lingluo831/mymoteus/docs/架构.md

# Moteus 项目文件结构说明

根目录文件
.bazelrc: Bazel构建系统的配置文件，设置构建选项和预设
.gitignore: Git版本控制忽略文件列表
.travis.yml: Travis CI持续集成配置文件
BUILD: Bazel构建配置文件
CMakeLists.txt: CMake构建系统配置文件
LICENSE: 项目许可证文件
make_release.py: 自动化发布流程的Python脚本
moteus-debug.gdb: GDB调试器配置文件
README.md: 项目概述和使用说明文档
travis-ci.sh: Travis CI构建脚本
tsconfig.json: TypeScript配置文件
WORKSPACE: Bazel工作空间定义文件
configs/ 目录
包含各种硬件和开发套件的配置文件：

20200122-beta-devkit-6008.cfg: 6008型号测试开发套件配置
20200819-devkit-4114.cfg: 4114型号开发套件配置
20210504-qdd100.cfg: QDD100模块配置
20220407-devkit.cfg: 2022年4月版本开发套件配置
20220719-devkit.cfg: 2022年7月版本开发套件配置
docs/ 目录
包含项目文档和图表：

aksim2_adapter.odg/png: aksim2适配器硬件图表
api_brainstorm.md: API设计思路文档
control_structure.odg/png: 控制系统结构图
getting_started.md: 入门指南
io_structure.odg/png: 输入输出接口结构图
moteus_n1_cui_amt21.odg/png: N1型号设计图
power_dist.md: 电源分配说明
raspberry_pi.md: 树莓派集成指南
reference.md: 技术参考文档
fw/ 目录（固件源代码）
主要包含固件源代码和头文件：

传感器和外设接口
as5047.h: AS5047传感器接口
cui_amt21.h: AMT21传感器接口
ma732.h: MA732传感器接口
电机/伺服控制
bldc_servo_position.h/cc: BLDC伺服定位功能
motor_driver.h: 电机驱动器接口
motor_position.h: 电机位置控制
moteus_controller.cc/h: 核心电机控制算法
通信和总线接口
can_bootloader.cc: CAN总线引导程序
fdcan.cc/h: FDCAN总线功能实现
fdcan_micro_server.h: FDCAN微服务器
硬件抽象层
board_debug.cc/h: 板级调试功能
bootloader.h: 引导程序定义
clock_manager.h: 时钟管理
moteus_hw.cc/h: 硬件抽象层
控制算法
foc.cc/h: 磁场定向控制算法
pid.h: PID控制器
simple_pid.h: 简化版PID控制器
工具和系统信息
error.cc/h: 错误处理
firmware_info.cc/h: 固件信息
system_info.cc/h: 系统信息
uuid.cc/h: 唯一标识符处理
hw/ 目录（硬件设计文件）
包含各种硬件设计文档和KiCad文件：

hw/c1/: C1型号板子设计文件
hw/controller/: 控制器板设计文件
hw/ma732_adapter/: MA732适配器设计
hw/n1/: N1型号设计文件
lib/ 目录
包含库文件：

lib/cpp/: C++库文件
lib/python/: Python库文件
qualification/ 目录
硬件/软件性能测试脚本：

pwm_rate.py: PWM频率测试
qdd100_torque_vs_speed.py: QDD100扭矩速度测试
voltage_ripple.py: 电压纹波分析
tools/ 目录
构建和项目管理工具：

bazel: Bazel构建工具
python.bzl: Python构建规则
workspace_status.sh: 工作空间状态脚本
utils/ 目录
实用工具和辅助脚本：

calibrate_encoder.py: 编码器校准
clock_cal.py: 时钟校准
compensate_cogging.py: 齿槽转矩补偿
decode_can_frame.py: CAN帧解码
dynamometer_drive.cc: 测功机控制
firmware_validate.py: 固件验证
moteus_tool.py: Moteus配置工具
plot_cal_phase_currents.py: 相电流校准绘图
tview.py: 文本界面监视器
总结
该项目包含固件代码、硬件设计、多种构建系统配置、测试脚本和各类实用工具。每个文件都在项目的构建、测试、部署和维护中发挥特定作用。如需了解具体文件的详细信息，请查看相应的源代码和注释。

### **1. 电机参数的主要字段**

#### **`BldcServoMotor`**
该结构体定义了电机的物理特性和高级控制模型：

- **`poles`**:  
  电机的极对数。通常由电机的规格决定。例如，8极电机的极对数为 4。

- **`phase_invert`**:  
  是否反转电机的相序。如果电机旋转方向与期望方向相反，可以设置为 `1`。

- **`resistance_ohm`**:  
  电机的相电阻（单位：欧姆）。可以通过测量或从电机规格中获取。

- **`Kv`**:  
  电机的速度常数（单位：RPM/V）。表示每伏电压下的转速。可以通过测量或从电机规格中获取。

- **`offset`**:  
  电气相位偏移，用于校正编码器的相位误差。通常通过校准过程确定。

- **`rotation_current_cutoff_A`**:  
  电流的分界点（单位：安培）。用于高级磁饱和模型。

- **`rotation_current_scale` 和 `rotation_torque_scale`**:  
  用于高级磁饱和模型的比例因子。如果不需要高级模型，可以使用默认值。

- **`cogging_dq_scale` 和 `cogging_dq_comp`**:  
  用于补偿电机齿槽效应的参数。如果电机齿槽效应较小，可以忽略。

---

#### **`BldcServoConfig`**
该结构体定义了电机的运行限制和控制参数：

- **`pwm_rate_hz`**:  
  PWM 频率（单位：Hz）。通常设置为 15kHz 到 60kHz，具体取决于硬件和效率要求。

- **`current_sense_ohm`**:  
  电流采样电阻的阻值（单位：欧姆）。由硬件设计决定。

- **`max_voltage`**:  
  最大输入电压（单位：伏）。根据硬件支持的电压范围设置。

- **`max_power_W`**:  
  最大功率限制（单位：瓦）。可以根据应用需求设置。

- **`max_current_A`**:  
  最大相电流（单位：安培）。通常由硬件的电流能力决定。

- **`derate_temperature` 和 `fault_temperature`**:  
  温度限制（单位：摄氏度）。当温度超过 `derate_temperature` 时，系统会限制输出；超过 `fault_temperature` 时会触发故障。

- **`pid_dq` 和 `pid_position`**:  
  D/Q 电流环和位置环的 PID 参数。需要根据具体电机和应用进行调试。

- **`bemf_feedforward`**:  
  反电动势前馈系数。根据电机的速度常数（`Kv`）计算。

- **`flux_brake_min_voltage` 和 `flux_brake_resistance_ohm`**:  
  用于 Flux Braking 的参数，定义了最小电压阈值和等效电阻。

---

### **2. 参数选择的步骤**

#### **(1) 获取电机规格**
从电机的规格表中获取以下关键参数：
- 极对数（`poles`）
- 相电阻（`resistance_ohm`）
- 速度常数（`Kv`）

#### **(2) 测量或校准**
- **电气相位偏移（`offset`）**:  
  通过固件中的校准功能自动测量。
- **齿槽效应补偿（`cogging_dq_comp`）**:  
  如果需要，可以通过实验测量并配置。

#### **(3) 设置运行限制**
根据硬件能力和应用需求设置以下参数：
- 最大电流（`max_current_A`）
- 最大功率（`max_power_W`）
- 最大电压（`max_voltage`）
- 温度限制（`derate_temperature` 和 `fault_temperature`）

#### **(4) 调试控制参数**
- 调整 D/Q 电流环的 PID 参数（`pid_dq`）。
- 调整位置环的 PID 参数（`pid_position`）。
- 根据需要启用或禁用反电动势前馈（`bemf_feedforward`）。

---

### **3. 参数配置的方法**

#### **通过配置文件**
在配置文件（如 `configs/*.cfg`）中设置参数。例如：
```cfg
motor.poles = 7
motor.resistance_ohm = 0.05
motor.Kv = 120
servo.max_current_A = 30.0
servo.max_voltage = 36.0
servo.pid_dq.kp = 0.01
servo.pid_dq.ki = 20.0
```

#### **通过命令行动态设置**
使用 CAN 或 UART 命令设置参数。例如：
```bash
conf set motor.poles 7
conf set servo.max_current_A 30.0
```

---

### **4. 参数验证**
- 使用 `moteus_tool` 工具验证电机运行状态。
- 检查电流、电压、温度等是否在安全范围内。
- 调整 PID 参数以优化控制性能。

---

### **总结**
电机参数的选择需要结合电机的物理特性、硬件能力和应用需求。通过合理设置 `BldcServoMotor` 和 `BldcServoConfig` 中的参数，可以实现高效、安全的电机控制。
