lingluo831/mymoteus/docs/使用.md

#使用
0使用*wsl -d Ubuntu-22.04*打开wsl
1*python -m moteus_gui.tview*  cmd中使用启动gui命令
2*python3 -m moteus.moteus_tool --target 1 --flash path/to/moteus.elf*烧写固件
3`moteus_tool` 是一个命令行工具，用于与 Moteus 控制器交互，执行配置、校准和调试等操作。以下是 `moteus_tool` 的使用方法和常见命令：

#在windows上编译固件
### 1. **安装必要的工具**
在 Windows 上编译 `moteus` 固件需要以下工具：

#### **(1) 安装 Bazel**
- 从 [Bazel 官方网站](https://bazel.build/) 下载适用于 Windows 的安装程序。
然后改名为bazel.exe，添加到环境变量里面
- 安装完成后，确保 Bazel 可通过命令行访问：
  ```
  bazel --version
  ```

#### **(2) 安装 ARM 工具链**
- 下载并安装 [GNU Arm Embedded Toolchain](https://developer.arm.com/tools-and-software/open-source-software/developer-tools/gnu-toolchain/gnu-rm)。
- 安装完成后，将工具链的 `bin` 目录添加到系统的环境变量 `PATH` 中。

#### **(3) 安装 Python 和依赖**
- 确保已安装 Python 3.10 或更高版本，并安装 `pip`。
- 安装必要的 Python 包：
  ```bash
  python -m pip install --upgrade pip
  python -m pip install pyserial
  ```

#### **(4) 安装 Git**
- 从 [Git 官方网站](https://git-scm.com/) 下载并安装 Git。
- 安装完成后，确保 Git 可通过命令行访问：
  ```bash
  git --version
  ```

---

### 2. **克隆 `moteus` 仓库**
在命令行中运行以下命令以克隆 `moteus` 的代码仓库：
```bash
git clone https://github.com/mjbots/moteus.git
cd moteus
```

---

### 3. **配置 Bazel**
在 Windows 上，Bazel 需要一些额外的配置：
1. 创建一个名为 .bazelrc 的文件（如果不存在）。
2. 添加以下内容以指定工具链路径和编译选项：
   ```plaintext
   build --compiler=clang-cl
   build --cpu=x64_windows
   build --host_cpu=x64_windows
   build --crosstool_top=@bazel_tools//tools/cpp:toolchain
   build --action_env=PATH=<ARM 工具链路径>;<其他必要路径>
   ```

---

### 4. **编译固件**
运行以下命令以编译固件：
```bash
bazel build --config=target //:target
```

编译完成后，固件文件会生成在 `bazel-bin/fw/` 目录下，例如：
- `moteus.elf`：主固件文件。
- `can_bootloader.elf`：引导程序文件。

---

### 5. **刷写固件**
使用 `moteus_tool` 刷写固件：
```bash
python -m moteus.moteus_tool --target 1 --flash path/to/moteus.elf
```

---

### 6. **调试固件**
如果需要调试固件，可以使用 GDB 调试器和 moteus-debug.gdb 配置文件。

---

### 注意事项
- **工具链兼容性**：确保 ARM 工具链版本与 `moteus` 的要求兼容。
- **路径配置**：在 Windows 上，路径分隔符是 `\`，确保在 .bazelrc 和环境变量中正确配置路径。
- **依赖问题**：如果遇到依赖问题，可以尝试手动安装缺失的库或工具。

---

### 1. **运行 `moteus_tool`**
   使用以下命令启动 `moteus_tool`：
   ```bash
   python -m moteus.moteus_tool
   ```

   如果需要与特定设备交互，可以指定目标 ID（`--target` 参数）：
   ```bash
   python -m moteus.moteus_tool --target 1
   ```

---

### 2. **常见命令**
以下是一些常用的 `moteus_tool` 命令：

#### **(1) 查询设备状态**
   查询目标设备的当前状态：
   ```bash
   python -m moteus.moteus_tool --target 1 --query
   ```

#### **(2) 校准电机**
   对电机进行校准（确保电机可以自由旋转）：
   ```bash
   python -m moteus.moteus_tool --target 1 --calibrate
   ```

#### **(3) 设置参数**
   设置控制器参数，例如最大电流：
   ```bash
   python -m moteus.moteus_tool --target 1 --set servo.max_current_A 30.0
   ```

#### **(4) 读取参数**
   读取控制器的当前参数值：
   ```bash
   python -m moteus.moteus_tool --target 1 --get servo.max_current_A
   ```

#### **(5) 保存配置**
   将当前配置保存到控制器的非易失性存储器中：
   ```bash
   python -m moteus.moteus_tool --target 1 --write-config
   ```

#### **(6) 恢复默认配置**
   恢复控制器的默认配置：
   ```bash
   python -m moteus.moteus_tool --target 1 --reset-config
   ```

#### **(7) 控制电机**
   发送命令控制电机，例如设置速度：
   ```bash
   python -m moteus.moteus_tool --target 1 --cmd "d pos nan vel 1.0"
   ```
   其中：
   - `pos nan` 表示不设置位置。
   - `vel 1.0` 表示设置速度为 1.0 转每秒。

---

### 3. **高级用法**
#### **(1) 实时监控**
   使用 `--monitor` 参数实时监控设备状态：
   ```bash
   python -m moteus.moteus_tool --target 1 --monitor
   ```

#### **(2) 记录数据**
   将设备状态输出保存到文件：
   ```bash
   python -m moteus.moteus_tool --target 1 --query > output.txt
   ```

#### **(3) 调试模式**
   启用调试模式以获取更多日志信息：
   ```bash
   python -m moteus.moteus_tool --target 1 --debug
   ```

---

### 4. **帮助命令**
   查看 `moteus_tool` 的所有可用选项和命令：
   ```bash
   python -m moteus.moteus_tool --help
   ```

---

### 5. **注意事项**
   - **目标 ID**：`--target` 参数用于指定目标设备的 CAN ID。如果未指定，默认会尝试与 ID 为 1 的设备通信。
   - **硬件连接**：确保设备通过 CAN 或 UART 正确连接到电脑。
   - **校准前检查**：在校准电机之前，确保电机可以自由旋转，否则可能损坏设备。

---

如果你有具体的使用场景或问题，请提供更多细节，我可以为你提供更具体的帮助！
