lingluo831/mymoteus/docs/aksim2_adapter.png

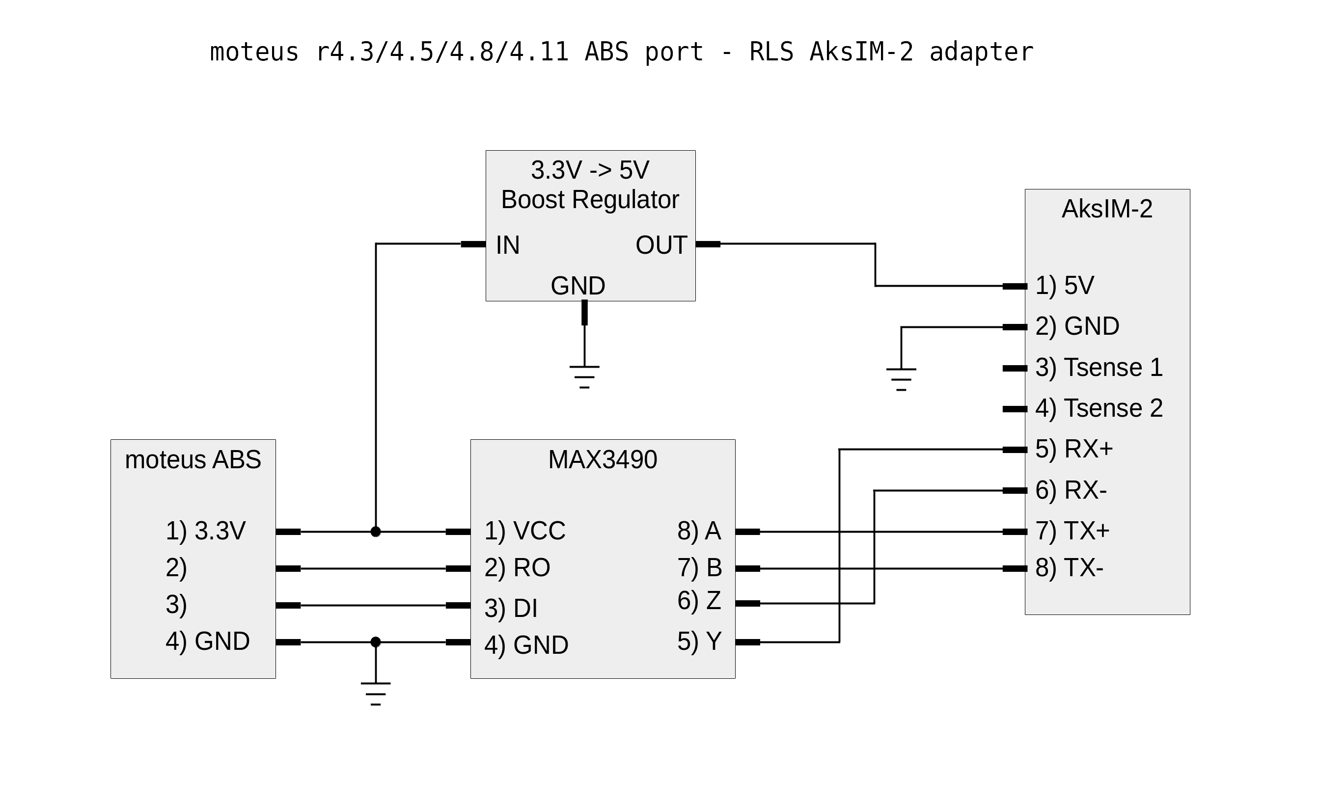
docs/aksim2_adapter.png
