lingluo831/mymoteus/docs/moteus_n1_cui_amt21.png

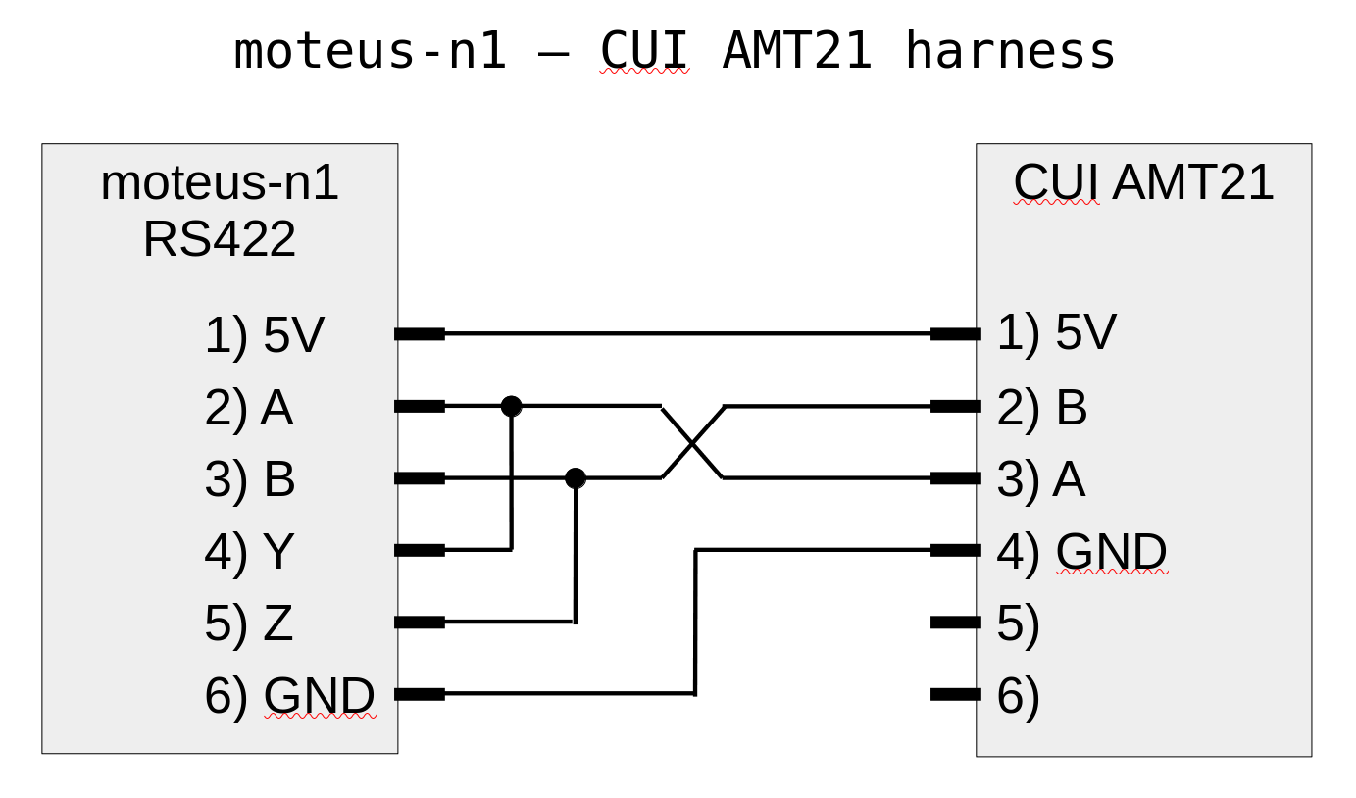
docs/moteus_n1_cui_amt21.png
