lingluo831/mymoteus/hw/c1/3d/S6B-ZR-SM4A-TF_LF__SN_.step

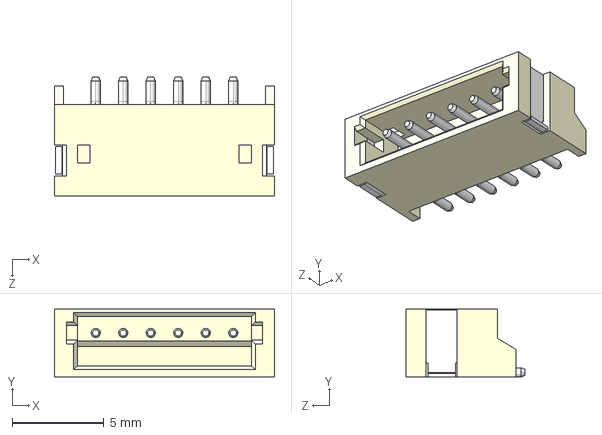
[picture p5: CAD file, 2025-04-23]
hw/c1/3d/S6B-ZR-SM4A-TF_LF__SN_.step
12.0 x 3.70 x 6.50 mm
