lingluo831/mymoteus/hw/c1/3d/DRB0008F.stp

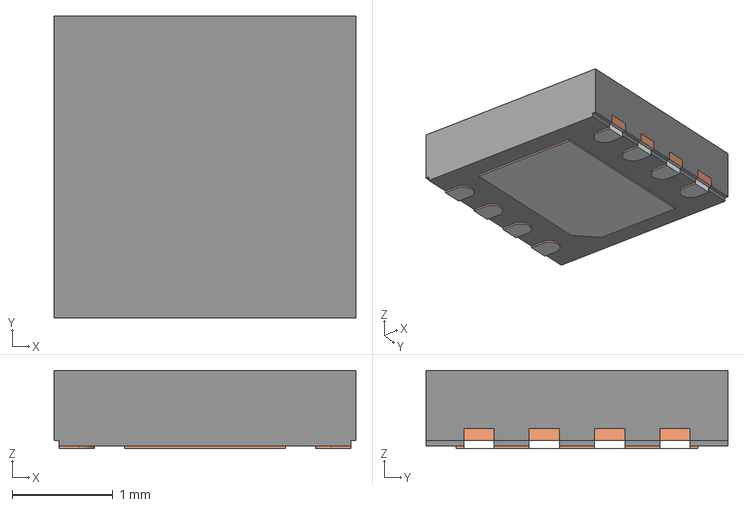
[picture p6: CAD file, 2025-04-23]
hw/c1/3d/DRB0008F.stp
3.00 x 3.00 x 0.775 mm
BODY-SON_AF0
FRAME-DRB0008F_AF0
