lingluo831/mymoteus/hw/c1/3d/XT30PW-M.step

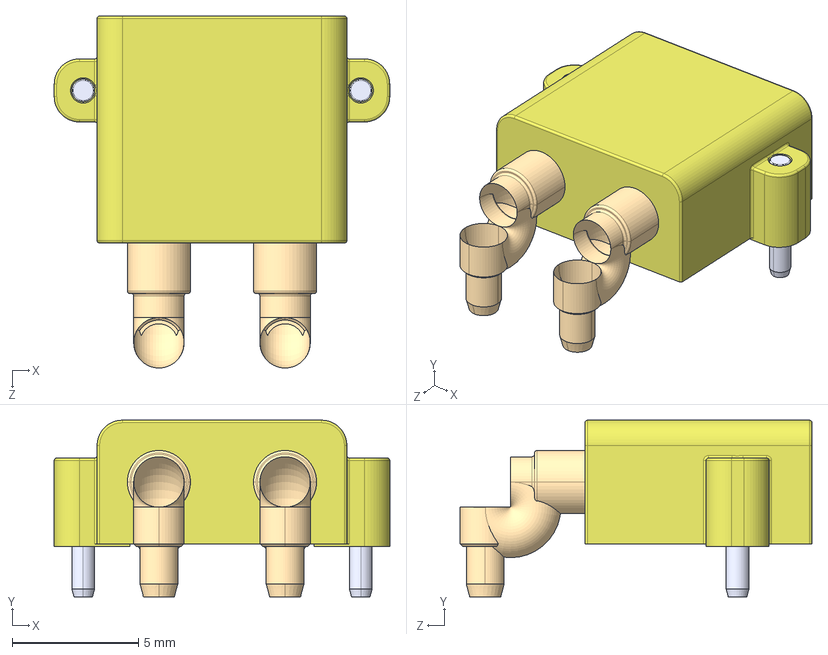
[picture p7: CAD file, 2025-04-23]
hw/c1/3d/XT30PW-M.step
13.3 x 7.00 x 14.0 mm
