lingluo831/mymoteus/hw/c1/3d/SOD-523_STM.step

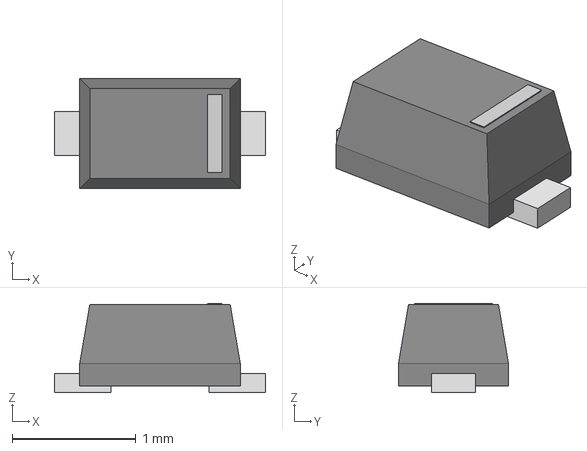
[picture p8: CAD file, 2025-04-23]
hw/c1/3d/SOD-523_STM.step
1.70 x 0.888 x 0.718 mm
