lingluo831/mymoteus/hw/c1/3d/S3B-PH-SM4-TB_LF__SN_.step

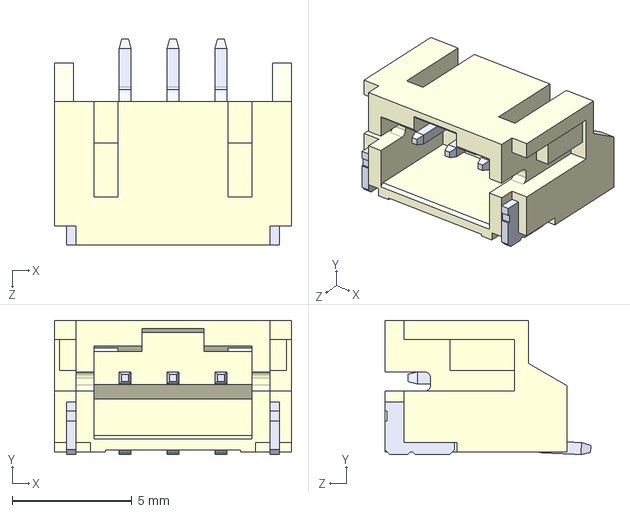
[picture p9: CAD file, 2025-04-23]
hw/c1/3d/S3B-PH-SM4-TB_LF__SN_.step
9.90 x 5.60 x 8.60 mm
