lingluo831/mymoteus/hw/c1/3d/TSSOP14_OSM.step

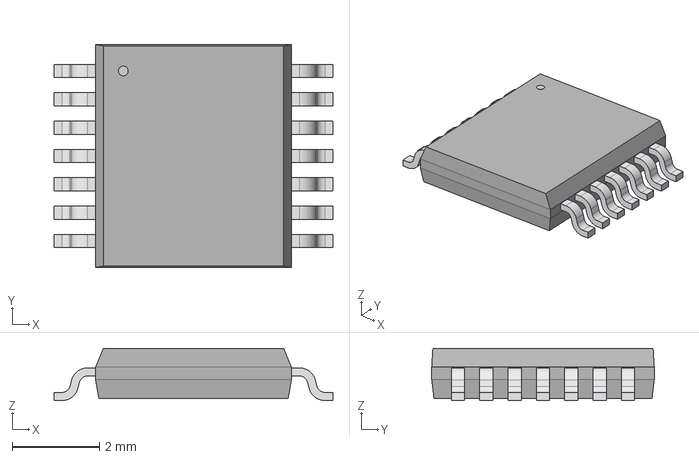
[picture p10: CAD file, 2025-04-23]
hw/c1/3d/TSSOP14_OSM.step
6.40 x 5.11 x 1.20 mm
