lingluo831/mymoteus/hw/c1/3d/IND_4018-WE-LQS_WRE.step

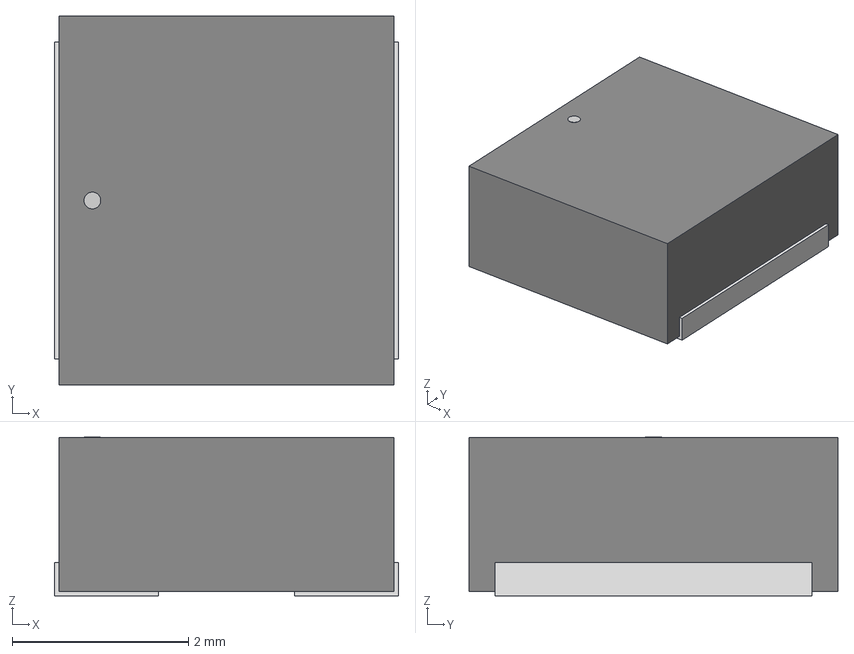
[picture p11: CAD file, 2025-04-23]
hw/c1/3d/IND_4018-WE-LQS_WRE.step
3.91 x 4.19 x 1.81 mm
