lingluo831/mymoteus/hw/c1/3d/DSE0006A.stp

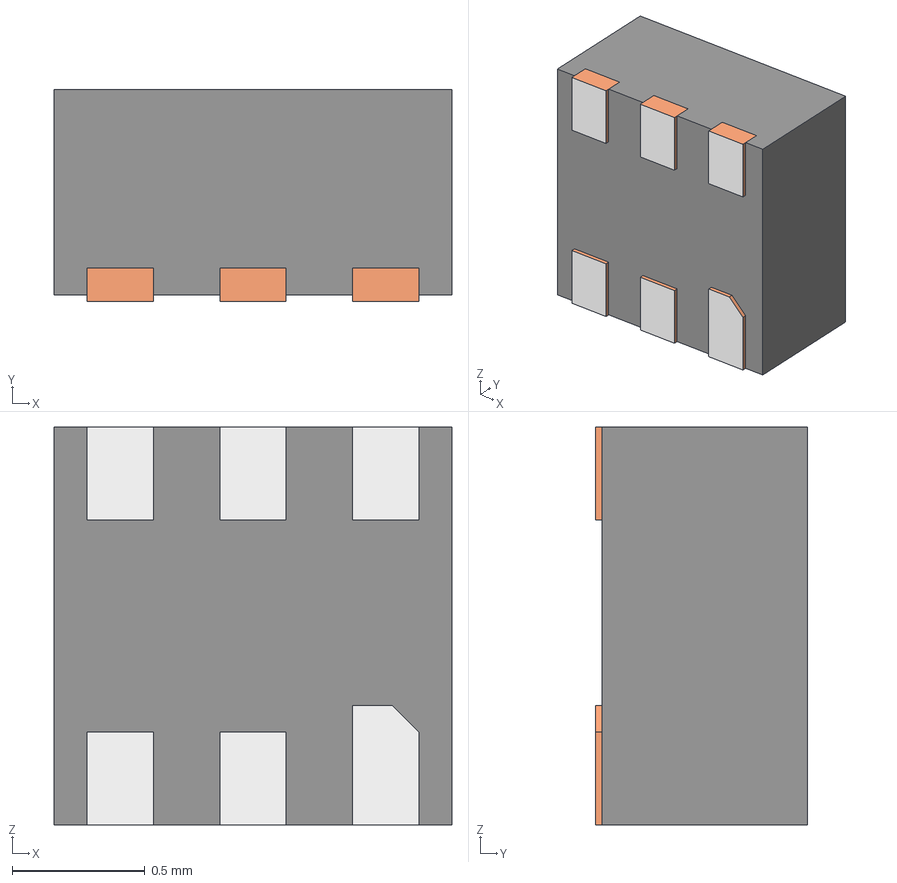
[picture p12: CAD file, 2025-04-23]
hw/c1/3d/DSE0006A.stp
1.50 x 0.8 x 1.50 mm
BODY-SON
FRAME-DSE0006A
