lingluo831/mymoteus/hw/c1/3d/RTA0040B.stp

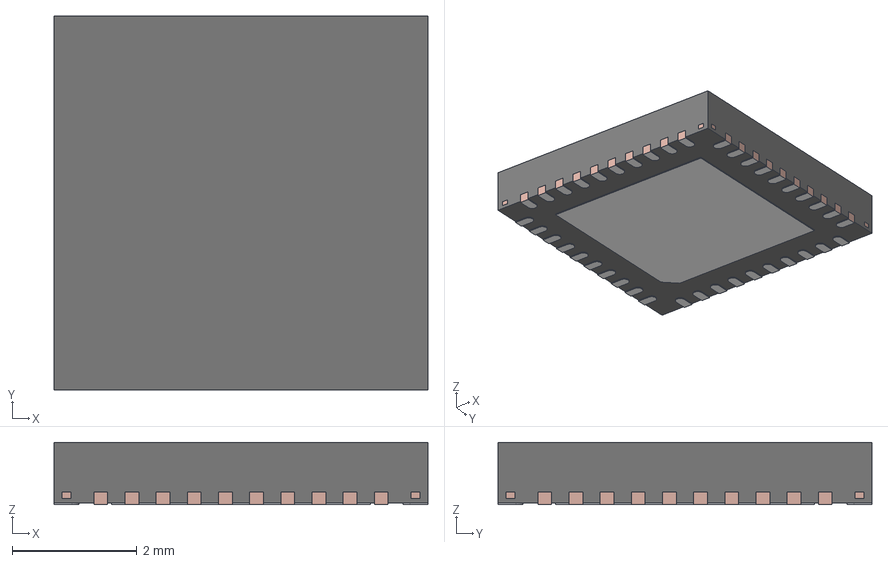
[picture p13: CAD file, 2025-04-23]
hw/c1/3d/RTA0040B.stp
6.00 x 6.00 x 1.00 mm
FRAME
