lingluo831/mymoteus/hw/c1/3d/SM07B-GHS-TB-LF--SN---3DModel-STEP-56544.STEP

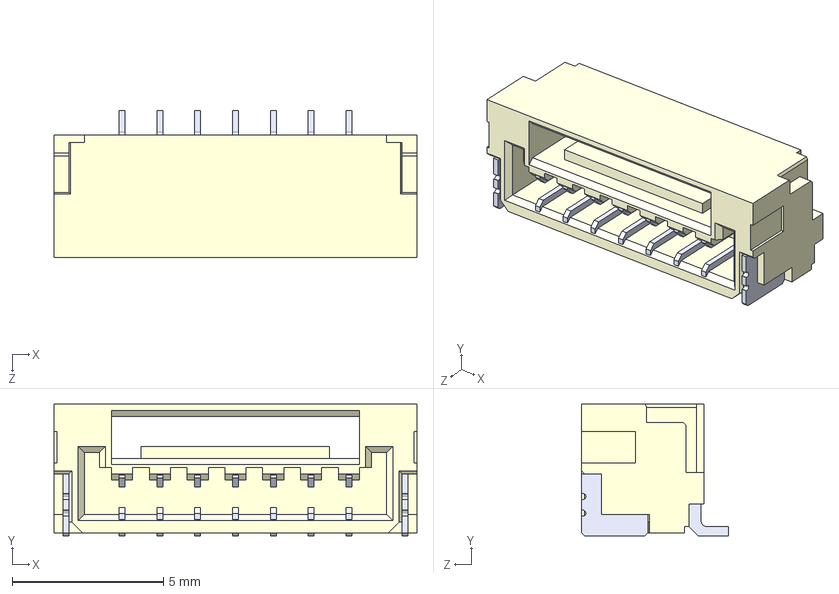
[picture p14: CAD file, 2025-04-23]
hw/c1/3d/SM07B-GHS-TB-LF--SN---3DModel-STEP-56544.STEP
12.0 x 4.35 x 4.85 mm
