lingluo831/mymoteus/hw/c1/3d/UFQFPN-48_7X7X0P55MM.step

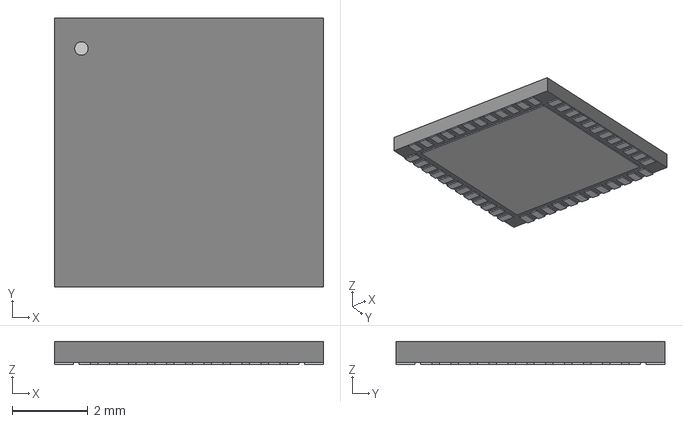
[picture p15: CAD file, 2025-04-23]
hw/c1/3d/UFQFPN-48_7X7X0P55MM.step
7.11 x 7.11 x 0.612 mm
