lingluo831/mymoteus/hw/c1/3d/TSON Advance.step

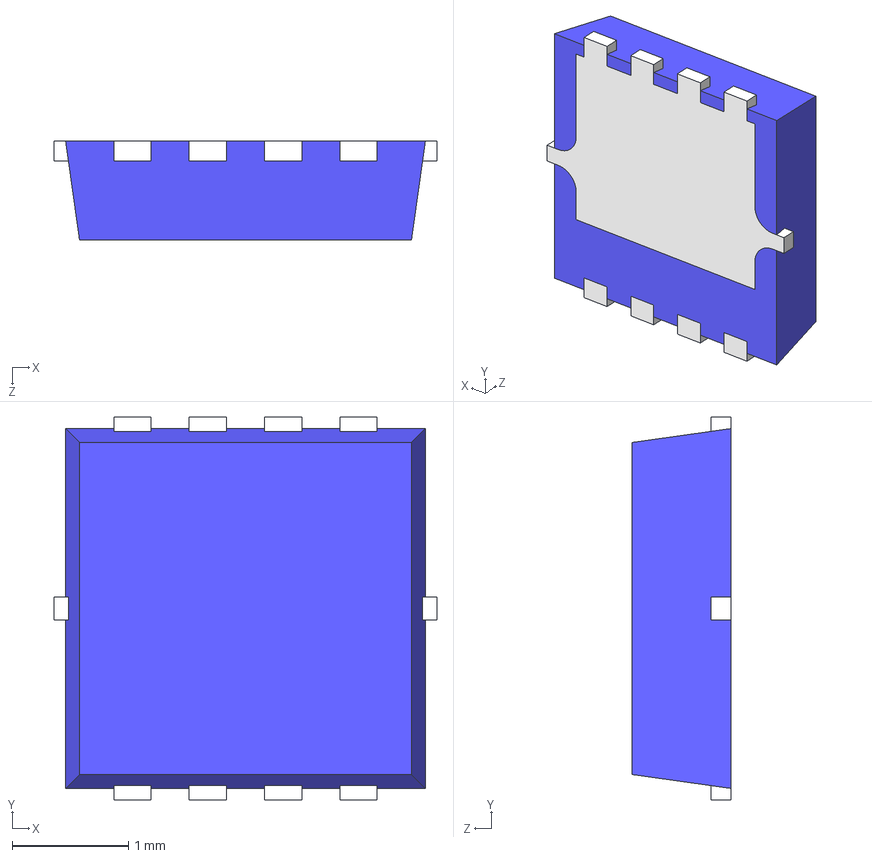
[picture p16: CAD file, 2025-04-23]
hw/c1/3d/TSON Advance.step
3.30 x 3.30 x 0.85 mm
