lingluo831/mymoteus/hw/c1/3d/21-0487A_MXM.step

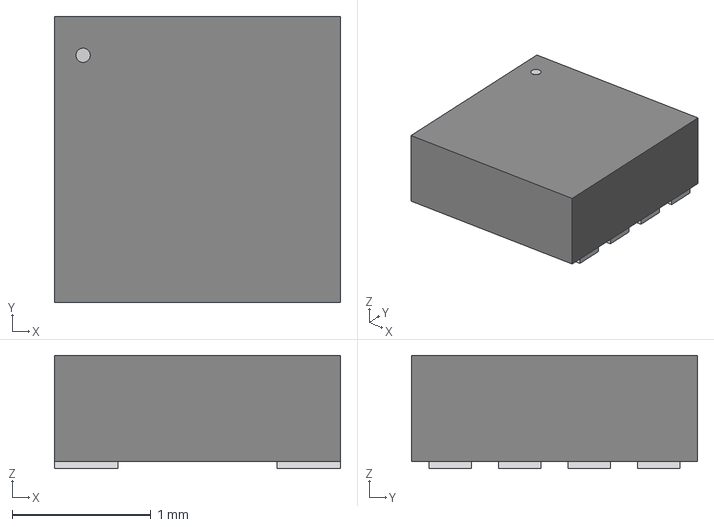
[picture p17: CAD file, 2025-04-23]
hw/c1/3d/21-0487A_MXM.step
2.06 x 2.06 x 0.815 mm
