lingluo831/mymoteus/hw/c1/r1.2/20240305-moteus-c1-r1_2.step

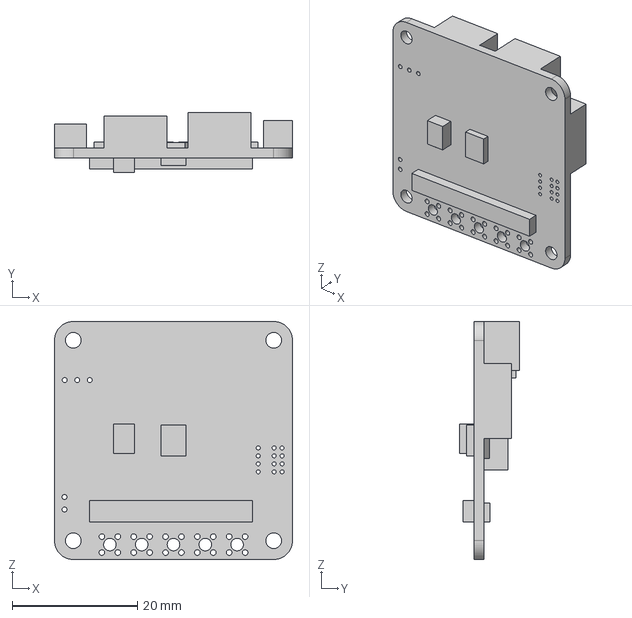
[picture p18: CAD file, 2025-04-23]
hw/c1/r1.2/20240305-moteus-c1-r1_2.step
38.0 x 9.50 x 38.0 mm
