lingluo831/mymoteus/hw/controller/r4.3/20200729-moteus-controller-r43-mechanical.step

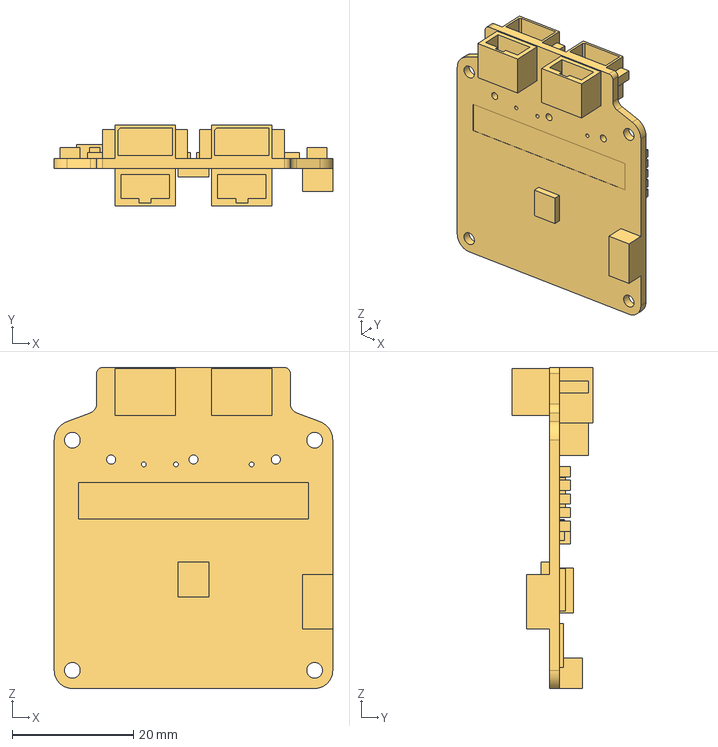
[picture p19: CAD file, 2025-04-23]
hw/controller/r4.3/20200729-moteus-controller-r43-mechanical.step
46.0 x 13.4 x 53.0 mm
