lingluo831/mymoteus/hw/n1/r1.2/20230226-moteus-n1-mechanical.step

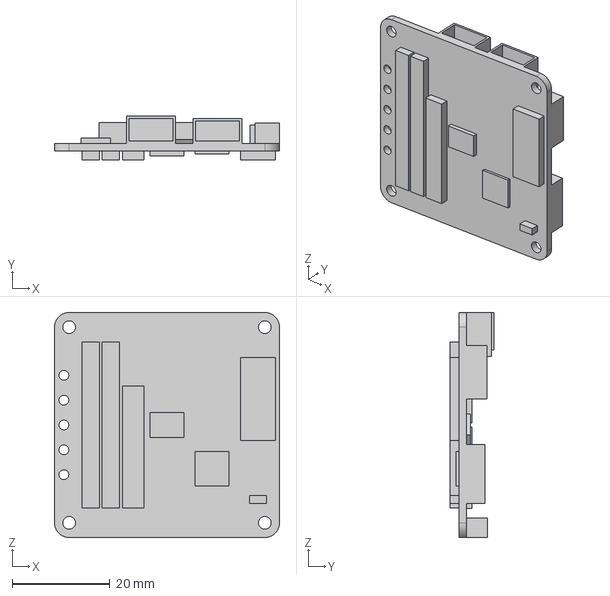
[picture p20: CAD file, 2025-04-23]
hw/n1/r1.2/20230226-moteus-n1-mechanical.step
46.0 x 9.00 x 46.0 mm
