lingluo831/mymoteus/hw/n1/r1.3/20230523-moteus-n1-r1_3-mechanical.step

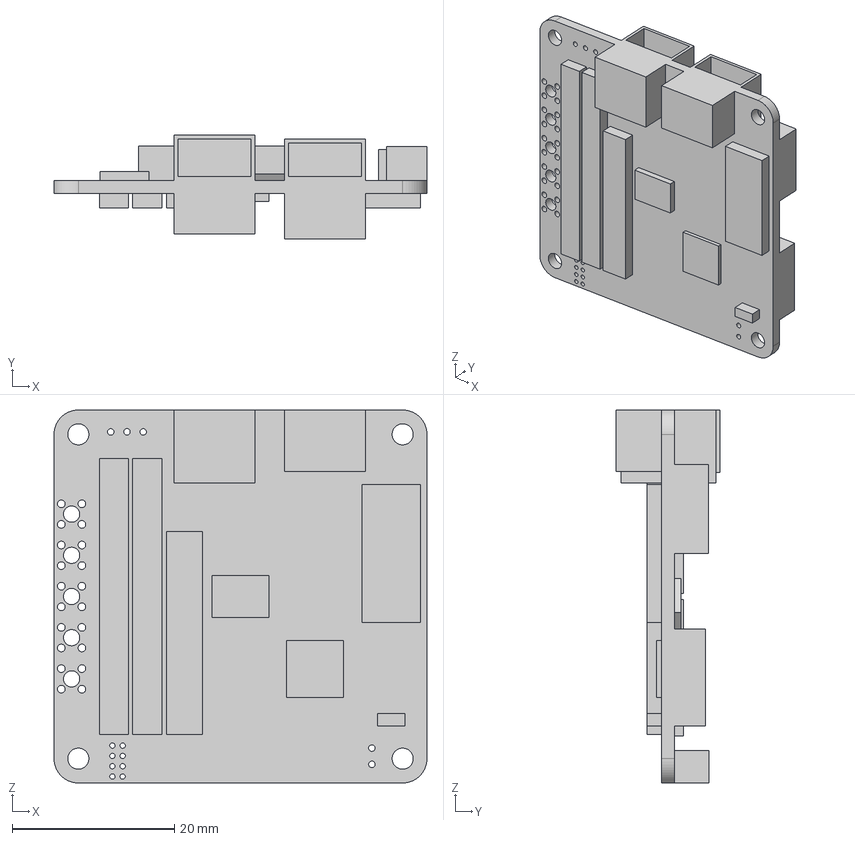
[picture p21: CAD file, 2025-04-23]
hw/n1/r1.3/20230523-moteus-n1-r1_3-mechanical.step
46.0 x 12.8 x 46.0 mm
