lingluo831/mymoteus/(list of files, cad)

Other CAD files:
hw/controller/r4.5/20210124-moteus-controller-r45-mechanical.step
