lingluo831/mymoteus/hw/n1/r1.3/moteus_n1_yuanli.pdf

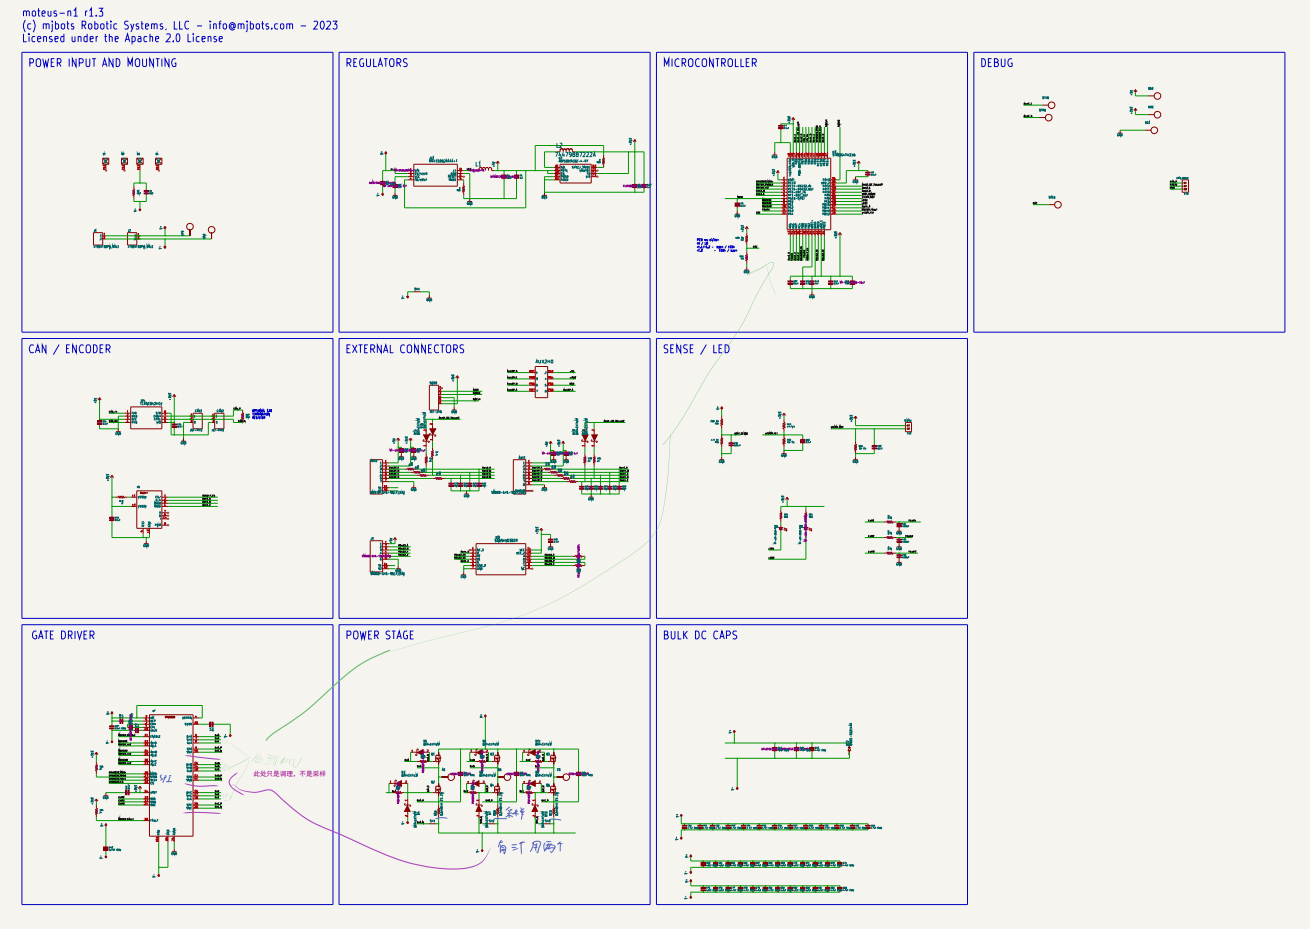
[picture p22: page 1]
