lingluo831/mymoteus/hw/c1/moteus_c1.kicad_pcb

## KiCad design hw/c1/moteus_c1.kicad_pcb (2025-04-23)

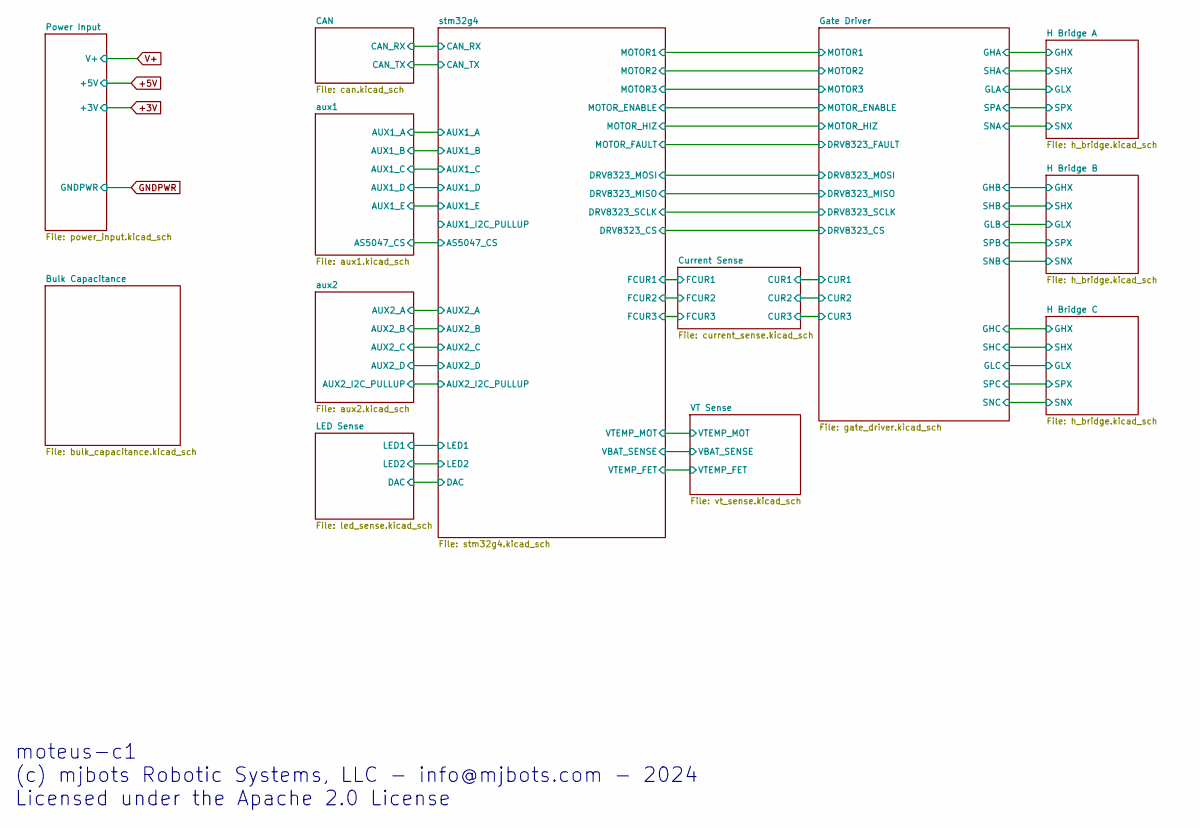
[picture p23: schematic moteus_c1.kicad_sch, moteus-c1]

Notes on the sheet:
moteus-c1 (c) mjbots Robotic Systems, LLC - info@mjbots.com - 2024 Licensed under the Apache 2.0 License

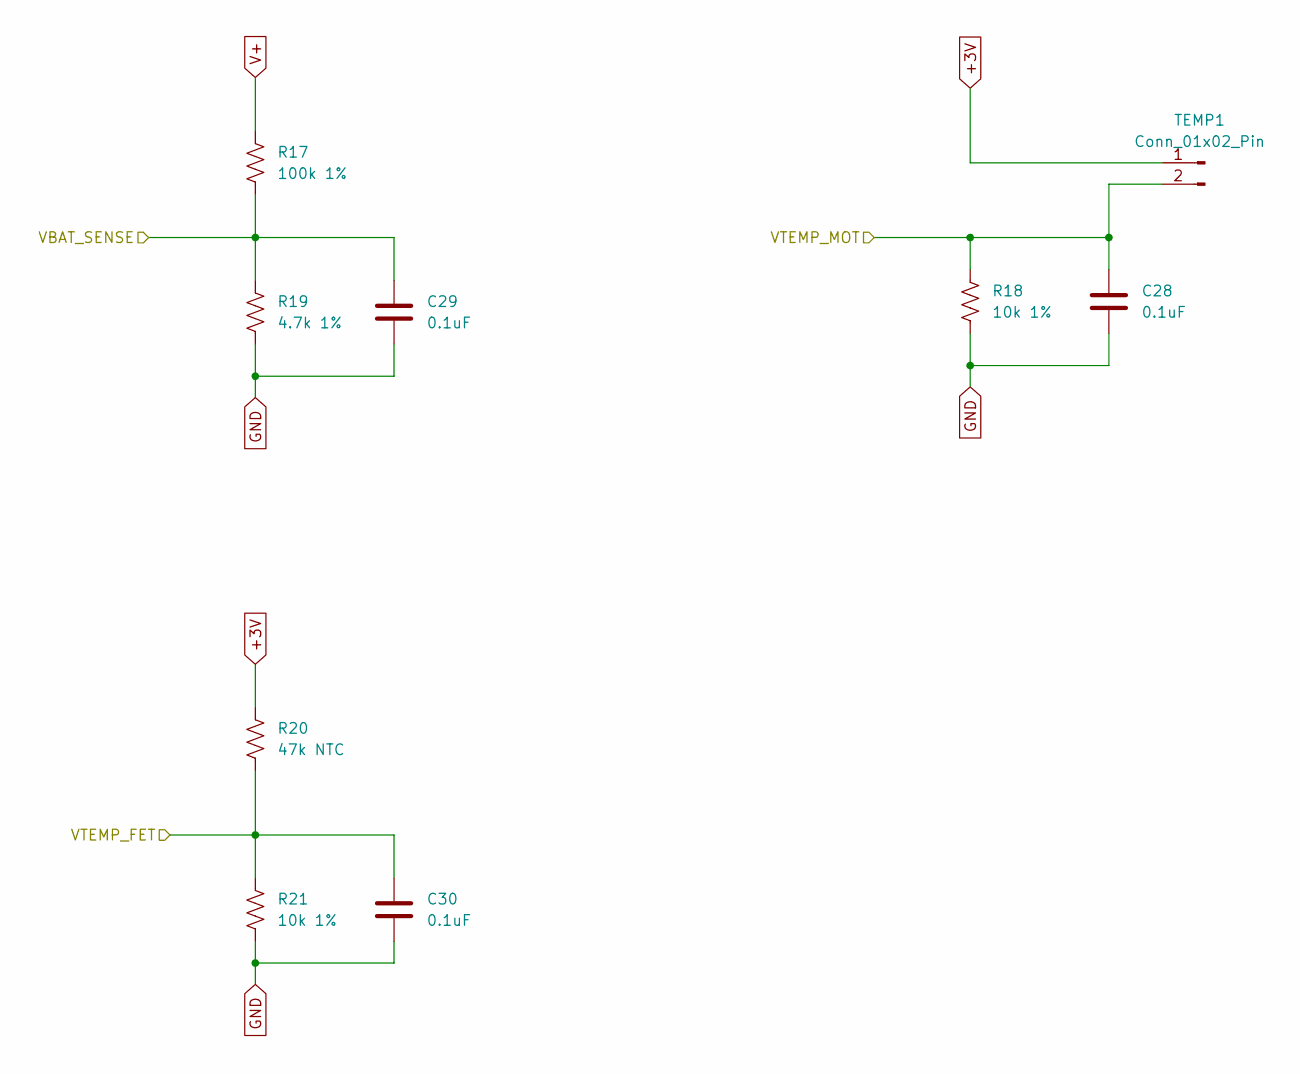
[picture p24: schematic vt_sense.kicad_sch, moteus-c1]

Parts:
C28, C29, C30: 0.1uF; C_0402_1005Metric; MPN MF-CAP-0402-0.1uF
R17: 100k 1%; R_0402_1005Metric; MPN RC0402FR-07100KL
R18, R21: 10k 1%; R_0402_1005Metric; MPN RC0402FR-0710KL
R19: 4.7k 1%; R_0402_1005Metric; MPN RC0402FR-074K7L
R20: 47k NTC; R_0402_1005Metric; MPN NCP15WB473F03RC
TEMP1: Conn_01x02_Pin; PinHeader_1x02_P2.00mm_Vertical

Connections:
/VT Sense/VBAT_SENSE: C29.1, R17.2, R19.1; also elsewhere on the board
/VT Sense/VTEMP_FET: C30.1, R20.2, R21.1; also elsewhere on the board
/VT Sense/VTEMP_MOT: C28.1, R18.1, TEMP1.2; also elsewhere on the board
V+: R17.1; also elsewhere on the board

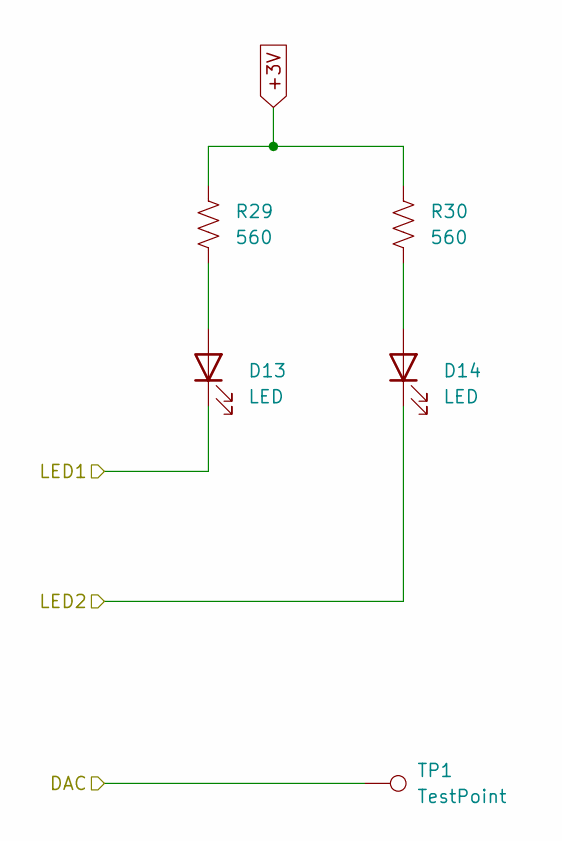
[picture p25: schematic led_sense.kicad_sch, moteus-c1]

Parts:
D13: LED; LED_0603_1608Metric; MPN MF-LED-0603-RED
D14: LED; LED_0603_1608Metric; MPN MF-LED-0603-GREEN
R29, R30: 560; R_0402_1005Metric; MPN MF-RES-0402-560
TP1: TestPoint; TestPoint_THTPad_D1.0mm_Drill0.5mm

Connections:
/LED Sense/LED1: D13.1 (K); also elsewhere on the board
/LED Sense/LED2: D14.1 (K); also elsewhere on the board
unnamed: D13.2 (A), R29.2
unnamed: D14.2 (A), R30.2

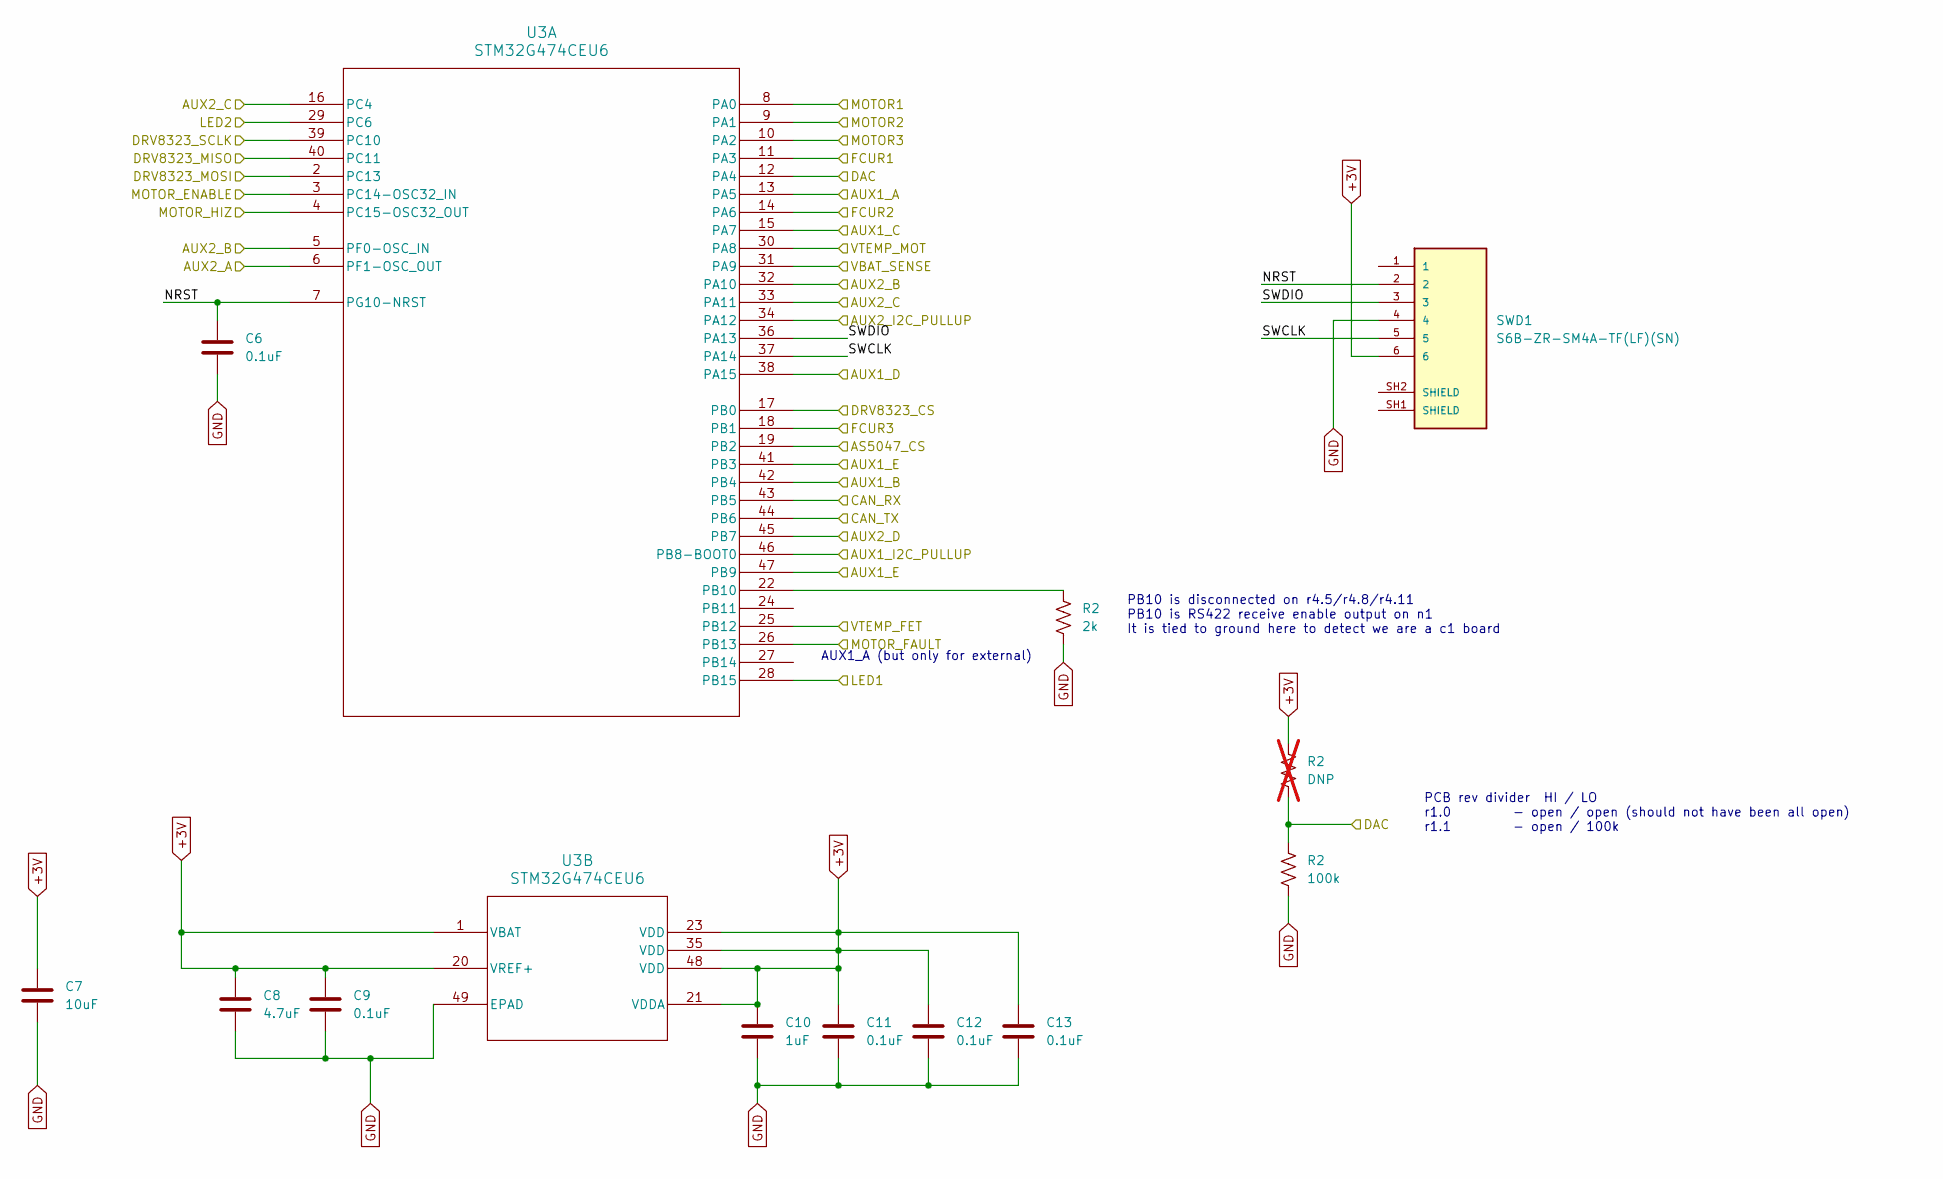
[picture p26: schematic stm32g4.kicad_sch, moteus-c1]

Parts:
C6, C9, C11, C12, C13: 0.1uF; C_0402_1005Metric; MPN MF-CAP-0402-0.1uF
C7: 10uF; C_1206_3216Metric; MPN MF-CAP-1206-10uF
C8: 4.7uF; C_0603_1608Metric; MPN CL10A475KP8NNNC
C10: 1uF; C_0402_1005Metric; MPN MF-CAP-0402-1uF
R2: 2k; R_0402_1005Metric; MPN MF-RES-0402-2K
SWD1: S6B-ZR-SM4A-TF(LF)(SN); JST_S6B-ZR-SM4A-TF(LF)(SN); MPN S6B-ZR-SM4A-TF(LF)(SN)
U3: STM32G474CEU6; UFQFPN-48_7X7X0P55MM; MPN STM32G474CEU6

Connections:
/CAN/CAN_RX: U3.43 (PB5); also elsewhere on the board
/CAN/CAN_TX: U3.44 (PB6); also elsewhere on the board
/Current Sense/FCUR1: U3.11 (PA3); also elsewhere on the board
/Current Sense/FCUR2: U3.14 (PA6); also elsewhere on the board
/Current Sense/FCUR3: U3.18 (PB1); also elsewhere on the board
/Gate Driver/DRV8323_CS: U3.17 (PB0); also elsewhere on the board
/Gate Driver/DRV8323_FAULT: U3.26 (PB13); also elsewhere on the board
/Gate Driver/DRV8323_MOSI: U3.2 (PC13); also elsewhere on the board
/Gate Driver/DRV8323_SCLK: U3.39 (PC10); also elsewhere on the board
/Gate Driver/MOTOR1: U3.8 (PA0); also elsewhere on the board
/Gate Driver/MOTOR2: U3.9 (PA1); also elsewhere on the board
/Gate Driver/MOTOR3: U3.10 (PA2); also elsewhere on the board
/Gate Driver/MOTOR_ENABLE: U3.3 (PC14-OSC32_IN); also elsewhere on the board
/Gate Driver/MOTOR_HIZ: U3.4 (PC15-OSC32_OUT); also elsewhere on the board
/LED Sense/LED1: U3.28 (PB15); also elsewhere on the board
/LED Sense/LED2: U3.29 (PC6); also elsewhere on the board
/VT Sense/VBAT_SENSE: U3.31 (PA9); also elsewhere on the board
/VT Sense/VTEMP_FET: U3.25 (PB12); also elsewhere on the board
/VT Sense/VTEMP_MOT: U3.30 (PA8); also elsewhere on the board
/aux1/AS5047_CS: U3.19 (PB2); also elsewhere on the board
/aux1/AUX1_A: U3.13 (PA5); also elsewhere on the board
/aux1/AUX1_B: U3.42 (PB4); also elsewhere on the board
/aux1/AUX1_C: U3.15 (PA7); also elsewhere on the board
/aux1/AUX1_D: U3.38 (PA15); also elsewhere on the board
/aux1/AUX1_E: U3.41 (PB3), U3.47 (PB9); also elsewhere on the board
/aux2/AUX2_A: U3.6 (PF1-OSC_OUT); also elsewhere on the board
/aux2/AUX2_B: U3.5 (PF0-OSC_IN), U3.32 (PA10); also elsewhere on the board
/aux2/AUX2_C: U3.16 (PC4), U3.33 (PA11); also elsewhere on the board
/aux2/AUX2_D: U3.45 (PB7); also elsewhere on the board
/aux2/AUX2_I2C_PULLUP: U3.34 (PA12); also elsewhere on the board
/stm32g4/AUX1_I2C_PULLUP: U3.46 (PB8-BOOT0)
/stm32g4/NRST: C6.1, SWD1.2, U3.7 (PG10-NRST)
/stm32g4/SWCLK: SWD1.5, U3.37 (PA14)
/stm32g4/SWDIO: SWD1.3, U3.36 (PA13)

Parts of its further copies:
R31: 2k; R_0402_1005Metric; MPN MF-RES-0402-2K

Notes on the sheet:
PB10 is disconnected on r4.5/r4.8/r4.11 PB10 is RS422 receive enable output on n1 It is tied to ground here to detect we are a c1 board
PCB rev divider HI / LO r1.0 - open / open (should not have been all open) r1.1 - open / 100k
AUX1_A (but only for external)

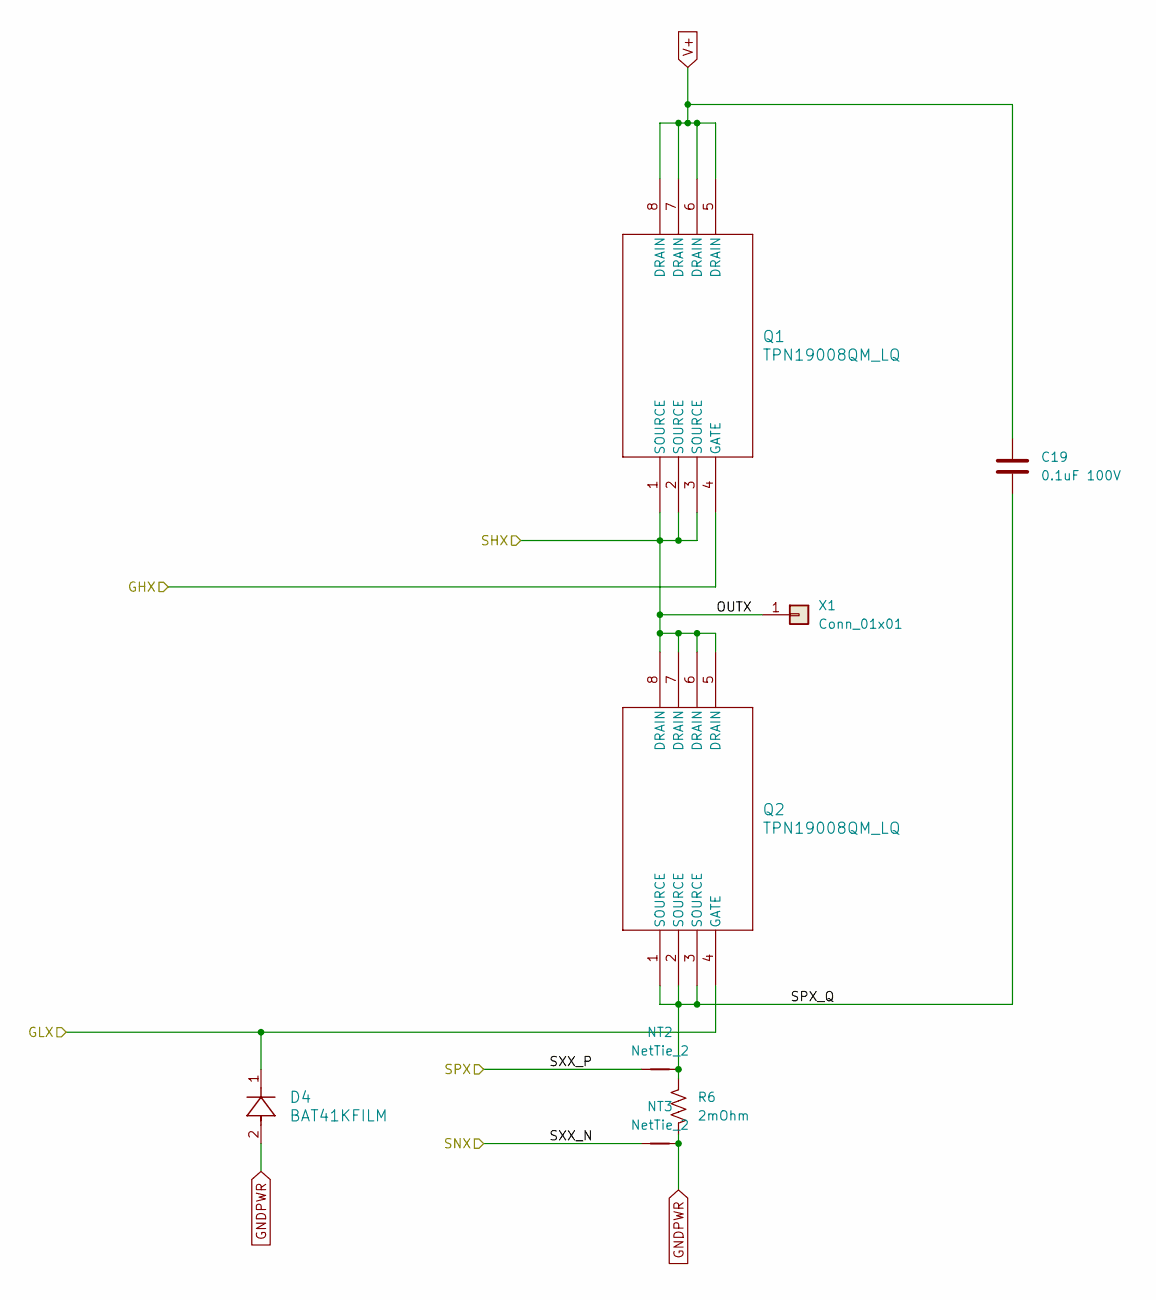
[picture p27: schematic h_bridge.kicad_sch, moteus-c1]

Parts:
C19: 0.1uF 100V; C_1206_3216Metric; MPN 12061C104KAT2A
D4: BAT41KFILM; SOD-523_STM; MPN BAT41KFILM
NT2, NT3: NetTie_2; NetTie-2_SMD_Pad0.2
Q1, Q2: TPN19008QM_LQ; TSON Advance_TOS; MPN TPN19008QM,LQ
R6: 2mOhm; R_0805_2012Metric; MPN CSSH0805FT2L00
X1: Conn_01x01; POWER_M2.5

Connections:
/Gate Driver/GHA: Q1.4 (GATE); also elsewhere on the board
/Gate Driver/GLA: D4.1, Q2.4 (GATE); also elsewhere on the board
/H Bridge A/OUTX: Q1.1 (SOURCE), Q1.2 (SOURCE), Q1.3 (SOURCE), Q2.5 (DRAIN), Q2.6 (DRAIN), Q2.7 (DRAIN), Q2.8 (DRAIN), X1.1; also elsewhere on the board
/H Bridge A/SPX_Q: C19.2, NT2.2, Q2.1 (SOURCE), Q2.2 (SOURCE), Q2.3 (SOURCE), R6.1
/H Bridge A/SXX_N: NT3.1; also elsewhere on the board
/H Bridge A/SXX_P: NT2.1; also elsewhere on the board
GNDPWR: D4.2, NT3.2, R6.2; also elsewhere on the board
V+: C19.1, Q1.5 (DRAIN), Q1.6 (DRAIN), Q1.7 (DRAIN), Q1.8 (DRAIN); also elsewhere on the board

Parts of its further copies:
C20, C21: 0.1uF 100V; C_1206_3216Metric; MPN 12061C104KAT2A
D7, D10: BAT41KFILM; SOD-523_STM; MPN BAT41KFILM
NT4, NT5, NT6, NT7: NetTie_2; NetTie-2_SMD_Pad0.2
Q3, Q4, Q5, Q6: TPN19008QM_LQ; TSON Advance_TOS; MPN TPN19008QM,LQ
R9, R12: 2mOhm; R_0805_2012Metric; MPN CSSH0805FT2L00
X2, X3: Conn_01x01; POWER_M2.5

Connections of its further copies:
/Gate Driver/GHB: Q3.4 (GATE); also elsewhere on the board
/Gate Driver/GHC: Q5.4 (GATE); also elsewhere on the board
/Gate Driver/GLB: D7.1, Q4.4 (GATE); also elsewhere on the board
/Gate Driver/GLC: D10.1, Q6.4 (GATE); also elsewhere on the board
/H Bridge B/OUTX: Q3.1 (SOURCE), Q3.2 (SOURCE), Q3.3 (SOURCE), Q4.5 (DRAIN), Q4.6 (DRAIN), Q4.7 (DRAIN), Q4.8 (DRAIN), X2.1; also elsewhere on the board
/H Bridge B/SPX_Q: C20.2, NT4.2, Q4.1 (SOURCE), Q4.2 (SOURCE), Q4.3 (SOURCE), R9.1
/H Bridge B/SXX_N: NT5.1; also elsewhere on the board
/H Bridge B/SXX_P: NT4.1; also elsewhere on the board
/H Bridge C/OUTX: Q5.1 (SOURCE), Q5.2 (SOURCE), Q5.3 (SOURCE), Q6.5 (DRAIN), Q6.6 (DRAIN), Q6.7 (DRAIN), Q6.8 (DRAIN), X3.1; also elsewhere on the board
/H Bridge C/SPX_Q: C21.2, NT6.2, Q6.1 (SOURCE), Q6.2 (SOURCE), Q6.3 (SOURCE), R12.1
/H Bridge C/SXX_N: NT7.1; also elsewhere on the board
/H Bridge C/SXX_P: NT6.1; also elsewhere on the board
GNDPWR: D7.2, D10.2, NT5.2, NT7.2, R9.2, R12.2; also elsewhere on the board
V+: C20.1, C21.1, Q3.5 (DRAIN), Q3.6 (DRAIN), Q3.7 (DRAIN), Q3.8 (DRAIN), Q5.5 (DRAIN), Q5.6 (DRAIN), Q5.7 (DRAIN), Q5.8 (DRAIN); also elsewhere on the board

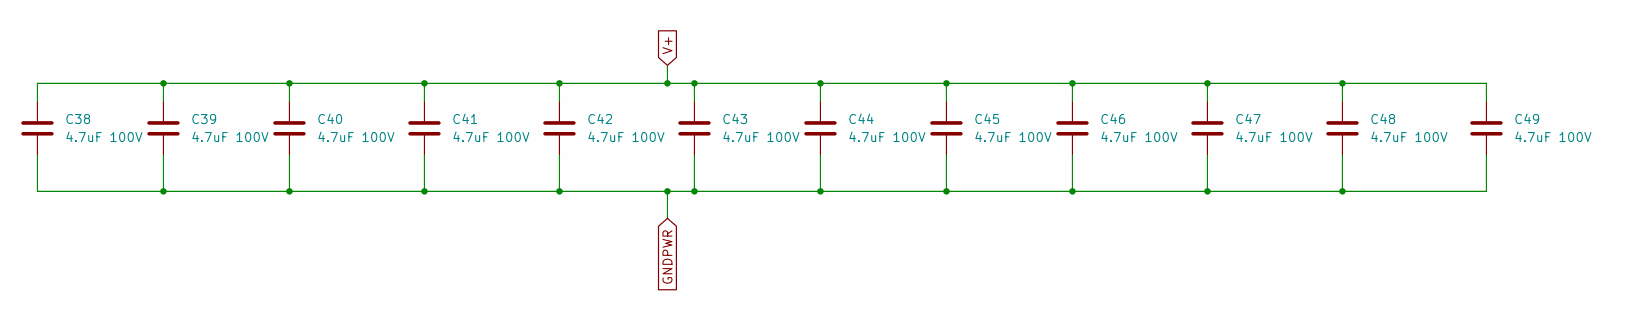
[picture p28: schematic bulk_capacitance.kicad_sch, moteus-c1]

Parts:
C38, C39, C40, C41, C42, C43, C44, C45, C46, C47, C48, C49: 4.7uF 100V; C_1206_3216Metric; MPN GRJ31CC72A475KE01K

Connections:
GNDPWR: C38.2, C39.2, C40.2, C41.2, C42.2, C43.2, C44.2, C45.2, C46.2, C47.2, C48.2, C49.2; also elsewhere on the board
V+: C38.1, C39.1, C40.1, C41.1, C42.1, C43.1, C44.1, C45.1, C46.1, C47.1, C48.1, C49.1; also elsewhere on the board

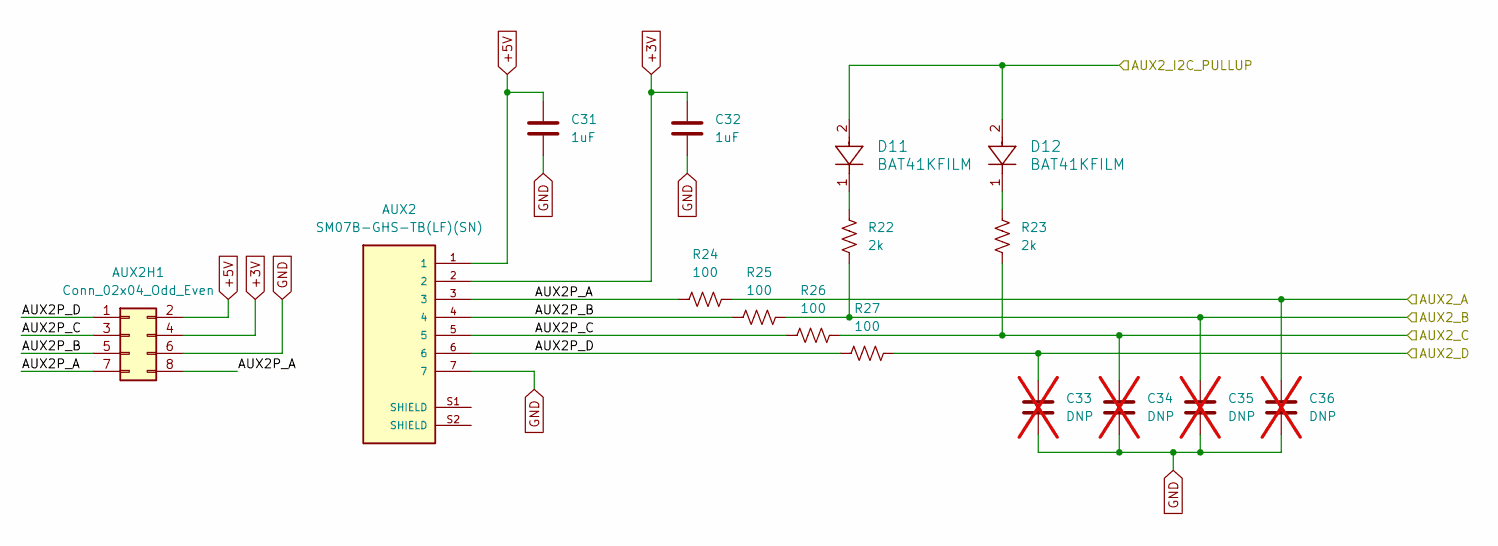
[picture p29: schematic aux2.kicad_sch, moteus-c1]

Parts:
AUX2: SM07B-GHS-TB(LF)(SN); JST_SM07B-GHS-TB(LF)(SN); MPN SM07B-GHS-TB(LF)(SN)
AUX2H1: Conn_02x04_Odd_Even; PinHeader_2x04_P1.27mm_Vertical
C31, C32: 1uF; C_0402_1005Metric; MPN MF-CAP-0402-1uF
C33, C34, C35, C36: DNP; C_0402_1005Metric; not fitted
D11, D12: BAT41KFILM; SOD-523_STM; MPN BAT41KFILM
R22, R23: 2k; R_0402_1005Metric; MPN MF-RES-0402-2K
R24, R25, R26, R27: 100; R_0402_1005Metric; MPN MF-RES-0402-100

Connections:
+5V: AUX2.1, AUX2H1.2, C31.1; also elsewhere on the board
/aux2/AUX2P_B: AUX2.4, AUX2H1.5, R25.1
/aux2/AUX2P_C: AUX2.5, AUX2H1.3, R26.1
/aux2/AUX2P_D: AUX2.6, AUX2H1.1, R27.1
/aux2/AUX2_A: C36.1, R24.2; also elsewhere on the board
/aux2/AUX2_B: C35.1, R22.2, R25.2; also elsewhere on the board
/aux2/AUX2_C: C34.1, R23.2, R26.2; also elsewhere on the board
/aux2/AUX2_D: C33.1, R27.2; also elsewhere on the board
/aux2/AUX2_I2C_PULLUP: D11.2, D12.2; also elsewhere on the board
unnamed: D11.1, R22.1
unnamed: D12.1, R23.1

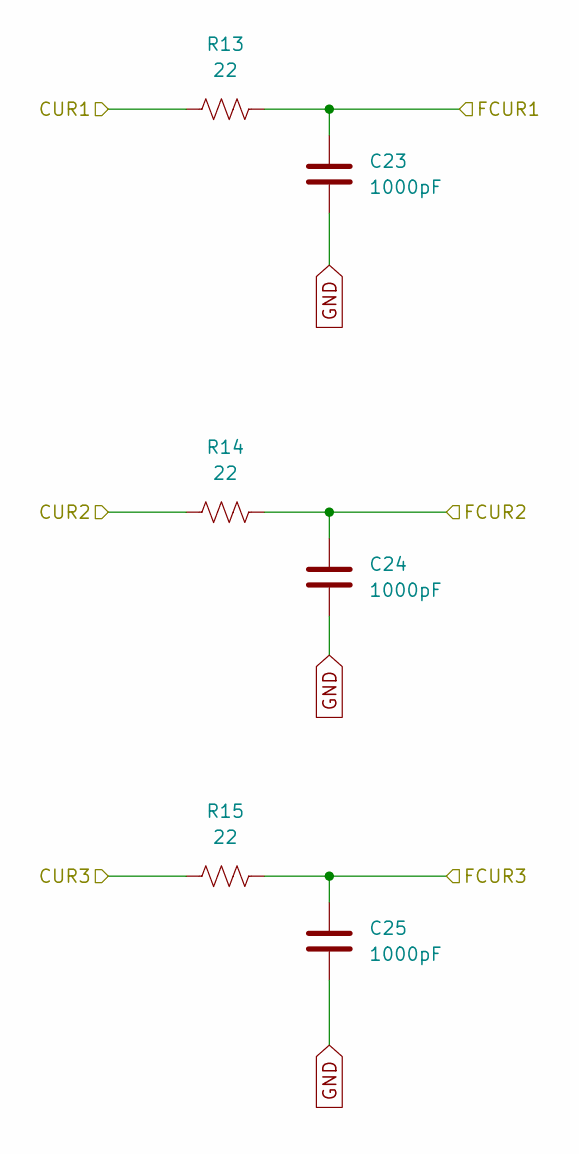
[picture p30: schematic current_sense.kicad_sch, moteus-c1]

Parts:
C23, C24, C25: 1000pF; C_0402_1005Metric; MPN MF-CAP-0402-1nF
R13, R14, R15: 22; R_0402_1005Metric; MPN MF-RES-0402-22

Connections:
/Current Sense/CUR1: R13.1; also elsewhere on the board
/Current Sense/CUR2: R14.1; also elsewhere on the board
/Current Sense/CUR3: R15.1; also elsewhere on the board
/Current Sense/FCUR1: C23.1, R13.2; also elsewhere on the board
/Current Sense/FCUR2: C24.1, R14.2; also elsewhere on the board
/Current Sense/FCUR3: C25.1, R15.2; also elsewhere on the board

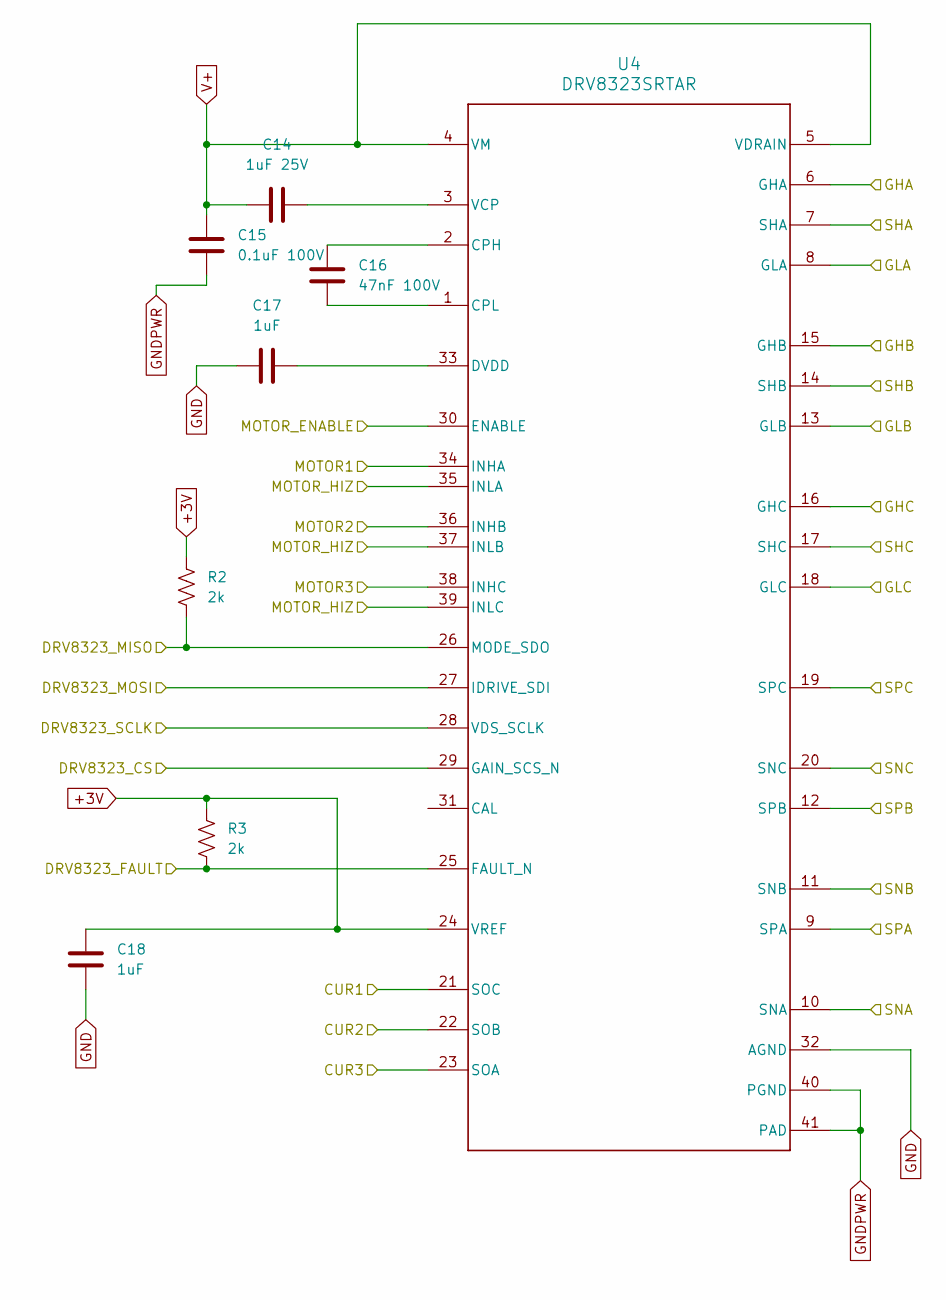
[picture p31: schematic gate_driver.kicad_sch, moteus-c1]

Parts:
C14: 1uF 25V; C_0603_1608Metric; MPN C1608X7R1E105K080AE
C15: 0.1uF 100V; C_0603_1608Metric; MPN GCJ188R72A104KA01D
C16: 47nF 100V; C_0603_1608Metric; MPN C0603X473K1RAC7867
C17: 1uF; C_0402_1005Metric; MPN MF-CAP-0402-1uF
C18: 1uF; C_0603_1608Metric; MPN MF-CAP-0603-1uF
R2, R3: 2k; R_0402_1005Metric; MPN MF-RES-0402-2K
U4: DRV8323SRTAR; RTA0040B; MPN DRV8323SRTAR

Connections:
/Current Sense/CUR1: U4.21 (SOC); also elsewhere on the board
/Current Sense/CUR2: U4.22 (SOB); also elsewhere on the board
/Current Sense/CUR3: U4.23 (SOA); also elsewhere on the board
/Gate Driver/DRV8323_CS: U4.29 (GAIN_SCS_N); also elsewhere on the board
/Gate Driver/DRV8323_FAULT: R3.2, U4.25 (FAULT_N); also elsewhere on the board
/Gate Driver/DRV8323_MOSI: U4.27 (IDRIVE_SDI); also elsewhere on the board
/Gate Driver/DRV8323_SCLK: U4.28 (VDS_SCLK); also elsewhere on the board
/Gate Driver/GHA: U4.6 (GHA); also elsewhere on the board
/Gate Driver/GHB: U4.15 (GHB); also elsewhere on the board
/Gate Driver/GHC: U4.16 (GHC); also elsewhere on the board
/Gate Driver/GLA: U4.8 (GLA); also elsewhere on the board
/Gate Driver/GLB: U4.13 (GLB); also elsewhere on the board
/Gate Driver/GLC: U4.18 (GLC); also elsewhere on the board
/Gate Driver/MOTOR1: U4.34 (INHA); also elsewhere on the board
/Gate Driver/MOTOR2: U4.36 (INHB); also elsewhere on the board
/Gate Driver/MOTOR3: U4.38 (INHC); also elsewhere on the board
/Gate Driver/MOTOR_ENABLE: U4.30 (ENABLE); also elsewhere on the board
/Gate Driver/MOTOR_HIZ: U4.35 (INLA), U4.37 (INLB), U4.39 (INLC); also elsewhere on the board
/H Bridge A/OUTX: U4.7 (SHA); also elsewhere on the board
/H Bridge A/SXX_N: U4.10 (SNA); also elsewhere on the board
/H Bridge A/SXX_P: U4.9 (SPA); also elsewhere on the board
/H Bridge B/OUTX: U4.14 (SHB); also elsewhere on the board
/H Bridge B/SXX_N: U4.11 (SNB); also elsewhere on the board
/H Bridge B/SXX_P: U4.12 (SPB); also elsewhere on the board
/H Bridge C/OUTX: U4.17 (SHC); also elsewhere on the board
/H Bridge C/SXX_N: U4.20 (SNC); also elsewhere on the board
/H Bridge C/SXX_P: U4.19 (SPC); also elsewhere on the board
GNDPWR: C15.1, U4.40 (PGND), U4.41 (PAD); also elsewhere on the board
unnamed: C16.2, U4.2 (CPH)
unnamed: C16.1, U4.1 (CPL)
unnamed: C17.2, U4.33 (DVDD)
unnamed: C14.2, U4.3 (VCP)
V+: C14.1, C15.2, U4.4 (VM), U4.5 (VDRAIN); also elsewhere on the board

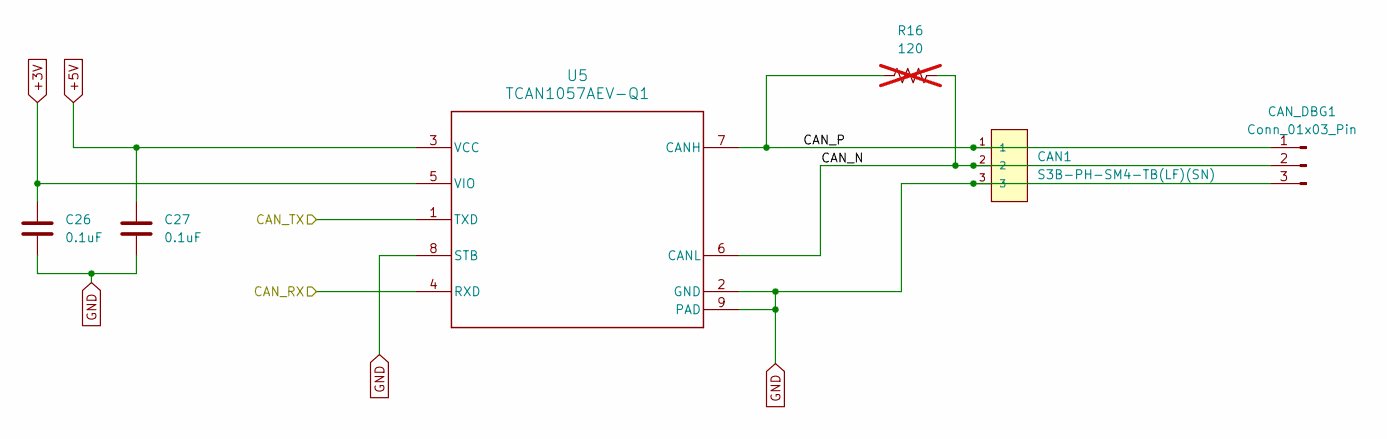
[picture p32: schematic can.kicad_sch, moteus-c1]

Parts:
C26, C27: 0.1uF; C_0402_1005Metric; MPN MF-CAP-0402-0.1uF
CAN1: S3B-PH-SM4-TB(LF)(SN); JST_S3B-PH-SM4-TB(LF)(SN); MPN S3B-PH-SM4-TB(LF)(SN)
CAN_DBG1: Conn_01x03_Pin; PinHeader_1x03_P2.00mm_Vertical
R16: 120; R_0603_1608Metric; MPN RC0805FR-07120RL; not fitted
U5: TCAN1057AEV-Q1; SOIC-8_3.9x4.9mm_P1.27mm; MPN TCAN1057AEVDRQ1

Connections:
+5V: C27.1, U5.3 (VCC); also elsewhere on the board
/CAN/CAN_N: CAN1.2, CAN_DBG1.2, R16.2, U5.6 (CANL)
/CAN/CAN_P: CAN1.1, CAN_DBG1.1, R16.1, U5.7 (CANH)
/CAN/CAN_RX: U5.4 (RXD); also elsewhere on the board
/CAN/CAN_TX: U5.1 (TXD); also elsewhere on the board

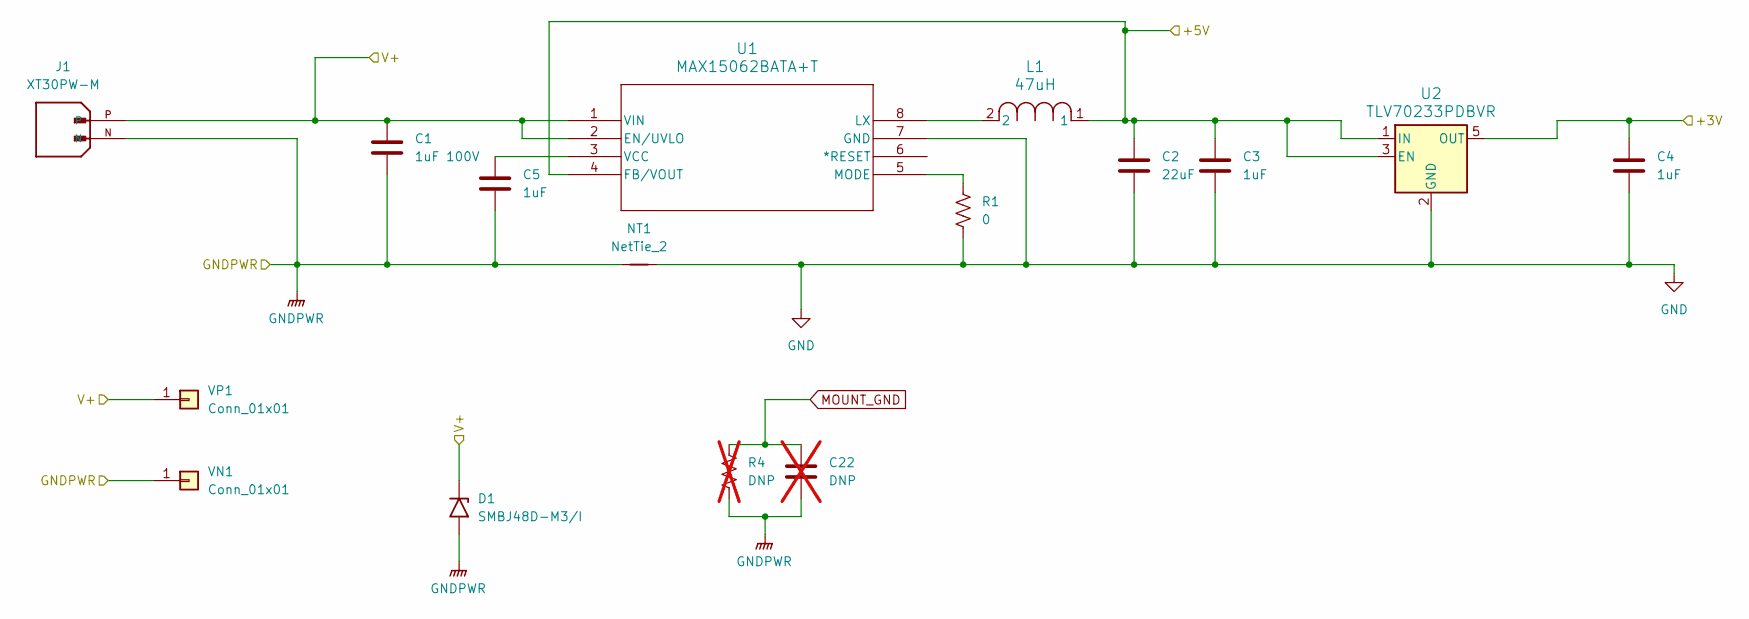
[picture p33: schematic power_input.kicad_sch, moteus-c1]

Parts:
C1: 1uF 100V; C_0805_2012Metric; MPN GCM21BC72A105KE36L
C2: 22uF; C_1206_3216Metric; MPN GRM31CR71A226KE15L
C3, C4: 1uF; C_0402_1005Metric; MPN MF-CAP-0402-1uF
C5: 1uF; C_0603_1608Metric; MPN MF-CAP-0603-1uF
C22: DNP; C_0402_1005Metric; not fitted
D1: SMBJ48D-M3/I; D_SMB; MPN SMBJ48D-M3/I
J1: XT30PW-M; AMASS_XT30PW-M; MPN XT30PW-M
L1: 47uH; IND_4018-WE-LQS_WRE; MPN 74404042470
NT1: NetTie_2; NetTie-2_SMD_Pad0.254mm
R1: 0; R_0402_1005Metric; MPN MF-RES-0402-0
R4: DNP; R_0402_1005Metric; not fitted
U1: MAX15062BATA+T; 21-0487A_MXM; MPN MAX15062BATA+T
U2: TLV70233PDBVR; SOT-23-5; MPN TLV70233PDBVR
VN1: Conn_01x01; POWER_M2.5
VP1: Conn_01x01; POWER_M2.5

Connections:
+5V: C2.1, C3.1, L1.1, U1.4 (FB/VOUT), U2.1 (IN), U2.3 (EN); also elsewhere on the board
GNDPWR: C1.2, C5.2, C22.2, D1.2 (A2), J1.N, NT1.1, R4.2, VN1.1; also elsewhere on the board
MOUNT_GND: C22.1, R4.1; also elsewhere on the board
unnamed: L1.2, U1.8 (LX)
unnamed: R1.1, U1.5 (MODE)
unnamed: C5.1, U1.3 (VCC)
V+: C1.1, D1.1 (A1), J1.P, U1.1 (VIN), U1.2 (EN/UVLO), VP1.1; also elsewhere on the board

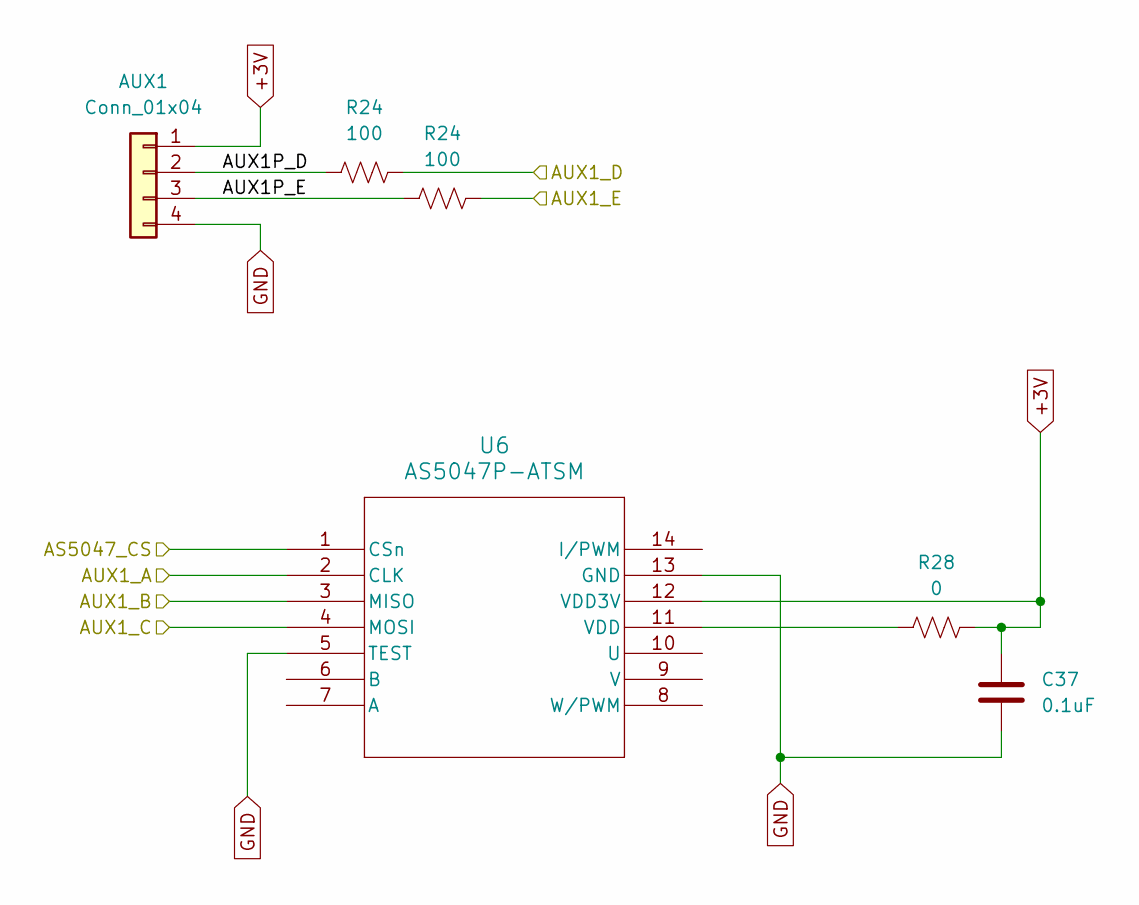
[picture p34: schematic aux1.kicad_sch, moteus-c1]

Parts:
AUX1: Conn_01x04; PinHeader_1x04_P1.27mm_Vertical
C37: 0.1uF; C_0402_1005Metric; MPN MF-CAP-0402-0.1uF
R24: 100; R_0402_1005Metric; MPN MF-RES-0402-100
R28: 0; R_0402_1005Metric; MPN MF-RES-0402-0
U6: AS5047P-ATSM; TSSOP14_OSM; MPN AS5047P-ATSM

Connections:
/aux1/AS5047_CS: U6.1 (CSn); also elsewhere on the board
/aux1/AUX1_A: U6.2 (CLK); also elsewhere on the board
/aux1/AUX1_B: U6.3 (MISO); also elsewhere on the board
/aux1/AUX1_C: U6.4 (MOSI); also elsewhere on the board
/aux2/AUX2_A: R24.2; also elsewhere on the board
unnamed: R28.1, U6.11 (VDD)

Parts of its further copies:
R34, R35: 100; R_0402_1005Metric; MPN MF-RES-0402-100

Connections of its further copies:
/aux1/AUX1_D: R34.2; also elsewhere on the board
/aux1/AUX1_E: R35.2; also elsewhere on the board

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
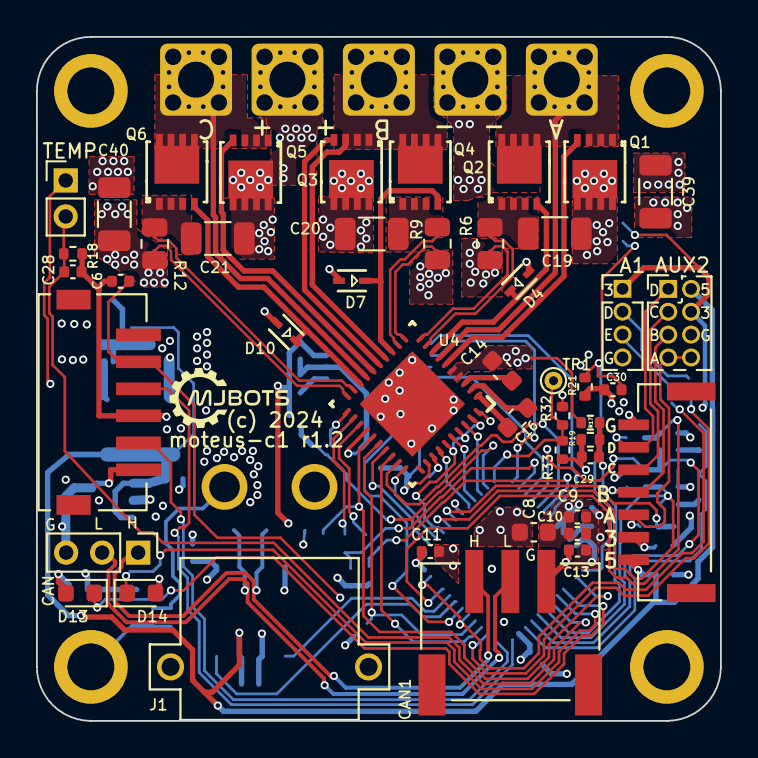
[picture p35: board moteus_c1.kicad_pcb from above]

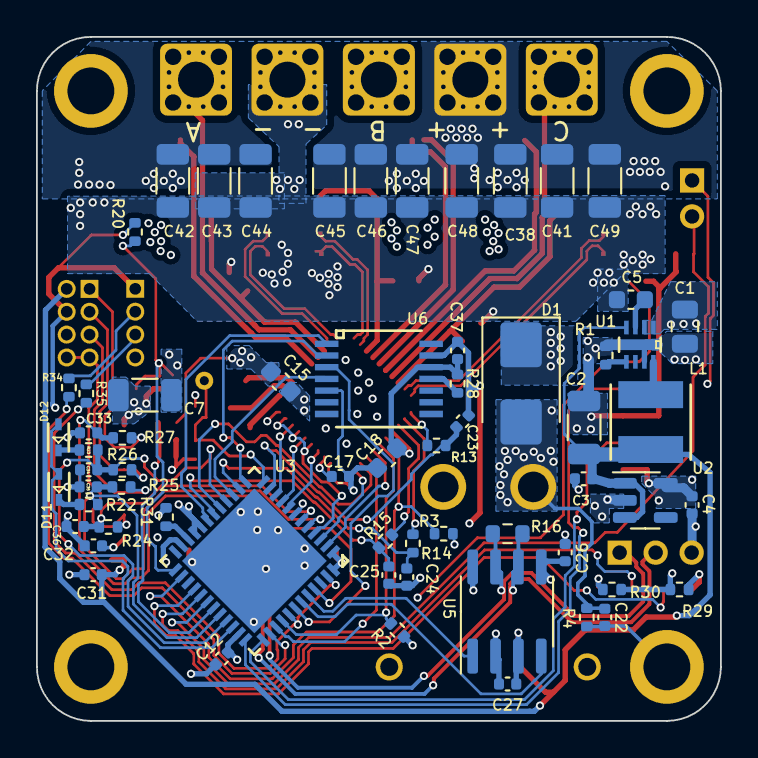
[picture p36: board moteus_c1.kicad_pcb from below]

Board: 4 copper layers, 38.0 x 38.0 mm, 125 parts (64 on the bottom side), 83 nets.

Other parts of the board:
MOUNT1, MOUNT2, MOUNT3, MOUNT4: M2.5_MOUNT
R32: DNP; R_0402_1005Metric
R33: 100k; R_0402_1005Metric

Their connections:
MOUNT_GND: MOUNT3.1; also elsewhere on the board
