lingluo831/mymoteus/hw/n1/r1/moteus_n1.brd

## EAGLE design hw/n1/r1/moteus_n1.brd (2025-04-23)

Schematic: moteus_n1.sch

Parts:
A: PAD16AWG_TERM; 16AWG_TERM
AUX1: SM08B-GHS-TB(LF)(SN); JST_SM08B-GHS-TB(LF)(SN); MPN SM08B-GHS-TB(LF)(SN)
AUX2: SM07B-GHS-TB(LF)(SN); JST_SM07B-GHS-TB(LF)(SN); MPN SM07B-GHS-TB(LF)(SN)
B: PAD16AWG_TERM; 16AWG_TERM
C: PAD16AWG_TERM; 16AWG_TERM
C1, C18, C19, C20, C21, C24, C25, C26: DNP; C0402
C2: 1uF 100V; C0805; MPN GCM21BC72A105KE36L
C3, C16, C17, C22, C23: 1uF; C0603; MPN MF-CAP-0603-1uF
C4, C13: 10uF; C1206; MPN MF-CAP-1206-10uF
C5, C10, C34, C36, C37: 1uF; C0402; MPN MF-CAP-0402-1uF
C6: 22uF; C1206; MPN CL31B226KPHNNNE
C7, C8, C9, C11, C12, C14, C15, C28, C29, C38: 0.1uF; C0402; MPN MF-CAP-0402-0.1uF
C27: 0.01uF; C0402; MPN MF-CAP-0402-0.01uF
C30, C31, C32: 1000pF; C0402; MPN MF-CAP-0402-1nF
C33, C35: 0.1uF 100V; C0603; MPN GCJ188R72A104KA01D
C39: 0.47uF 100V; C0805; MPN 08051C474KAT2A
C40, C41, C42: 0.1uF 100V; C1206; MPN 12061C104KAT2A
C43, C44: 100uF 63V; EEHZS1V471UP; MANUFACTURER_PART_NUMBER EEH-ZU1J101V
C45, C46, C47: 4.7uF 100V; C1206; MPN GRJ31CC72A475KE01K
C48, C49, C50, C51, C52, C53, C54, C55, C56, C57, C58, C59, C60: 4.7uF 100V; C1206_NOCREAM_NOBORDER; MPN GRJ31CC72A475KE01K
CAN1, CAN2: JST-PH3; JST_S3B-PH-SM4-TB(LF)(SN); MPN S3B-PH-SM4-TB(LF)(SN)
D1: MF-LED-0603-RED; LED0603
D2: MF-LED-0603-RED; LED0603; MPN MF-LED-0603-GREEN
D3, D4, D5, D6, D7, D8, D9, D10, D11: BAT41KFILM; SODFL1608X70N; MPN BAT41KFILM
D12: DIODE-DO214AA; DO214AA; MPN TPSMB51A-VR
D33, D50: PAD24AWG_PAD; 24AWG_PAD
DAC: PAD24AWG_PAD; 24AWG_PAD
DG1: PAD24AWG_PAD; 24AWG_PAD
DTR: PAD24AWG_PAD; 24AWG_PAD
DTX: PAD24AWG_PAD; 24AWG_PAD
J1, J2: XT30XT30PW_MALE; XT30PW_MALE; MPN XT30PW-M
L1: SRN4018-220M; IND_BOURNS_SRN4018; MANUFACTURER_PART_NUMBER 74404042470
L2: 74404024100; IND_4024100_WRE; MPN 74404024100
M1, M2, M3, M4: MOUNT; M2.5MOUNT
MOT1, MOT2, MOT3: PAD24AWG_PAD; 24AWG_PAD
Q1, Q3, Q5: TPH1R204PL_VIAS; SOP_ADVANCE_8_VIAS; MPN TPH2R408QM,L1Q
Q2, Q4, Q6: TPH1R204PLSOP_ADVANCE_8; SOP_ADVANCE_8; MPN TPH2R408QM,L1Q
R1, R2: DNP; R0402
R3, R15: 100k 1%; R0402; MPN RC0402FR-07100KL
R4, R5, R8, R9, R10, R11, R12, R13, R14: 100; R0402; MPN MF-RES-0402-100
R6, R7, R25, R26: 2k; R0402; MPN MF-RES-0402-2K
R16: 4.7k 1%; R0402; MPN RC0402FR-074K7L
R17: 47k NTC; R0402; MPN NCP15WB473F03RC
R18, R19: 10k 1%; R0402; MPN RC0402FR-0710KL
R20, R21: 560; R0402; MPN MF-RES-0402-560
R22, R23, R24: 22; R0402; MPN MF-RES-0402-22
R27, R28, R30, R31, R32: 7.5; R0402; MPN RC0402FR-077R5L
R29: 7.5; R0805; MPN RC0805FR-077R5L
RA: 0.5mOhm 1% 2W; M1206; MPN HCS1206FTL500
RB: 0.5mOhm 1% 2W; M1206; MPN HCS1206FTL500
RC: 0.5mOhm 1% 2W; M1206; MPN HCS1206FTL500
SH1, SH2, SH3: SHORTT5; SHORT_TOP-50
SH4: SHORTMEDIUM; SHORT_TOP-MEDIUM
SWD: JST-ZH6; JST_S6B-ZR-SM4A-TF(LF)(SN); MPN S6B-ZR-SM4A-TF(LF)(SN)
TEMP1, TEMP2: PAD24AWG_PAD; 24AWG_PAD
U1: MAX15062AATA+T; 21-0487A_MXM; MANUFACTURER_PART_NUMBER MAX15062BATA+T
U2: XC9265A331MR-G; SOT95P280X130-5N; MPN XC9265A331MR-G
U3: STM32G474CEU6; QFN50P700X700X60-49N; MPN STM32G474CEU6
U4: TCAN1042HGV; SOIC8; MPN TCAN1057AEVDRQ1‎
U5: AS5147; TSSOP14; MPN AS5047P-ATSM
U6: CAT25080HU4I-GT3UDFN8_2X3_ONS-M; UDFN8_2X3_ONS-M; MPN CAT24C32HU4I-GT3
U7: DRV8353S; WQFN-40; MPN DRV8353FSRTAR
VN: PAD16AWG_TERM; 16AWG_TERM
VP: PAD16AWG_TERM; 16AWG_TERM

Connections:
+3V3: AUX1.2, AUX2.2, C6.P$1, C7.P$1, C8.P$1, C10.P$1, C11.P$1, C12.P$1, C13.P$2, C15.P$1, C17.P$1, C23.P$1, C38.P$2, D33.P$1, L2.1, R2.P$2, R17.P$1, R20.P$1, R21.P$1, R25.P$1, R26.P$1, SWD.6, TEMP1.P$1, U2.4 (VOUT), U3.1 (VBAT), U3.20 (VREF+), U3.21 (VDDA), U3.23 (VDD_1), U3.35 (VDD_2), U3.48 (VDD_3), U4.5 (VIO), U5.12 (VDD3V), U6.3 (!WP), U6.7 (!HOLD), U6.8 (VCC), U7.24 (VREF)
+5V: AUX1.1, AUX2.1, C4.P$1, C5.P$1, C14.P$1, C16.P$1, C22.P$1, D50.P$1, L1.1, U1.4 (FB/VOUT), U2.1 (VIN), U2.3 (CE), U4.3 (VCC)
AS5047_CS: U3.42 (PB4), U5.1 (CS/)
AS5047_MISO: C26.P$1, R12.P$2, U3.40 (PC11), U5.3 (MISO)
AS5047_MOSI: C25.P$1, R13.P$2, U3.43 (PB5), U5.4 (MOSI)
AS5047_SCK: C24.P$1, R14.P$2, U3.39 (PC10), U5.2 (CLK)
AUX_SC1: C20.P$1, R5.P$2, U3.27 (PB14)
AUX_SC2: C21.P$1, R4.P$2, U3.28 (PB15)
AUX_SCL: C19.P$1, R9.P$2, U3.46 (PB8-BOOT0)
AUX_SDA: C18.P$1, R8.P$2, U3.26 (PB13), U3.47 (PB9)
CAN_N: CAN1.2, CAN2.2, U4.6 (CANL)
CAN_P: CAN1.1, CAN2.1, U4.7 (CANH)
CAN_RX: U3.33 (PA11), U4.4 (RXD)
CAN_TX: U3.34 (PA12), U4.1 (TXD)
CUR1: R22.P$1, U7.23 (SOA)
CUR2: R23.P$1, U7.22 (SOB)
CUR3: R24.P$1, U7.21 (SOC)
DAC: DAC.P$1, R2.P$1, R3.P$2, U3.12 (PA4)
DEBUG_RX: DTR.P$1, U3.45 (PB7)
DEBUG_TX: DTX.P$1, U3.44 (PB6)
DRV8323_CS: U3.17 (PB0), U7.30 (CS)
DRV8323_MISO: R25.P$2, U3.14 (PA6), U6.2 (SO), U7.27 (MISO)
DRV8323_MOSI: U3.15 (PA7), U6.5 (SI), U7.28 (MOSI)
DRV8323_SCLK: U3.13 (PA5), U6.6 (SCK), U7.29 (SCLK)
EEPROM_CS: U3.38 (PA15), U6.1 (!CS)
FCUR1: C30.P$1, R22.P$2, U3.11 (PA3)
FCUR2: C31.P$1, R23.P$2, U3.16 (PC4)
FCUR3: C32.P$1, R24.P$2, U3.18 (PB1)
GHA: D5.1 (K), R28.P$1, U7.6 (GHA)
GHA_D: D5.2 (A), Q1.4 (G), R28.P$2
GHB: D8.1 (K), R30.P$1, U7.15 (GHB)
GHB_D: D8.2 (A), Q3.4 (G), R30.P$2
GHC: D11.1 (K), R32.P$1, U7.16 (GHC)
GHC_D: D11.2 (A), Q5.4 (G), R32.P$2
GLA: D3.1 (K), R27.P$1, U7.8 (GLA)
GLA_D: D3.2 (A), D4.1 (K), Q2.4 (G), R27.P$2
GLB: D6.1 (K), R29.P$1, U7.13 (GLB)
GLB_D: D6.2 (A), D7.1 (K), Q4.4 (G), R29.P$2
GLC: D9.1 (K), R31.P$1, U7.18 (GLC)
GLC_D: D9.2 (A), D10.1 (K), Q6.4 (G), R31.P$2
GND: AUX1.8, AUX2.7, C3.P$2, C4.P$2, C5.P$2, C6.P$2, C7.P$2, C8.P$2, C9.P$2, C10.P$2, C11.P$2, C12.P$2, C13.P$1, C14.P$2, C15.P$2, C16.P$2, C17.P$2, C18.P$2, C19.P$2, C20.P$2, C21.P$2, C22.P$2, C23.P$2, C24.P$2, C25.P$2, C26.P$2, C27.P$2, C28.P$2, C29.P$2, C30.P$2, C31.P$2, C32.P$2, C38.P$1, CAN1.3, CAN2.3, DG1.P$1, R3.P$1, R16.P$1, R18.P$2, R19.P$2, SH4.2, SWD.4, U1.7 (GND), U2.2 (GND), U3.49 (THERMALPAD), U4.2 (GND), U4.8 (STB), U5.5 (TEST), U5.13 (GND), U6.4 (VSS), U7.25 (AGND)
I2C_PULLUP: R6.P$1, R7.P$1, U3.41 (PB3)
LED1: D1.CATHODE, U3.5 (PF0-OSC_IN)
LED2: D2.CATHODE, U3.6 (PF1-OSC_OUT)
MOTOR1: MOT1.P$1, U3.8 (PA0), U7.32 (INHA)
MOTOR2: MOT2.P$1, U3.9 (PA1), U7.34 (INHB)
MOTOR3: MOT3.P$1, U3.10 (PA2), U7.36 (INHC)
MOTOR_ENABLE: U3.3 (PC14-OSC32_IN), U7.31 (ENABLE)
MOTOR_FAULT: R26.P$2, U3.2 (PC13), U7.26 (FAULT)
MOTOR_HIZ: U3.4 (PC15-OSC32_OUT), U7.33 (INLA), U7.35 (INLB), U7.37 (INLC)
unnamed: C1.P$1, M3.P$1, R1.P$1
unnamed: C36.P$2, U7.40 (VGLS)
unnamed: AUX2.3, R4.P$1
unnamed: C3.P$1, U1.3 (VCC)
unnamed: L2.2, U2.5 (LX)
unnamed: AUX2.4, R5.P$1
unnamed: AUX2.6, R6.P$2, R8.P$1
unnamed: AUX2.5, R7.P$2, R9.P$1
unnamed: AUX1.3, R10.P$1
unnamed: C35.P$2, U7.1 (CPL)
unnamed: AUX1.4, R11.P$1
unnamed: AUX1.5, R12.P$1
unnamed: C35.P$1, U7.2 (CPH)
unnamed: C34.P$2, U7.5 (VCP)
unnamed: AUX1.6, R13.P$1
unnamed: C37.P$2, U7.38 (DVDD)
unnamed: D1.ANODE, R20.P$2
unnamed: D2.ANODE, R21.P$2
unnamed: AUX1.7, R14.P$1
NRST: C9.P$1, SWD.2, U3.7 (PG10-NRST)
PRIMARY_CS: R11.P$2, U3.19 (PB2)
PRIMARY_EXTRA: R10.P$2, U3.24 (PB11)
S1: AUX2.S1
S2: AUX2.S2
SHA: A.1, A.2, A.3, A.4, A.5, A.6, A.7, A.8, A.9, A.10, A.11, A.12, Q1.1 (S), Q1.2 (S), Q1.3 (S), Q2.5 (D), Q2.6 (D), Q2.7 (D), Q2.8 (D), Q2.PAD (D), U7.7 (SHA)
SHB: B.1, B.2, B.3, B.4, B.5, B.6, B.7, B.8, B.9, B.10, B.11, B.12, Q3.1 (S), Q3.2 (S), Q3.3 (S), Q4.5 (D), Q4.6 (D), Q4.7 (D), Q4.8 (D), Q4.PAD (D), U7.14 (SHB)
SHC: C.1, C.2, C.3, C.4, C.5, C.6, C.7, C.8, C.9, C.10, C.11, C.12, Q5.1 (S), Q5.2 (S), Q5.3 (S), Q6.5 (D), Q6.6 (D), Q6.7 (D), Q6.8 (D), Q6.PAD (D), U7.17 (SHC)
SWCLK: SWD.5, U3.37 (PA14)
SWDIO: SWD.3, U3.36 (PA13)
SXA_N: SH1.1, U7.10 (SNA)
SXA_P: C40.P$2, Q2.1 (S), Q2.2 (S), Q2.3 (S), RA.2, U7.9 (SPA)
SXB_N: SH2.1, U7.11 (SNB)
SXB_P: C41.P$2, Q4.1 (S), Q4.2 (S), Q4.3 (S), RB.2, U7.12 (SPB)
SXC_N: SH3.1, U7.20 (SNC)
SXC_P: C42.P$2, Q6.1 (S), Q6.2 (S), Q6.3 (S), RC.2, U7.19 (SPC)
V+: C2.P$1, C33.P$1, C34.P$1, C39.P$1, C40.P$1, C41.P$1, C42.P$1, C43.1 (+), C44.1 (+), C45.P$1, C46.P$1, C47.P$1, C48.P$1, C49.P$1, C50.P$1, C51.P$1, C52.P$1, C53.P$1, C54.P$1, C55.P$1, C56.P$1, C57.P$1, C58.P$1, C59.P$1, C60.P$1, D12.C, J1.1, J2.1, Q1.5 (D), Q1.6 (D), Q1.7 (D), Q1.8 (D), Q1.PAD (D), Q3.5 (D), Q3.6 (D), Q3.7 (D), Q3.8 (D), Q3.PAD (D), Q5.5 (D), Q5.6 (D), Q5.7 (D), Q5.8 (D), Q5.PAD (D), R15.P$2, U1.1 (VIN), U1.2 (EN/UVLO), U7.3 (VM), U7.4 (VDRAIN), VP.1, VP.2, VP.3, VP.4, VP.5, VP.6, VP.7, VP.8, VP.9, VP.10, VP.11, VP.12
V-: C1.P$2, C2.P$2, C33.P$2, C36.P$1, C37.P$1, C39.P$2, C43.2 (-), C44.2 (-), C45.P$2, C46.P$2, C47.P$2, C48.P$2, C49.P$2, C50.P$2, C51.P$2, C52.P$2, C53.P$2, C54.P$2, C55.P$2, C56.P$2, C57.P$2, C58.P$2, C59.P$2, C60.P$2, D4.2 (A), D7.2 (A), D10.2 (A), D12.A, J1.2, J2.2, R1.P$2, RA.1, RB.1, RC.1, SH1.2, SH2.2, SH3.2, SH4.1, U7.39 (GND), U7.P1 (PAD), U7.P2 (PAD), U7.P3 (PAD), U7.P7 (PAD), U7.P8 (PAD), U7.P9 (PAD), U7.P12 (PAD), U7.P13 (PAD), U7.P14 (PAD), U7.P17 (PAD), U7.P18 (PAD), U7.P19 (PAD), U7.PAD, VN.1, VN.2, VN.3, VN.4, VN.5, VN.6, VN.7, VN.8, VN.9, VN.10, VN.11, VN.12
VBAT_SENSE: C27.P$1, R15.P$1, R16.P$2, U3.31 (PA9)
VSW: L1.2, U1.8 (LX)
VTEMP_FET: C28.P$1, R17.P$2, R18.P$1, U3.25 (PB12)
VTEMP_MOT: C29.P$1, R19.P$1, TEMP2.P$1, U3.30 (PA8)

Notes on the sheet:
PCB rev divider HI / LO r1 - open / 100k

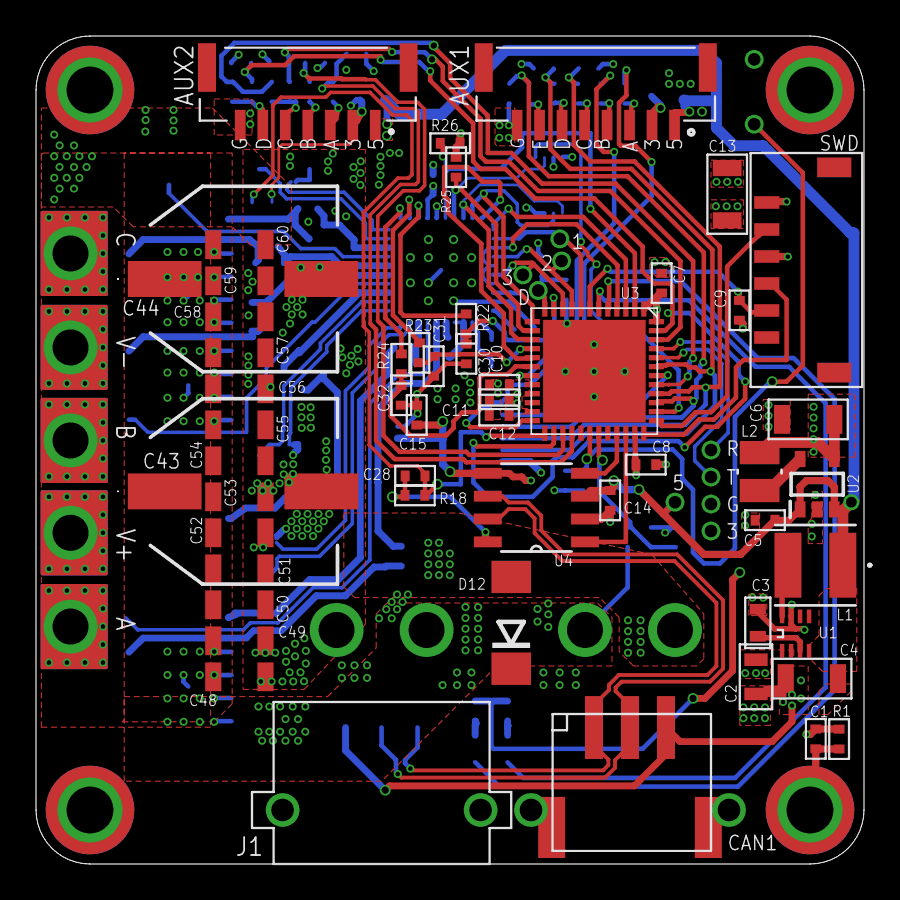
[picture p37: board hw/n1/r1/moteus_n1.brd from above]

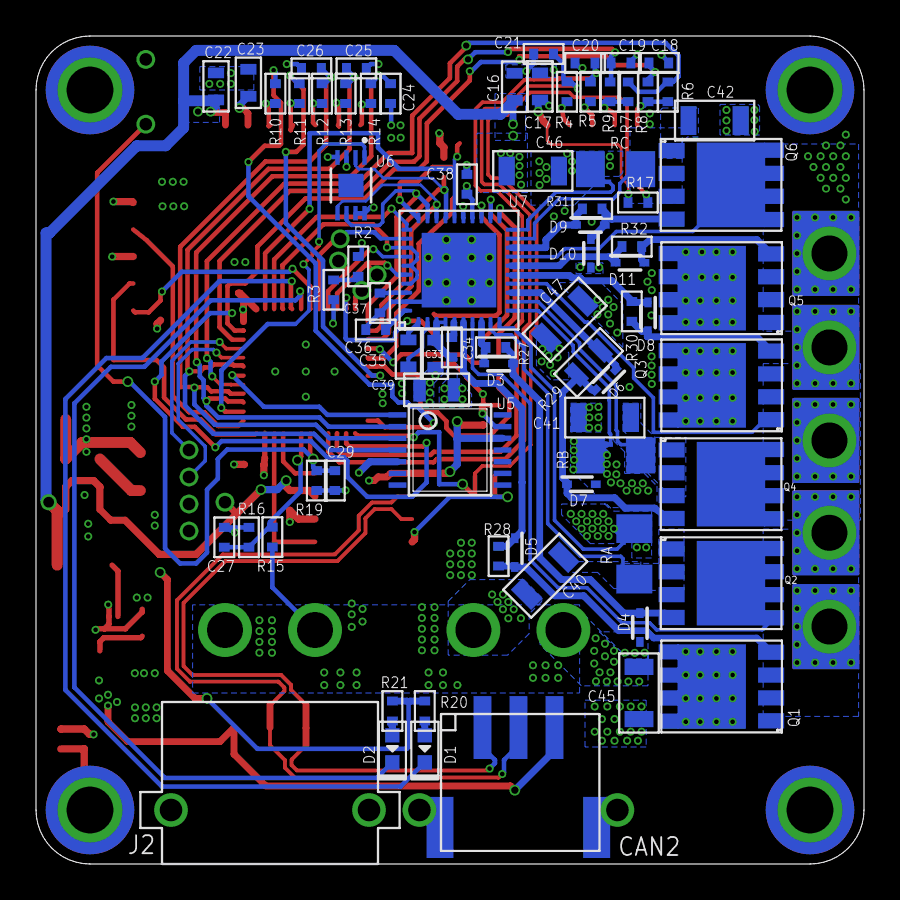
[picture p38: board hw/n1/r1/moteus_n1.brd from below]

Board: 4 copper layers, 46.0 x 46.0 mm, 153 parts (82 on the bottom side), 89 nets.
