lingluo831/mymoteus/hw/controller/r4.11/controller_tcan334gdcnt.brd

## EAGLE design hw/controller/r4.11/controller_tcan334gdcnt.brd (2025-04-23)

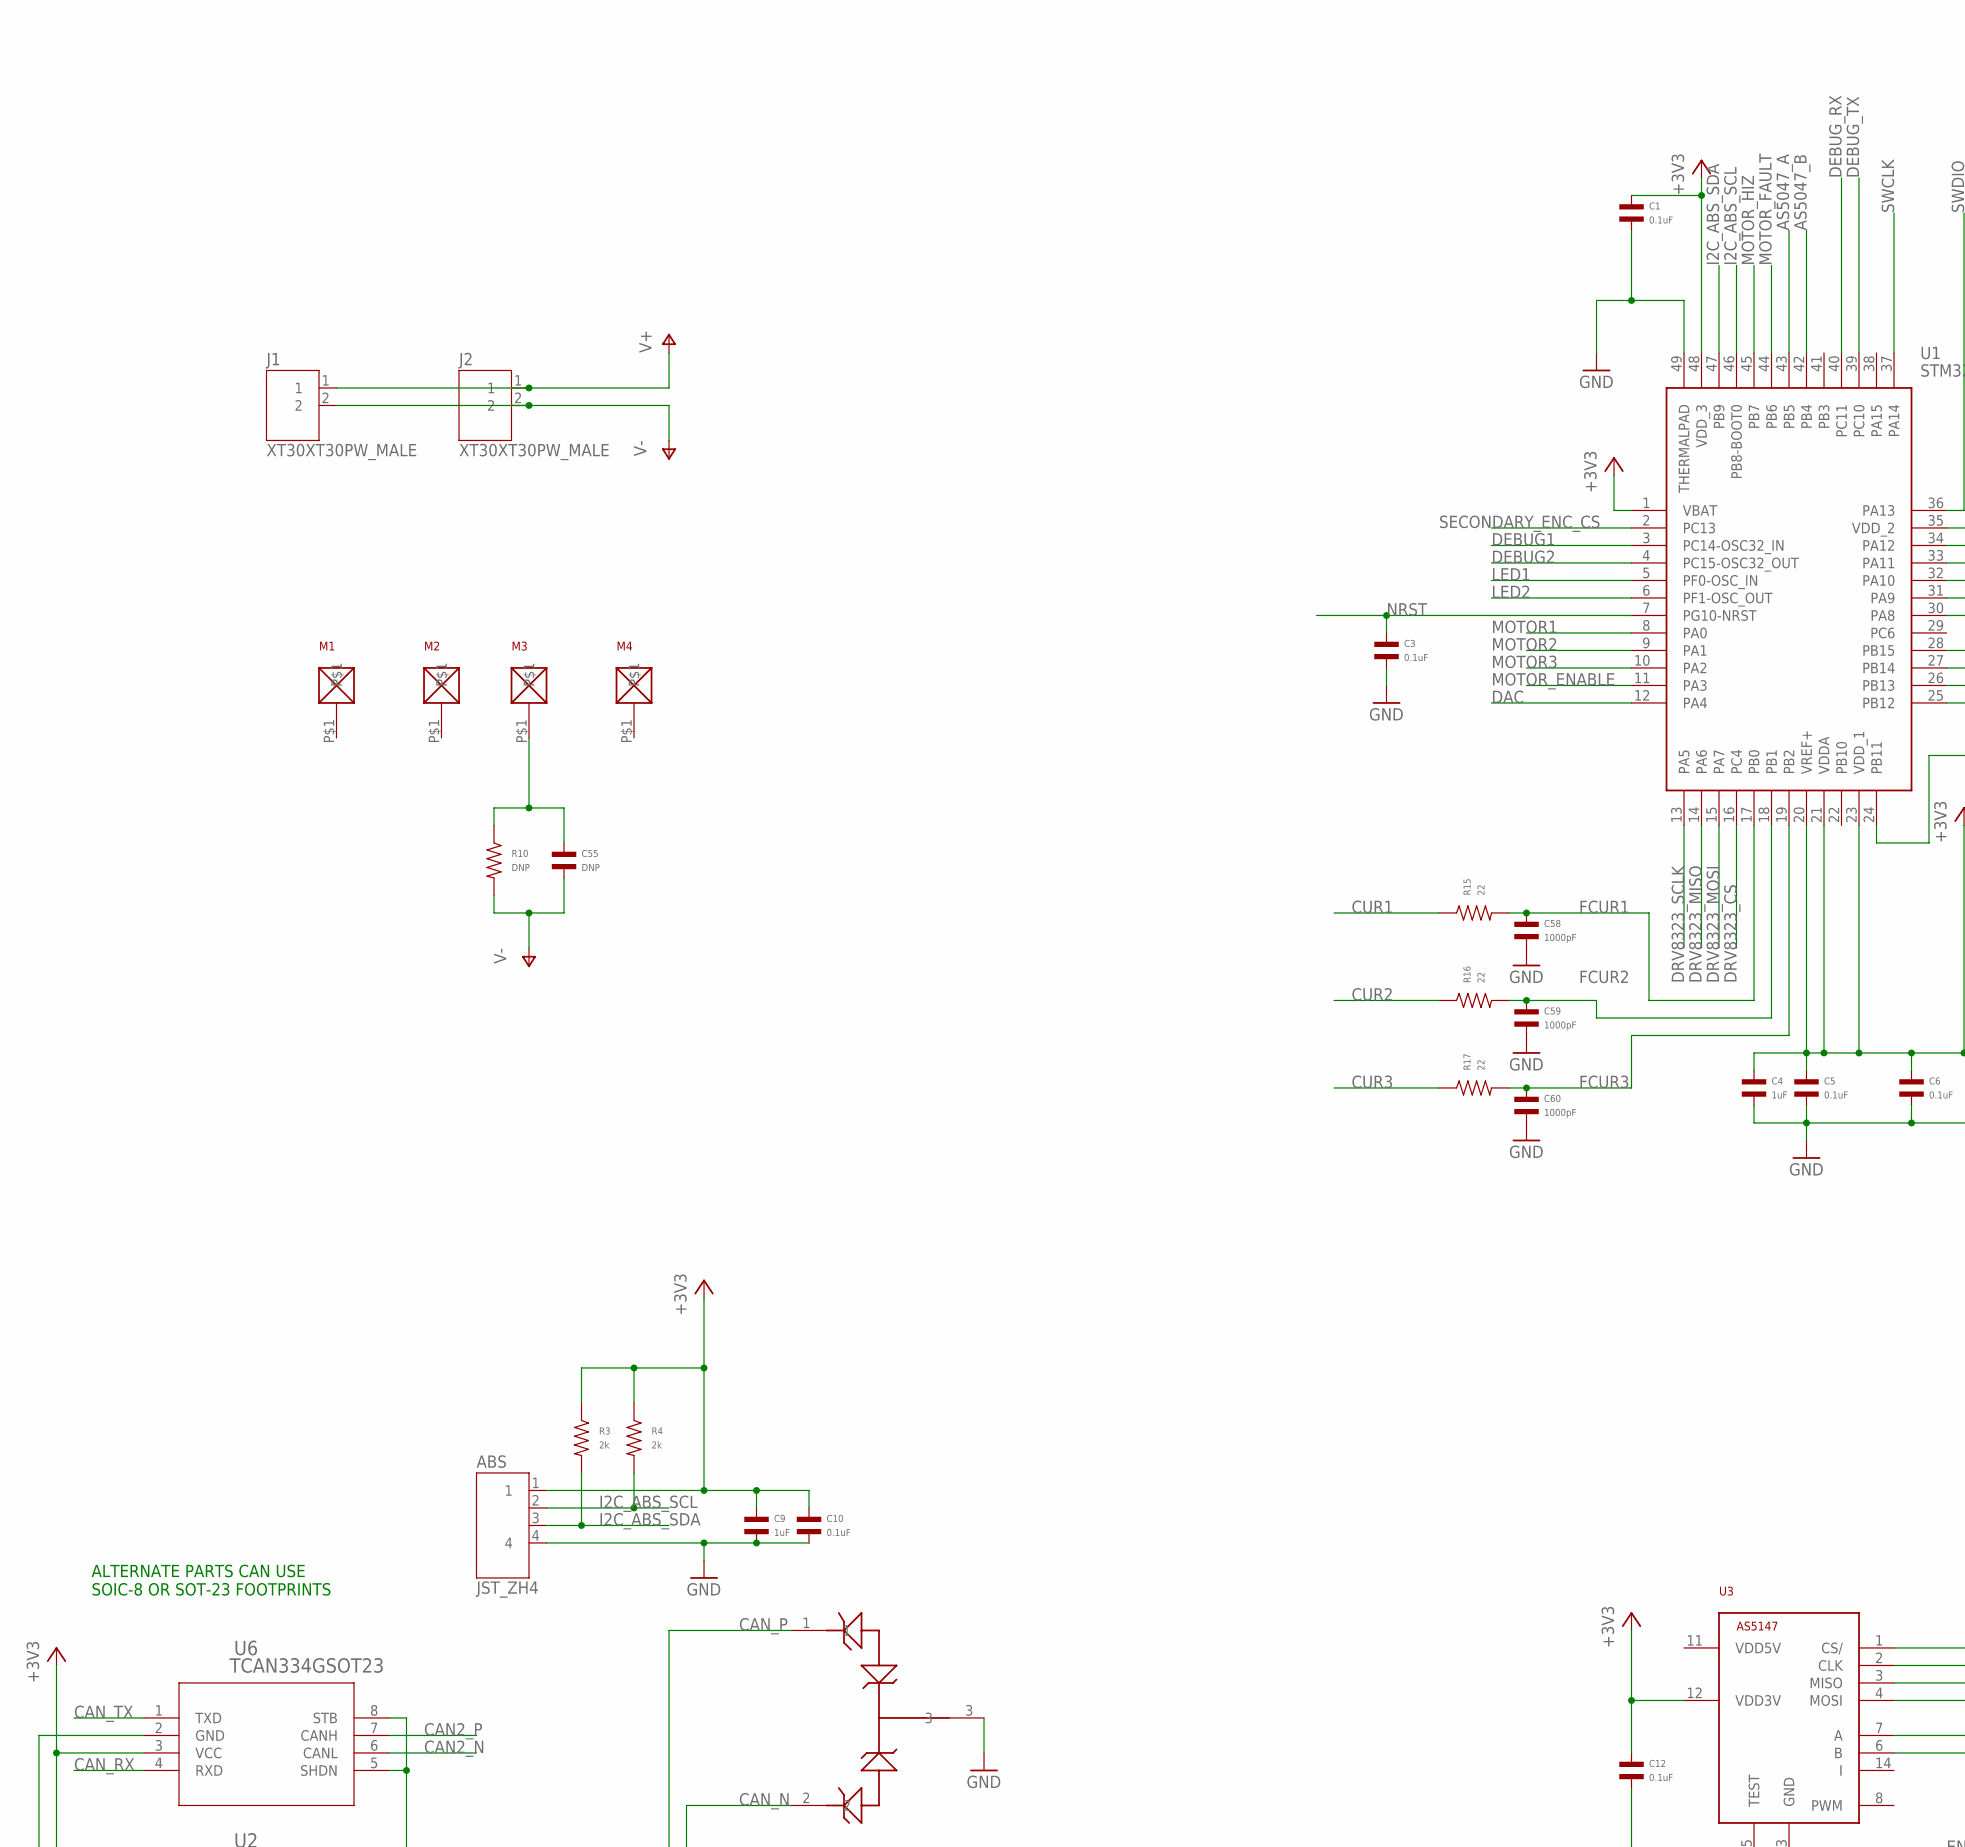
[picture p39: schematic controller_tcan334gdcnt.sch, part in row 1, column 1]

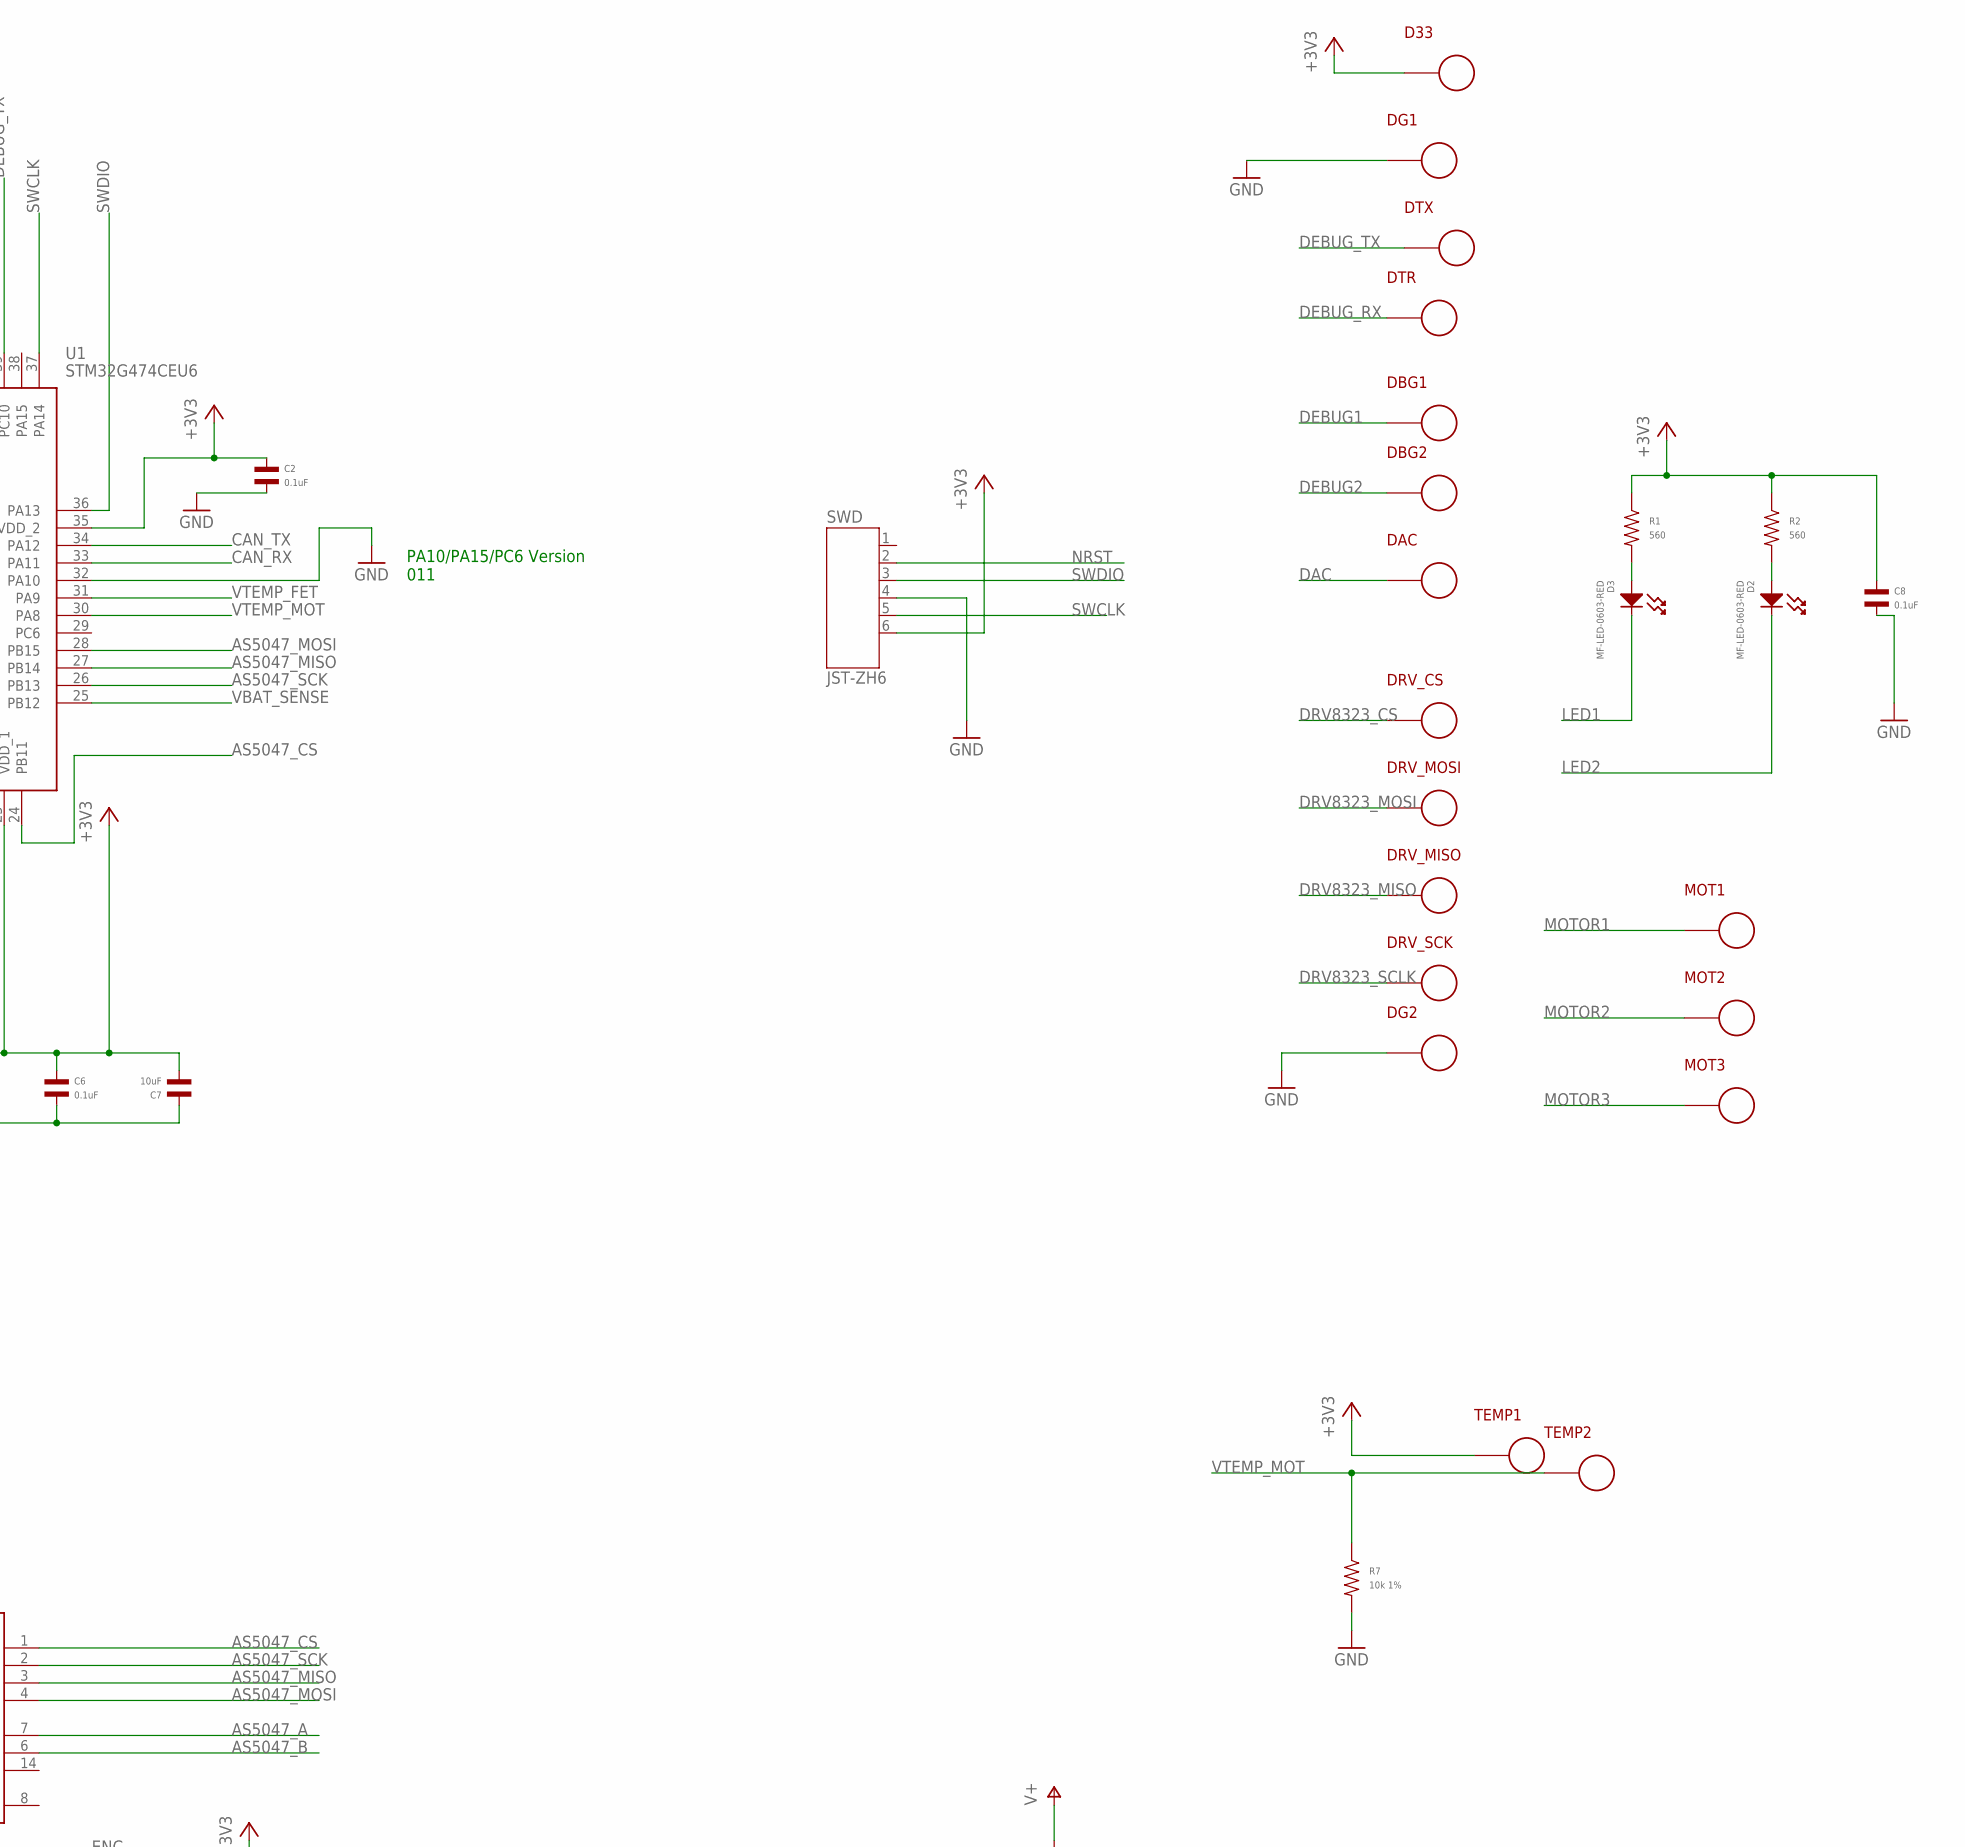
[picture p40: schematic controller_tcan334gdcnt.sch, part in row 1, column 2]

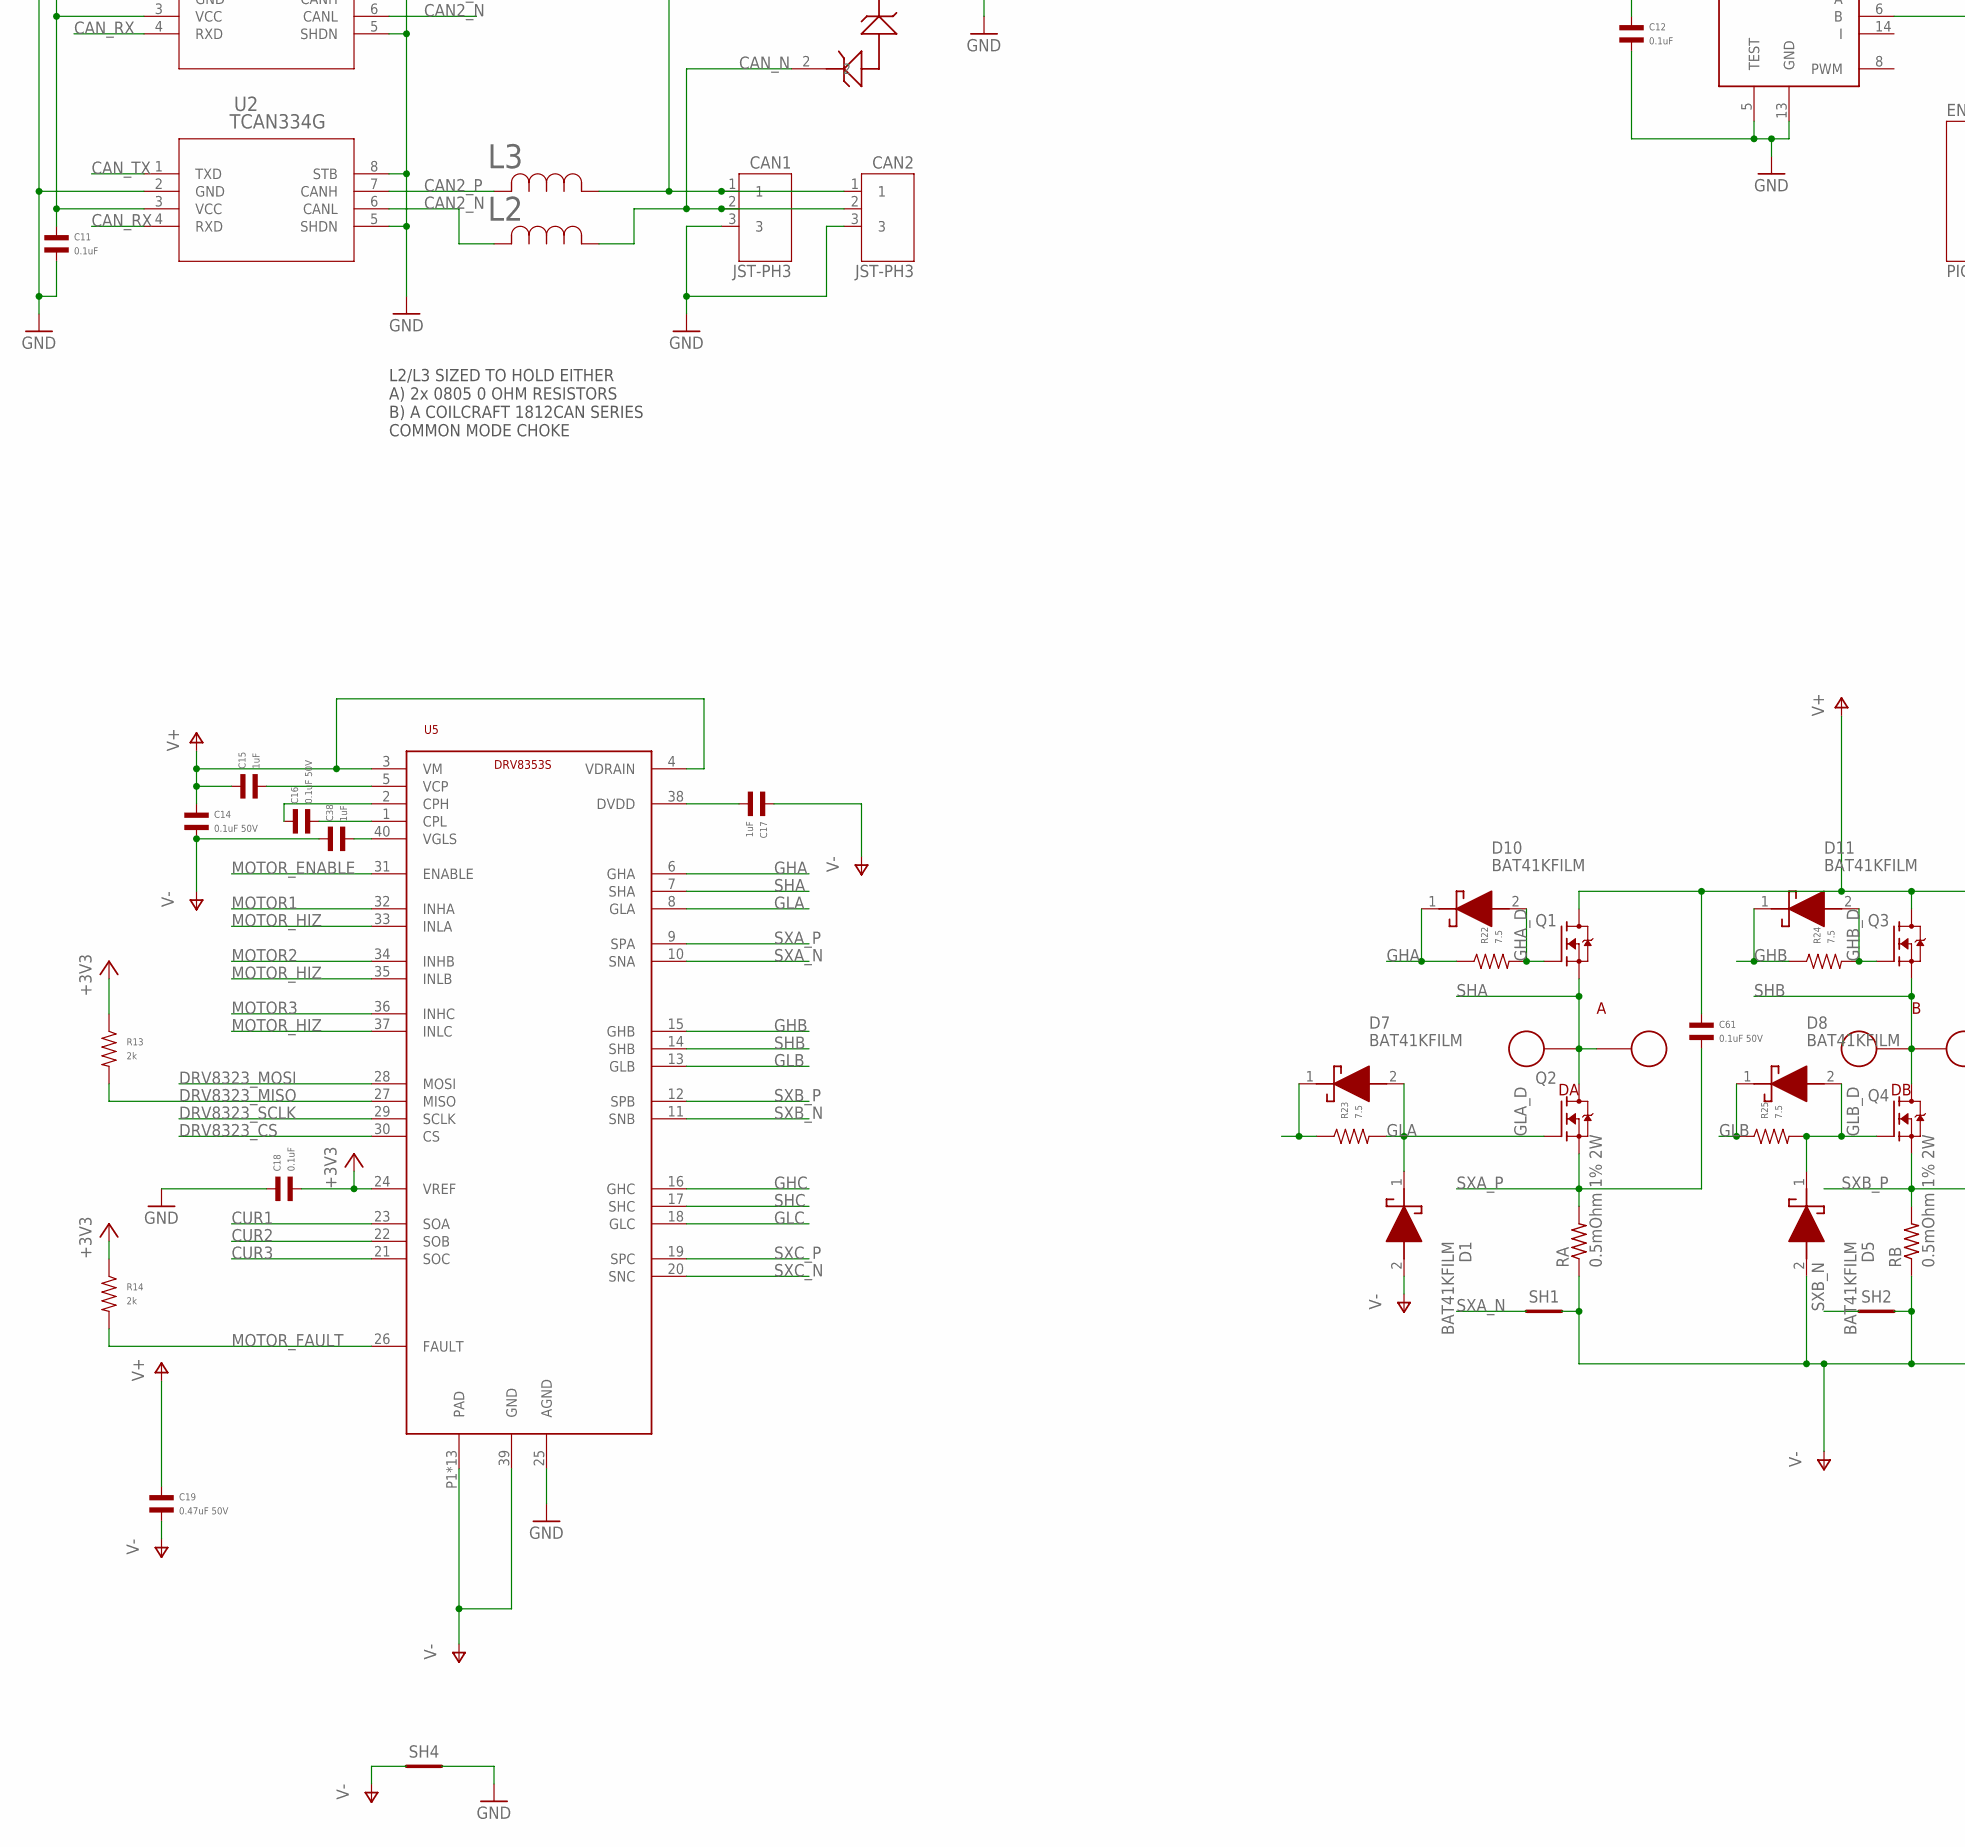
[picture p41: schematic controller_tcan334gdcnt.sch, part in row 2, column 1]

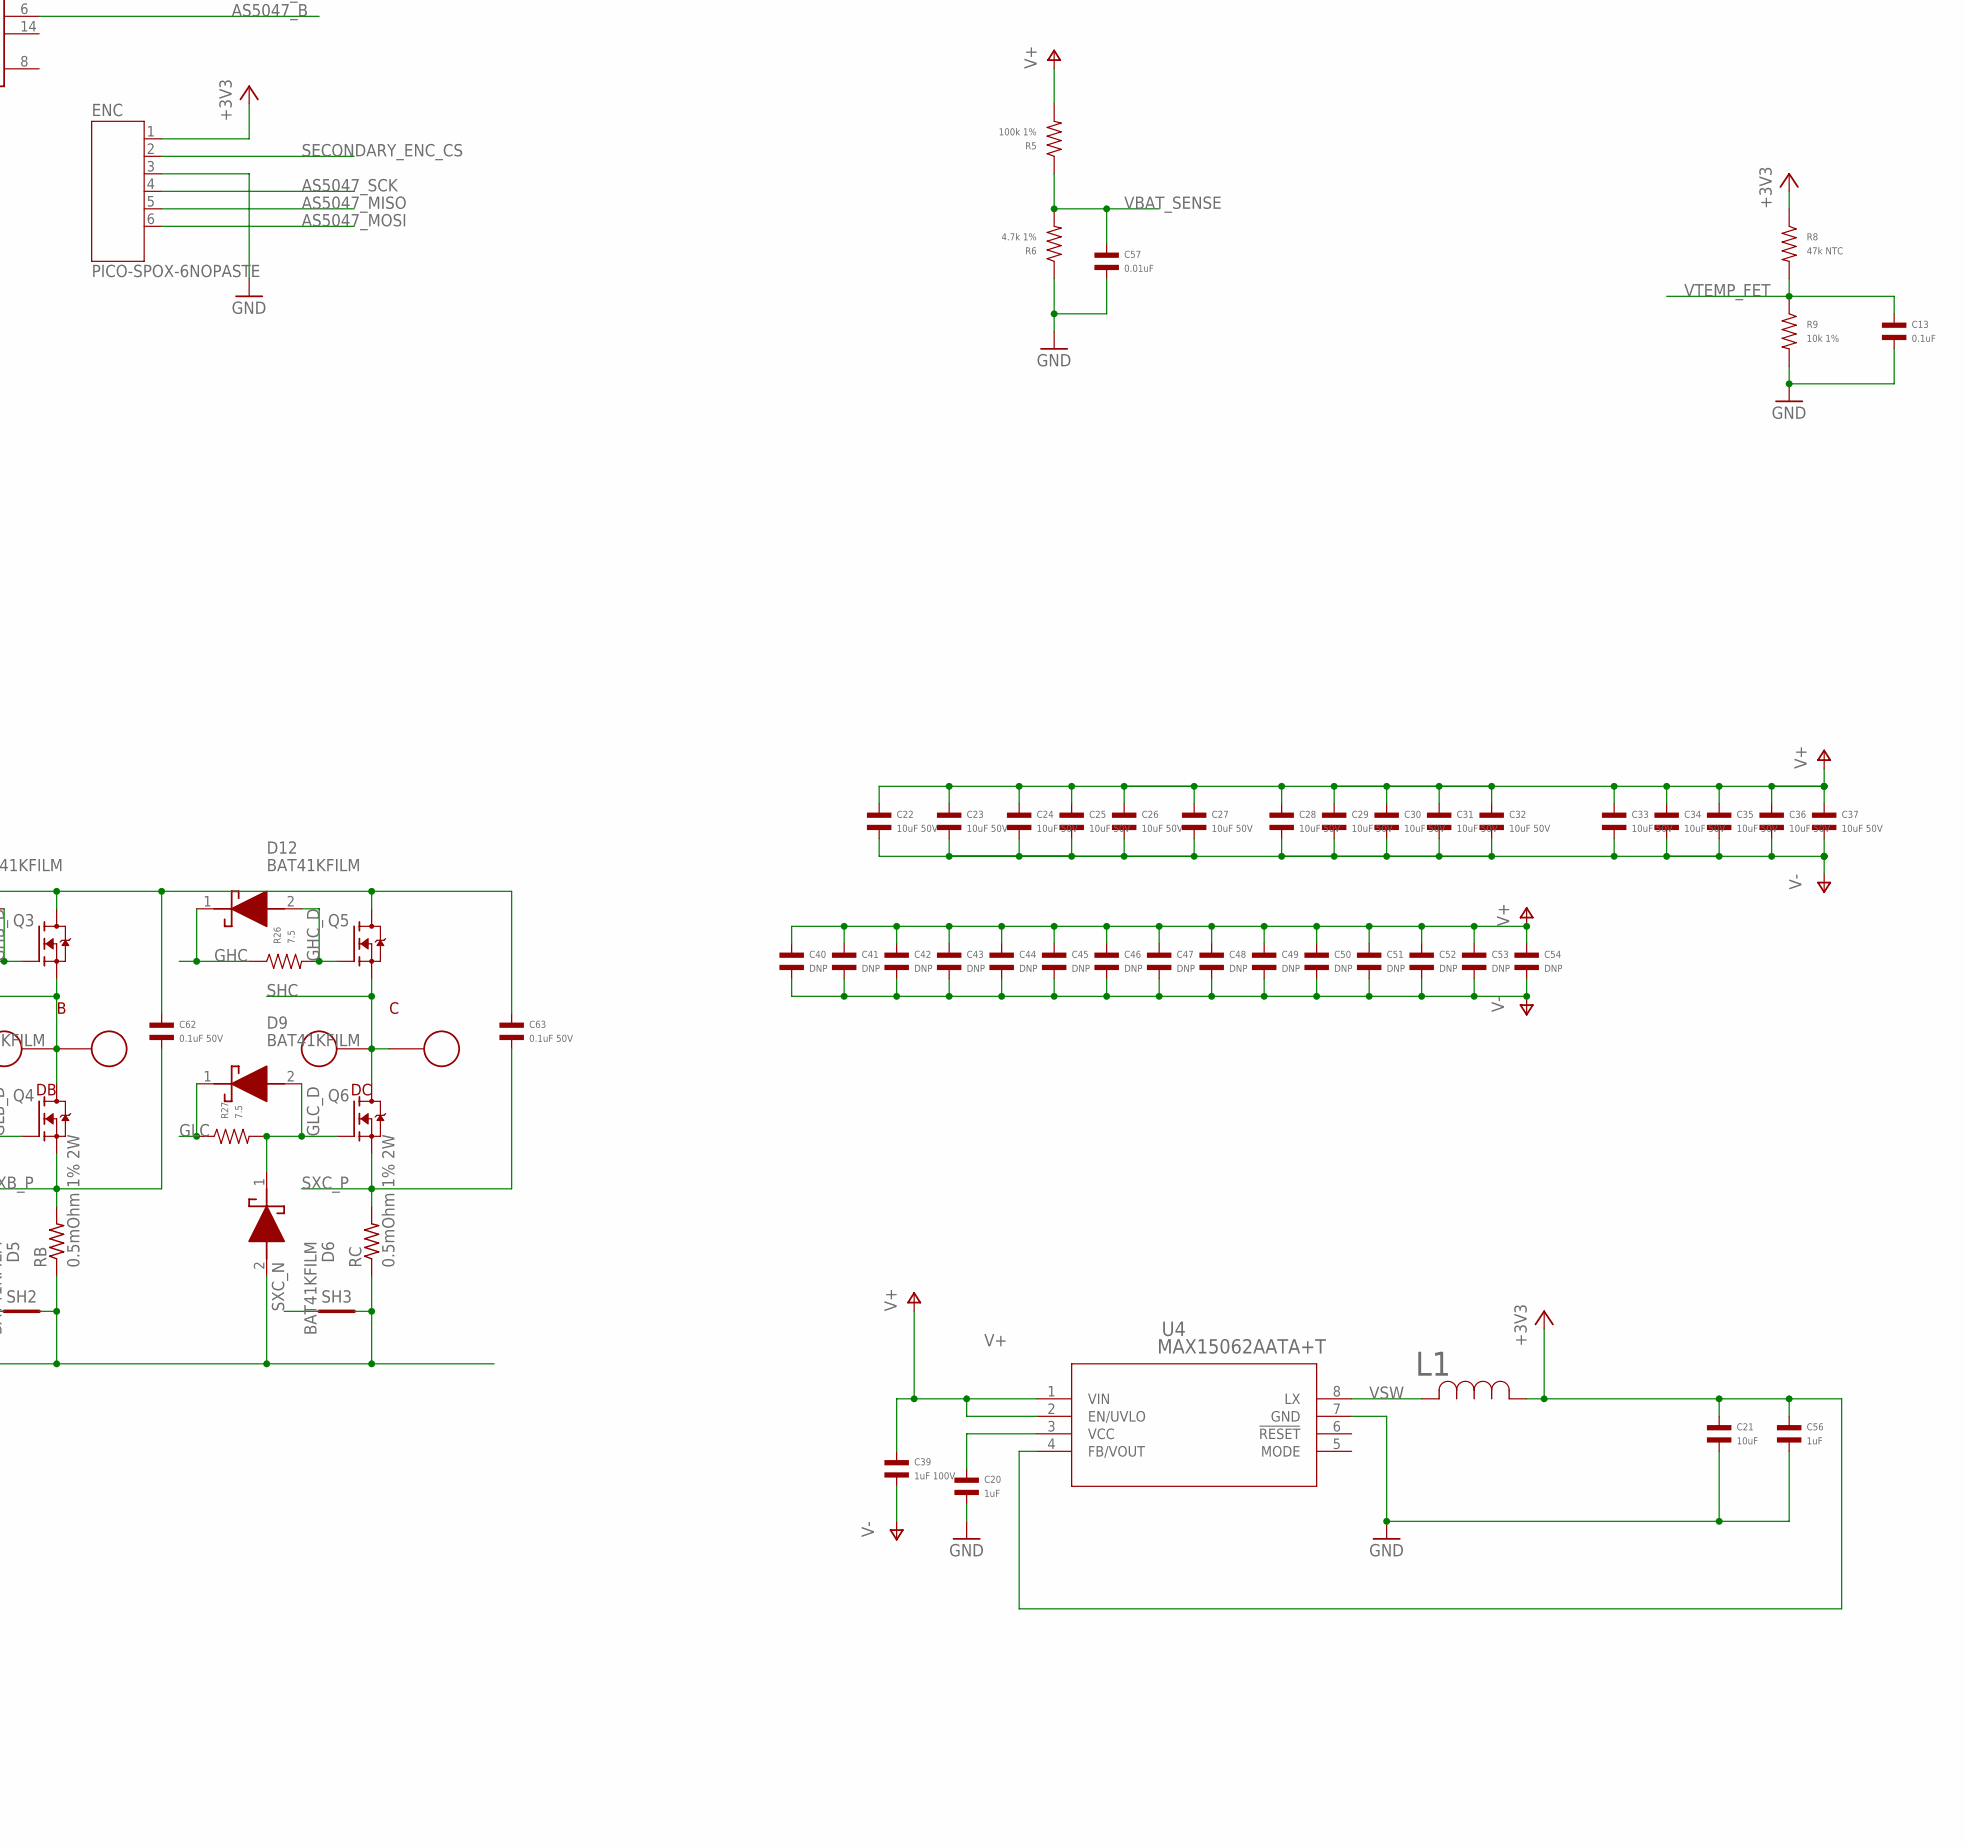
[picture p42: schematic controller_tcan334gdcnt.sch, part in row 2, column 2]

Parts:
A: PAD16AWG_PAD; 16AWG_PAD
ABS: JST_ZH4; JST_S4B-ZR-SM4A-TF(LF)(SN); MPN S4B-ZR-SM4A-TF(LF)(SN)
B: PAD16AWG_PAD; 16AWG_PAD
C: PAD16AWG_PAD; 16AWG_PAD
C1, C2, C3, C5, C6, C8, C10, C12, C13, C18: 0.1uF; C0402; MPN MF-CAP-0402-0.1uF
C4, C9, C15, C17, C56: 1uF; C0402; MPN MF-CAP-0402-1uF
C7, C21: 10uF; C1206; MPN MF-CAP-1206-10uF
C11: 0.1uF; C0402_NOBORDER; MPN MF-CAP-0402-0.1uF
C14, C16: 0.1uF 50V; C0402; MPN CGA2B3X7R1H104K050BB
C19: 0.47uF 50V; C0402; MPN GRM155R61H474KE11D
C20: 1uF; C0603; MPN MF-CAP-0603-1uF
C22, C23, C24, C25, C26, C27, C28, C29, C30, C31, C32, C33, C34, C36, C37: 10uF 50V; C1206; MPN C3216X7R1H106K160AE
C35: 10uF 50V; C1206_NOBORDER; MPN C3216X7R1H106K160AE
C38: 1uF; C0603; MPN C1608X7R1E105K080AE
C39: 1uF 100V; C0805; MPN GCM21BC72A105KE36L
C40, C41, C42, C43, C44, C45, C46, C47, C48, C49, C50, C51, C52, C53, C54: DNP; C1206_NOCREAM
C55: DNP; C0402
C57: 0.01uF; C0402; MPN MF-CAP-0402-0.01uF
C58, C59, C60: 1000pF; C0402_NOBORDER; MPN MF-CAP-0402-1nF
C61, C63: 0.1uF 50V; C1206; MPN 12065C104KAZ2A
C62: 0.1uF 50V; C0603_NOBORDER; MPN 06035C104KAZ2A
CAN1, CAN2: JST-PH3; JST_S3B-PH-SM4-TB(LF)(SN); MPN S3B-PH-SM4-TB(LF)(SN)
D1, D5, D6, D7, D8, D9, D10, D11, D12: BAT41KFILM; SODFL1608X70N; MPN BAT41KFILM
D2: MF-LED-0603-RED; LED0603; MPN MF-LED-0603-GREEN
D3: MF-LED-0603-RED; LED0603
D4: DUAL_TVS; SOT23-3; MPN CDSOT23-0502B
D33: PAD24AWG_PAD; 24AWG_PAD
DA: PAD24AWG_PAD; 24AWG_PAD
DAC: PAD24AWG_PAD; 24AWG_PAD
DB: PAD24AWG_PAD; 24AWG_PAD
DBG1, DBG2: PAD24AWG_PAD; 24AWG_PAD
DC: PAD24AWG_PAD; 24AWG_PAD
DG1, DG2: PAD24AWG_PAD; 24AWG_PAD
DRV_CS: PAD24AWG_PAD; 24AWG_PAD
DRV_MISO: PAD24AWG_PAD; 24AWG_PAD
DRV_MOSI: PAD24AWG_PAD; 24AWG_PAD
DRV_SCK: PAD24AWG_PAD; 24AWG_PAD
DTR: PAD24AWG_PAD; 24AWG_PAD
DTX: PAD24AWG_PAD; 24AWG_PAD
ENC: PICO-SPOX-6NOPASTE; PICO-SPOX-SMT-RA-6-NOPASTE
J1, J2: XT30XT30PW_MALE; XT30PW_MALE
L1: SRN4018-220M; IND_BOURNS_SRN4018; MANUFACTURER_PART_NUMBER SRN4018-330M
L2, L3: HALF_CHOKE; 1812_COMMON_HALF; MPN MF-RES-0805-0
M1, M2, M3, M4: MOUNT; M2.5MOUNT
MOT1, MOT2, MOT3: PAD24AWG_PAD; 24AWG_PAD
Q1, Q2, Q3, Q4, Q5, Q6: TPH1R204PLSOP_ADVANCE_8; SOP_ADVANCE_8; MPN TPH2R506PL,L1Q
R1, R2: 560; R0402; MPN MF-RES-0402-560
R3, R4, R13, R14: 2k; R0402; MPN MF-RES-0402-2K
R5: 100k 1%; R0402; MPN RC0402FR-07100KL
R6: 4.7k 1%; R0402; MPN RC0402FR-074K7L
R7, R9: 10k 1%; R0402; MPN RC0402FR-0710KL
R8: 47k NTC; R0402; MPN NCP15WB473F03RC
R10: DNP; R0402
R15, R16, R17: 22; R0402_NOBORDER; MPN MF-RES-0402-22
R22, R23, R24, R25, R26, R27: 7.5; R0402; MPN RC0402FR-077R5L
RA: 0.5mOhm 1% 2W; M1206; MPN HCS1206FTL500
RB: 0.5mOhm 1% 2W; M1206; MPN HCS1206FTL500
RC: 0.5mOhm 1% 2W; M1206; MPN HCS1206FTL500
SH1, SH2, SH3: SHORTT5; SHORT_TOP-50
SH4: SHORTMEDIUM; SHORT_TOP-MEDIUM
SWD: JST-ZH6; JST_S6B-ZR-SM4A-TF(LF)(SN); MPN S6B-ZR-SM4A-TF(LF)(SN)
TEMP1, TEMP2: PAD24AWG_PAD; 24AWG_PAD
U1: STM32G474CEU6; QFN50P700X700X60-49N; MPN STM32G474CEU6
U2: TCAN334G; SOIC8; MPN TCAN337GDR
U3: AS5147; TSSOP14; MPN AS5047P-ATSM
U4: MAX15062AATA+T; 21-0487A_MXM; MPN MAX15062AATA+T
U5: DRV8353S; WQFN-40; MPN DRV8353FSRTAR
U6: TCAN334GSOT23; SOT23-8; MPN TCAN334GDCNT

Connections:
+3V3: ABS.1, C1.P$1, C2.P$1, C4.P$1, C5.P$1, C6.P$1, C7.P$2, C8.P$1, C9.P$1, C10.P$1, C11.P$1, C12.P$1, C18.P$2, C21.P$1, C56.P$1, D33.P$1, ENC.1, L1.1, R1.P$1, R2.P$1, R3.P$1, R4.P$1, R8.P$1, R13.P$1, R14.P$1, SWD.6, TEMP1.P$1, U1.1 (VBAT), U1.20 (VREF+), U1.21 (VDDA), U1.23 (VDD_1), U1.35 (VDD_2), U1.48 (VDD_3), U2.3 (VCC), U3.12 (VDD3V), U4.4 (FB/VOUT), U5.24 (VREF), U6.3 (VCC)
AS5047_A: U1.43 (PB5), U3.7 (A)
AS5047_B: U1.42 (PB4), U3.6 (B)
AS5047_CS: U1.24 (PB11), U3.1 (CS/)
AS5047_MISO: ENC.5, U1.27 (PB14), U3.3 (MISO)
AS5047_MOSI: ENC.6, U1.28 (PB15), U3.4 (MOSI)
AS5047_SCK: ENC.4, U1.26 (PB13), U3.2 (CLK)
CAN2_N: L2.P$2 (2), U2.6 (CANL), U6.6 (CANL)
CAN2_P: L3.P$2 (2), U2.7 (CANH), U6.7 (CANH)
CAN_N: CAN1.2, CAN2.2, D4.2, L2.P$1 (1)
CAN_P: CAN1.1, CAN2.1, D4.1, L3.P$1 (1)
CAN_RX: U1.33 (PA11), U2.4 (RXD), U6.4 (RXD)
CAN_TX: U1.34 (PA12), U2.1 (TXD), U6.1 (TXD)
CUR1: R15.P$1, U5.23 (SOA)
CUR2: R16.P$1, U5.22 (SOB)
CUR3: R17.P$1, U5.21 (SOC)
DAC: DAC.P$1, U1.12 (PA4)
DEBUG1: DBG1.P$1, U1.3 (PC14-OSC32_IN)
DEBUG2: DBG2.P$1, U1.4 (PC15-OSC32_OUT)
DEBUG_RX: DTR.P$1, U1.40 (PC11)
DEBUG_TX: DTX.P$1, U1.39 (PC10)
DRV8323_CS: DRV_CS.P$1, U1.16 (PC4), U5.30 (CS)
DRV8323_MISO: DRV_MISO.P$1, R13.P$2, U1.14 (PA6), U5.27 (MISO)
DRV8323_MOSI: DRV_MOSI.P$1, U1.15 (PA7), U5.28 (MOSI)
DRV8323_SCLK: DRV_SCK.P$1, U1.13 (PA5), U5.29 (SCLK)
FCUR1: C58.P$1, R15.P$2, U1.17 (PB0)
FCUR2: C59.P$1, R16.P$2, U1.18 (PB1)
FCUR3: C60.P$1, R17.P$2, U1.19 (PB2)
GHA: D10.1 (K), R22.P$1, U5.6 (GHA)
GHA_D: D10.2 (A), Q1.4 (G), R22.P$2
GHB: D11.1 (K), R24.P$1, U5.15 (GHB)
GHB_D: D11.2 (A), Q3.4 (G), R24.P$2
GHC: D12.1 (K), R26.P$1, U5.16 (GHC)
GHC_D: D12.2 (A), Q5.4 (G), R26.P$2
GLA: D7.1 (K), R23.P$1, U5.8 (GLA)
GLA_D: D1.1 (K), D7.2 (A), Q2.4 (G), R23.P$2
GLB: D8.1 (K), R25.P$1, U5.13 (GLB)
GLB_D: D5.1 (K), D8.2 (A), Q4.4 (G), R25.P$2
GLC: D9.1 (K), R27.P$1, U5.18 (GLC)
GLC_D: D6.1 (K), D9.2 (A), Q6.4 (G), R27.P$2
GND: ABS.4, C1.P$2, C2.P$2, C3.P$2, C4.P$2, C5.P$2, C6.P$2, C7.P$1, C8.P$2, C9.P$2, C10.P$2, C11.P$2, C12.P$2, C13.P$2, C18.P$1, C20.P$2, C21.P$2, C56.P$2, C57.P$2, C58.P$2, C59.P$2, C60.P$2, CAN1.3, CAN2.3, D4.3, DG1.P$1, DG2.P$1, ENC.3, R6.P$1, R7.P$2, R9.P$2, SH4.2, SWD.4, U1.32 (PA10), U1.49 (THERMALPAD), U2.2 (GND), U2.5 (SHDN), U2.8 (STB), U3.5 (TEST), U3.13 (GND), U4.7 (GND), U5.25 (AGND), U6.2 (GND), U6.5 (SHDN), U6.8 (STB)
I2C_ABS_SCL: ABS.2, R4.P$2, U1.46 (PB8-BOOT0)
I2C_ABS_SDA: ABS.3, R3.P$2, U1.47 (PB9)
LED1: D3.CATHODE, U1.5 (PF0-OSC_IN)
LED2: D2.CATHODE, U1.6 (PF1-OSC_OUT)
MOTOR1: MOT1.P$1, U1.8 (PA0), U5.32 (INHA)
MOTOR2: MOT2.P$1, U1.9 (PA1), U5.34 (INHB)
MOTOR3: MOT3.P$1, U1.10 (PA2), U5.36 (INHC)
MOTOR_ENABLE: U1.11 (PA3), U5.31 (ENABLE)
MOTOR_FAULT: R14.P$2, U1.44 (PB6), U5.26 (FAULT)
MOTOR_HIZ: U1.45 (PB7), U5.33 (INLA), U5.35 (INLB), U5.37 (INLC)
unnamed: C55.P$1, M3.P$1, R10.P$1
unnamed: C38.P$2, U5.40 (VGLS)
unnamed: C20.P$1, U4.3 (VCC)
unnamed: C16.P$2, U5.1 (CPL)
unnamed: C16.P$1, U5.2 (CPH)
unnamed: C15.P$2, U5.5 (VCP)
unnamed: C17.P$2, U5.38 (DVDD)
unnamed: D3.ANODE, R1.P$2
unnamed: D2.ANODE, R2.P$2
NRST: C3.P$1, SWD.2, U1.7 (PG10-NRST)
SECONDARY_ENC_CS: ENC.2, U1.2 (PC13)
SHA: A.1, DA.P$1, Q1.1 (S), Q1.2 (S), Q1.3 (S), Q2.5 (D), Q2.6 (D), Q2.7 (D), Q2.8 (D), Q2.PAD (D), U5.7 (SHA)
SHB: B.1, DB.P$1, Q3.1 (S), Q3.2 (S), Q3.3 (S), Q4.5 (D), Q4.6 (D), Q4.7 (D), Q4.8 (D), Q4.PAD (D), U5.14 (SHB)
SHC: C.1, DC.P$1, Q5.1 (S), Q5.2 (S), Q5.3 (S), Q6.5 (D), Q6.6 (D), Q6.7 (D), Q6.8 (D), Q6.PAD (D), U5.17 (SHC)
SWCLK: SWD.5, U1.37 (PA14)
SWDIO: SWD.3, U1.36 (PA13)
SXA_N: SH1.1, U5.10 (SNA)
SXA_P: C61.P$2, Q2.1 (S), Q2.2 (S), Q2.3 (S), RA.2, U5.9 (SPA)
SXB_N: SH2.1, U5.11 (SNB)
SXB_P: C62.P$2, Q4.1 (S), Q4.2 (S), Q4.3 (S), RB.2, U5.12 (SPB)
SXC_N: SH3.1, U5.20 (SNC)
SXC_P: C63.P$2, Q6.1 (S), Q6.2 (S), Q6.3 (S), RC.2, U5.19 (SPC)
V+: C14.P$1, C15.P$1, C19.P$1, C22.P$1, C23.P$1, C24.P$1, C25.P$1, C26.P$1, C27.P$1, C28.P$1, C29.P$1, C30.P$1, C31.P$1, C32.P$1, C33.P$1, C34.P$1, C35.P$1, C36.P$1, C37.P$1, C39.P$1, C40.P$1, C41.P$1, C42.P$1, C43.P$1, C44.P$1, C45.P$1, C46.P$1, C47.P$1, C48.P$1, C49.P$1, C50.P$1, C51.P$1, C52.P$1, C53.P$1, C54.P$1, C61.P$1, C62.P$1, C63.P$1, J1.1, J2.1, Q1.5 (D), Q1.6 (D), Q1.7 (D), Q1.8 (D), Q1.PAD (D), Q3.5 (D), Q3.6 (D), Q3.7 (D), Q3.8 (D), Q3.PAD (D), Q5.5 (D), Q5.6 (D), Q5.7 (D), Q5.8 (D), Q5.PAD (D), R5.P$2, U4.1 (VIN), U4.2 (EN/UVLO), U5.3 (VM), U5.4 (VDRAIN)
V-: C14.P$2, C17.P$1, C19.P$2, C22.P$2, C23.P$2, C24.P$2, C25.P$2, C26.P$2, C27.P$2, C28.P$2, C29.P$2, C30.P$2, C31.P$2, C32.P$2, C33.P$2, C34.P$2, C35.P$2, C36.P$2, C37.P$2, C38.P$1, C39.P$2, C40.P$2, C41.P$2, C42.P$2, C43.P$2, C44.P$2, C45.P$2, C46.P$2, C47.P$2, C48.P$2, C49.P$2, C50.P$2, C51.P$2, C52.P$2, C53.P$2, C54.P$2, C55.P$2, D1.2 (A), D5.2 (A), D6.2 (A), J1.2, J2.2, R10.P$2, RA.1, RB.1, RC.1, SH1.2, SH2.2, SH3.2, SH4.1, U5.39 (GND), U5.P1 (PAD), U5.P2 (PAD), U5.P3 (PAD), U5.P7 (PAD), U5.P8 (PAD), U5.P9 (PAD), U5.P12 (PAD), U5.P13 (PAD), U5.P14 (PAD), U5.P17 (PAD), U5.P18 (PAD), U5.P19 (PAD), U5.PAD
VBAT_SENSE: C57.P$1, R5.P$1, R6.P$2, U1.25 (PB12)
VSW: L1.2, U4.8 (LX)
VTEMP_FET: C13.P$1, R8.P$2, R9.P$1, U1.31 (PA9)
VTEMP_MOT: R7.P$1, TEMP2.P$1, U1.30 (PA8)

Notes on the sheet:
PA10/PA15/PC6 Version 011
L2/L3 SIZED TO HOLD EITHER A) 2x 0805 0 OHM RESISTORS B) A COILCRAFT 1812CAN SERIES COMMON MODE CHOKE
ALTERNATE PARTS CAN USE SOIC-8 OR SOT-23 FOOTPRINTS

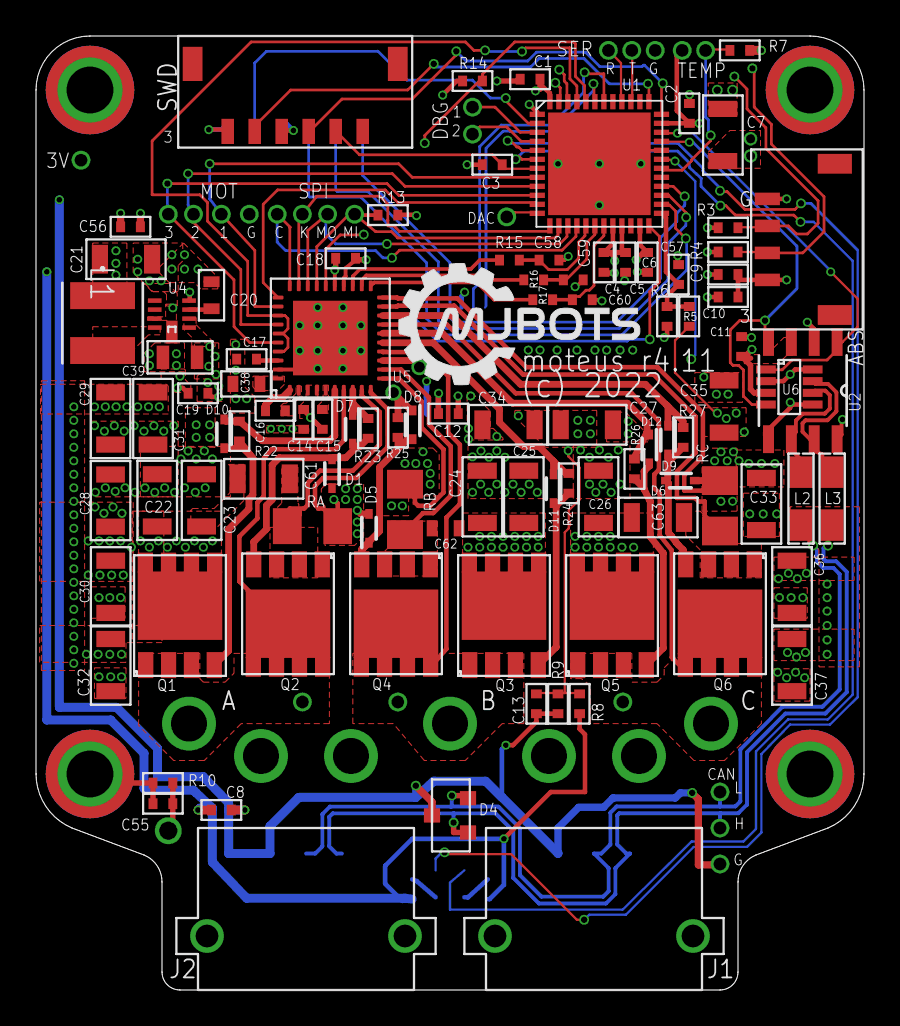
[picture p43: board controller_tcan334gdcnt.brd from above]

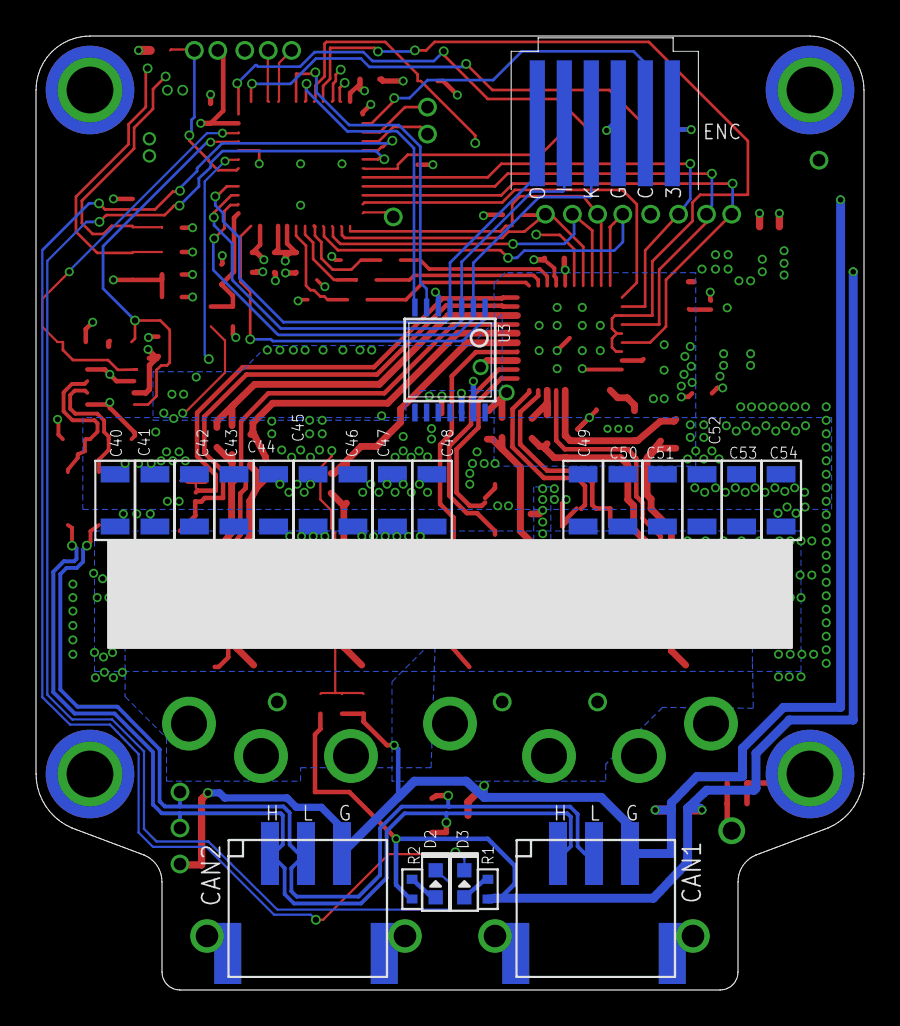
[picture p44: board controller_tcan334gdcnt.brd from below]

Board: 4 copper layers, 46.0 x 53.0 mm, 152 parts (23 on the bottom side), 79 nets.
