lingluo831/mymoteus/hw/n1/moteus_n1.brd

## EAGLE design hw/n1/moteus_n1.brd (2025-04-23)

Schematic: moteus_n1.sch

Parts:
A: PAD16AWG_TERM; 16AWG_TERM
AUX1: SM08B-GHS-TB(LF)(SN); JST_SM08B-GHS-TB(LF)(SN); MPN SM08B-GHS-TB(LF)(SN)
AUX2: SM07B-GHS-TB(LF)(SN); JST_SM07B-GHS-TB(LF)(SN); MPN SM07B-GHS-TB(LF)(SN)
AUX2H: PH2X4
B: PAD16AWG_TERM; 16AWG_TERM
C: PAD16AWG_TERM; 16AWG_TERM
C1, C19, C20, C21, C22, C25, C26, C27, C28, C29: DNP; C0402
C2: 1uF 100V; C0805; MPN GCM21BC72A105KE36L
C3, C17, C18, C23\, C24: 1uF; C0603; MPN MF-CAP-0603-1uF
C4: 22uF; C1206; MPN GRM31CR71A226KE15L
C5, C11, C23, C41: 1uF; C0402; MPN MF-CAP-0402-1uF
C6: 22uF; C1206; MPN CL31B226KPHNNNE
C7, C8, C9, C12, C14, C15, C16, C30, C32, C33, C42, C87: 0.1uF; C0402; MPN MF-CAP-0402-0.1uF
C10: 4.7uF; C0603; MPN CL10A475KP8NNNC
C13: 10uF; C1206; MPN MF-CAP-1206-10uF
C31: 0.01uF; C0402; MPN MF-CAP-0402-0.01uF
C34, C35, C36: 1000pF; C0402; MPN MF-CAP-0402-1nF
C37, C39: 0.1uF 100V; C0603; MPN GCJ188R72A104KA01D
C38, C40: 1uF; C0603; MPN C1608X7R1E105K080AE
C43: 0.47uF 100V; C0805; MPN 08051C474KAT2A
C44, C45, C46: 0.1uF 100V; C1206; MPN 12061C104KAT2A
C47, C48: 4.7uF 100V; C1206; MPN GRJ31CC72A475KE01K
C49, C50, C51, C52, C53, C54, C55, C56, C57, C58, C59, C60, C61, C62, C63, C64, C65, C66, C67, C68, C69, C70, C71, C72, C73, C74, C75, C76, C77, C78, C79, C80, C81, C82, C83, C84, C85, C86: 4.7uF 100V; C1206_NOBORDER; MPN GRJ31CC72A475KE01K
CAN1, CAN2: JST-PH3; JST_S3B-PH-SM4-TB(LF)(SN); MPN S3B-PH-SM4-TB(LF)(SN)
CAN_DBG: 1X3
D1: MF-LED-0603-RED; LED0603
D2: MF-LED-0603-RED; LED0603; MPN MF-LED-0603-GREEN
D3, D4, D5, D6, D7, D8, D9, D10, D11, D13, D14, D15, D16: BAT41KFILM; SODFL1608X70N; MPN BAT41KFILM
D12: DIODE-DO214AA; DO214AA; MPN SMBJ51D-M3/I
D33, D50: PAD24AWG_PAD; 24AWG_PAD
DAC: PAD24AWG_PAD; 24AWG_PAD
DG1: PAD24AWG_PAD; 24AWG_PAD
DTR: PAD24AWG_PAD; 24AWG_PAD
DTX: PAD24AWG_PAD; 24AWG_PAD
J1, J2: XT30XT30PW_MALE; XT30PW_MALE; MPN XT30PW-M
J3: SM06B-GHS-TB(LF)(SN); JST_SM06B-GHS-TB(LF)(SN); MPN SM06B-GHS-TB(LF)(SN)
L1: SRN4018-220M; IND_BOURNS_SRN4018; MANUFACTURER_PART_NUMBER 74404042470
L2: 74479887222A; IND_1008_WE-PMI_WRE; MPN 74479887222A
M1, M2, M3, M4: MOUNT; M2.5MOUNT
Q1, Q3, Q5: TPH1R204PL_VIAS; SOP_ADVANCE_8_VIAS; MPN TPH2R408QM,L1Q
Q2, Q4, Q6: TPH1R204PLSOP_ADVANCE_8; SOP_ADVANCE_8; MPN TPH2R408QM,L1Q
R1, R3: DNP; R0402
R2, R15: 100k 1%; R0402; MPN RC0402FR-07100KL
R4, R5, R8, R9, R10, R11, R12, R13, R14: 100; R0402; MPN MF-RES-0402-100
R6, R7, R25, R26, R33, R34: 2k; R0402; MPN MF-RES-0402-2K
R16: 4.7k 1%; R0402; MPN RC0402FR-074K7L
R17: 47k NTC; R0402; MPN NCP15WB473F03RC
R18, R19: 10k 1%; R0402; MPN RC0402FR-0710KL
R20, R21: 560; R0402; MPN MF-RES-0402-560
R22, R23, R24: 22; R0402; MPN MF-RES-0402-22
R27, R28, R30, R31, R32: 7.5; R0402; MPN RC0402FR-077R5L
R29: 7.5; R0805; MPN RC0805FR-077R5L
R35, R36: 120; R0402; MPN RC0402FR-07120RL
R37: DNP; R0805
R38, R39, R40: 0; R0402; MPN MF-RES-0402-0
RA: 0.5mOhm 1% 2W; M1206; MPN HCS1206FTL500
RB: 0.5mOhm 1% 2W; M1206; MPN HCS1206FTL500
RC: 0.5mOhm 1% 2W; M1206; MPN HCS1206FTL500
SH1, SH2, SH3: SHORTT5; SHORT_TOP-50
SH4: SHORTMEDIUM; SHORT_TOP-MEDIUM
SWD: JST-ZH6; JST_S6B-ZR-SM4A-TF(LF)(SN); MPN S6B-ZR-SM4A-TF(LF)(SN)
TEMP: 1X2
U1: MAX15062BATA+T; 21-0487A_MXM; MANUFACTURER_PART_NUMBER MAX15062BATA+T
U2: ADP5301ACBZ-4-R7; BGA9C50P3X3_165X187X66; MPN ADP5301ACBZ-4-R7
U3: STM32G474CEU6; QFN50P700X700X60-49N; MPN STM32G474CEU6
U4: TCAN1042HGV; SOIC8; MPN TCAN1057AEVDRQ1
U5: AS5147; TSSOP14; MPN AS5047P-ATSM
U7: DRV8353S; WQFN-40; MPN DRV8353FSRTAR
U8: SN65HVD35DR; D14
VN: PAD16AWG_TERM; 16AWG_TERM
VP: PAD16AWG_TERM; 16AWG_TERM

Connections:
+3V3: AUX1.2, AUX2.2, AUX2H.P$4 (4), C6.P$1, C7.P$1, C8.P$1, C10.P$1, C11.P$1, C12.P$1, C13.P$2, C15.P$1, C16.P$1, C18.P$1, C23.P$1, C24.P$1, C30.P$1, C42.P$2, C87.P$1, D33.P$1, L2.1, R2.P$2, R17.P$1, R20.P$1, R21.P$1, R25.P$1, R26.P$1, R40.P$2, SWD.6, TEMP.1, U2.C2 (FB), U3.1 (VBAT), U3.20 (VREF+), U3.21 (VDDA), U3.23 (VDD_1), U3.35 (VDD_2), U3.48 (VDD_3), U4.5 (VIO), U5.12 (VDD3V), U7.24 (VREF), U8.13 (VCC_2), U8.14 (VCC)
+5V: AUX1.1, AUX2.1, AUX2H.P$2 (2), C4.P$1, C5.P$1, C14.P$1, C17.P$1, C23\.P$1, D50.P$1, J3.1, L1.1, R39.P$2, U1.4 (FB/VOUT), U2.A2 (PVIN), U2.A3 (EN), U4.3 (VCC)
AS5047_CS: U3.19 (PB2), U5.1 (CS/)
AUX1P_A: AUX1.3, R10.P$1
AUX1P_B: AUX1.4, R11.P$1
AUX1P_C: AUX1.5, R12.P$1
AUX1P_D: AUX1.6, R13.P$1
AUX1P_E: AUX1.7, R14.P$1
AUX1_A: C29.P$1, R10.P$2, U3.13 (PA5), U3.27 (PB14), U5.2 (CLK)
AUX1_B: C28.P$1, R11.P$2, U3.42 (PB4), U5.3 (MISO)
AUX1_C: C27.P$1, R12.P$2, U3.15 (PA7), U5.4 (MOSI)
AUX1_D: C26.P$1, DTR.P$1, R13.P$2, R34.P$2, U3.38 (PA15), U8.2 (R)
AUX1_E: C25.P$1, DTX.P$1, R14.P$2, R33.P$2, U3.41 (PB3), U3.47 (PB9), U8.5 (D)
AUX1_I2C_PULLUP: D13.2 (A), D14.2 (A), U3.46 (PB8-BOOT0)
AUX2P_A: AUX2.3, AUX2H.P$7 (7), AUX2H.P$8 (8), R4.P$1
AUX2P_B: AUX2.4, AUX2H.P$5 (5), R5.P$1
AUX2P_C: AUX2.5, AUX2H.P$3 (3), R9.P$1
AUX2P_D: AUX2.6, AUX2H.P$1 (1), R8.P$1
AUX2_A: C22.P$1, R4.P$2, U3.6 (PF1-OSC_OUT)
AUX2_B: C21.P$1, R5.P$2, R6.P$2, U3.5 (PF0-OSC_IN), U3.32 (PA10)
AUX2_C: C20.P$1, R7.P$2, R9.P$2, U3.16 (PC4), U3.33 (PA11)
AUX2_D: C19.P$1, R8.P$2, U3.45 (PB7)
AUX2_I2C_PULLUP: D15.2 (A), D16.2 (A), U3.34 (PA12)
CAN_N: CAN1.2, CAN2.2, CAN_DBG.2, R37.P$2, U4.6 (CANL)
CAN_P: CAN1.1, CAN2.1, CAN_DBG.1, R37.P$1, U4.7 (CANH)
CAN_RX: U3.43 (PB5), U4.4 (RXD)
CAN_TX: U3.44 (PB6), U4.1 (TXD)
CUR1: R22.P$1, U7.23 (SOA)
CUR2: R23.P$1, U7.22 (SOB)
CUR3: R24.P$1, U7.21 (SOC)
DAC: DAC.P$1, R2.P$1, R3.P$2, U3.12 (PA4)
DRV8323_CS: U3.17 (PB0), U7.30 (CS)
DRV8323_MISO: R25.P$2, U3.40 (PC11), U7.27 (MISO)
DRV8323_MOSI: U3.2 (PC13), U7.28 (MOSI)
DRV8323_SCLK: U3.39 (PC10), U7.29 (SCLK)
FCUR1: C34.P$1, R22.P$2, U3.11 (PA3)
FCUR2: C35.P$1, R23.P$2, U3.14 (PA6)
FCUR3: C36.P$1, R24.P$2, U3.18 (PB1)
GHA: D5.1 (K), R28.P$1, U7.6 (GHA)
GHA_D: D5.2 (A), Q1.4 (G), R28.P$2
GHB: D8.1 (K), R30.P$1, U7.15 (GHB)
GHB_D: D8.2 (A), Q3.4 (G), R30.P$2
GHC: D11.1 (K), R32.P$1, U7.16 (GHC)
GHC_D: D11.2 (A), Q5.4 (G), R32.P$2
GLA: D3.1 (K), R27.P$1, U7.8 (GLA)
GLA_D: D3.2 (A), D4.1 (K), Q2.4 (G), R27.P$2
GLB: D6.1 (K), R29.P$1, U7.13 (GLB)
GLB_D: D6.2 (A), D7.1 (K), Q4.4 (G), R29.P$2
GLC: D9.1 (K), R31.P$1, U7.18 (GLC)
GLC_D: D9.2 (A), D10.1 (K), Q6.4 (G), R31.P$2
GND: AUX1.8, AUX2.7, AUX2H.P$6 (6), C3.P$2, C4.P$2, C5.P$2, C6.P$2, C7.P$2, C8.P$2, C9.P$2, C10.P$2, C11.P$2, C12.P$2, C13.P$1, C14.P$2, C15.P$2, C16.P$2, C17.P$2, C18.P$2, C19.P$2, C20.P$2, C21.P$2, C22.P$2, C23.P$2, C23\.P$2, C24.P$2, C25.P$2, C26.P$2, C27.P$2, C28.P$2, C29.P$2, C30.P$2, C31.P$2, C32.P$2, C33.P$2, C34.P$2, C35.P$2, C36.P$2, C42.P$1, C87.P$2, CAN1.3, CAN2.3, CAN_DBG.3, DG1.P$1, J3.6, R3.P$1, R16.P$1, R18.P$2, R19.P$2, R38.P$1, SH4.2, SWD.4, U1.7 (GND), U2.B1 (PGND), U2.B2 (AGND), U3.49 (THERMALPAD), U4.2 (GND), U4.8 (STB), U5.5 (TEST), U5.13 (GND), U7.25 (AGND), U8.6 (GND_2), U8.7 (GND)
LED1: D1.CATHODE, U3.28 (PB15)
LED2: D2.CATHODE, U3.29 (PC6)
MOTOR1: U3.8 (PA0), U7.32 (INHA)
MOTOR2: U3.9 (PA1), U7.34 (INHB)
MOTOR3: U3.10 (PA2), U7.36 (INHC)
MOTOR_ENABLE: U3.3 (PC14-OSC32_IN), U7.31 (ENABLE)
MOTOR_FAULT: R26.P$2, U3.26 (PB13), U7.26 (FAULT)
MOTOR_HIZ: U3.4 (PC15-OSC32_OUT), U7.33 (INLA), U7.35 (INLB), U7.37 (INLC)
unnamed: C1.P$1, M3.P$1, R1.P$1
unnamed: C40.P$2, U7.40 (VGLS)
unnamed: R40.P$1, U5.11 (VDD5V)
unnamed: C3.P$1, U1.3 (VCC)
unnamed: L2.2, U2.A1 (SW)
unnamed: C39.P$2, U7.1 (CPL)
unnamed: C39.P$1, U7.2 (CPH)
unnamed: C38.P$2, U7.5 (VCP)
unnamed: C41.P$2, U7.38 (DVDD)
unnamed: D1.ANODE, R20.P$2
unnamed: D2.ANODE, R21.P$2
unnamed: R38.P$2, U1.5 (MODE)
unnamed: D14.1 (K), R34.P$1
unnamed: R39.P$1, U2.B3 (SYNC/_MODE)
unnamed: D13.1 (K), R33.P$1
unnamed: D15.1 (K), R6.P$1
unnamed: D16.1 (K), R7.P$1
NRST: C9.P$1, SWD.2, U3.7 (PG10-NRST)
RS422_A: J3.2, R35.P$2, U8.12 (A)
RS422_B: J3.3, R35.P$1, U8.11 (B)
RS422_DE: U3.24 (PB11), U8.4 (DE)
RS422_RE: U3.22 (PB10), U8.3 (!RE)
RS422_Y: J3.4, R36.P$2, U8.9 (Y)
RS422_Z: J3.5, R36.P$1, U8.10 (Z)
SHA: A.1, A.2, A.3, A.4, A.5, A.6, A.7, A.8, A.9, A.10, A.11, A.12, A.13, Q1.1 (S), Q1.2 (S), Q1.3 (S), Q2.5 (D), Q2.6 (D), Q2.7 (D), Q2.8 (D), Q2.PAD (D), U7.7 (SHA)
SHB: B.1, B.2, B.3, B.4, B.5, B.6, B.7, B.8, B.9, B.10, B.11, B.12, B.13, Q3.1 (S), Q3.2 (S), Q3.3 (S), Q4.5 (D), Q4.6 (D), Q4.7 (D), Q4.8 (D), Q4.PAD (D), U7.14 (SHB)
SHC: C.1, C.2, C.3, C.4, C.5, C.6, C.7, C.8, C.9, C.10, C.11, C.12, C.13, Q5.1 (S), Q5.2 (S), Q5.3 (S), Q6.5 (D), Q6.6 (D), Q6.7 (D), Q6.8 (D), Q6.PAD (D), U7.17 (SHC)
SWCLK: SWD.5, U3.37 (PA14)
SWDIO: SWD.3, U3.36 (PA13)
SXA_N: SH1.1, U7.10 (SNA)
SXA_P: C44.P$2, Q2.1 (S), Q2.2 (S), Q2.3 (S), RA.2, U7.9 (SPA)
SXB_N: SH2.1, U7.11 (SNB)
SXB_P: C45.P$2, Q4.1 (S), Q4.2 (S), Q4.3 (S), RB.2, U7.12 (SPB)
SXC_N: SH3.1, U7.20 (SNC)
SXC_P: C46.P$2, Q6.1 (S), Q6.2 (S), Q6.3 (S), RC.2, U7.19 (SPC)
V+: C2.P$1, C37.P$1, C38.P$1, C43.P$1, C44.P$1, C45.P$1, C46.P$1, C47.P$1, C48.P$1, C49.P$1, C50.P$1, C51.P$1, C52.P$1, C53.P$1, C54.P$1, C55.P$1, C56.P$1, C57.P$1, C58.P$1, C59.P$1, C60.P$1, C61.P$1, C62.P$1, C63.P$1, C64.P$1, C65.P$1, C66.P$1, C67.P$1, C68.P$1, C69.P$1, C70.P$1, C71.P$1, C72.P$1, C73.P$1, C74.P$1, C75.P$1, C76.P$1, C77.P$1, C78.P$1, C79.P$1, C80.P$1, C81.P$1, C82.P$1, C83.P$1, C84.P$1, C85.P$1, C86.P$1, D12.C, J1.1, J2.1, Q1.5 (D), Q1.6 (D), Q1.7 (D), Q1.8 (D), Q1.PAD (D), Q3.5 (D), Q3.6 (D), Q3.7 (D), Q3.8 (D), Q3.PAD (D), Q5.5 (D), Q5.6 (D), Q5.7 (D), Q5.8 (D), Q5.PAD (D), R15.P$2, U1.1 (VIN), U1.2 (EN/UVLO), U7.3 (VM), U7.4 (VDRAIN), VP.1, VP.2, VP.3, VP.4, VP.5, VP.6, VP.7, VP.8, VP.9, VP.10, VP.11, VP.12, VP.13
V-: C1.P$2, C2.P$2, C37.P$2, C40.P$1, C41.P$1, C43.P$2, C47.P$2, C48.P$2, C49.P$2, C50.P$2, C51.P$2, C52.P$2, C53.P$2, C54.P$2, C55.P$2, C56.P$2, C57.P$2, C58.P$2, C59.P$2, C60.P$2, C61.P$2, C62.P$2, C63.P$2, C64.P$2, C65.P$2, C66.P$2, C67.P$2, C68.P$2, C69.P$2, C70.P$2, C71.P$2, C72.P$2, C73.P$2, C74.P$2, C75.P$2, C76.P$2, C77.P$2, C78.P$2, C79.P$2, C80.P$2, C81.P$2, C82.P$2, C83.P$2, C84.P$2, C85.P$2, C86.P$2, D4.2 (A), D7.2 (A), D10.2 (A), D12.A, J1.2, J2.2, R1.P$2, RA.1, RB.1, RC.1, SH1.2, SH2.2, SH3.2, SH4.1, U7.39 (GND), U7.PAD, VN.1, VN.2, VN.3, VN.4, VN.5, VN.6, VN.7, VN.8, VN.9, VN.10, VN.11, VN.12, VN.13
VBAT_SENSE: C31.P$1, R15.P$1, R16.P$2, U3.31 (PA9)
VSW: L1.2, U1.8 (LX)
VTEMP_FET: C32.P$1, R17.P$2, R18.P$1, U3.25 (PB12)
VTEMP_MOT: C33.P$1, R19.P$1, TEMP.2, U3.30 (PA8)

Notes on the sheet:
PCB rev divider HI / LO r1.1/r1.2 - open / 100k r1.3 - 100k / open

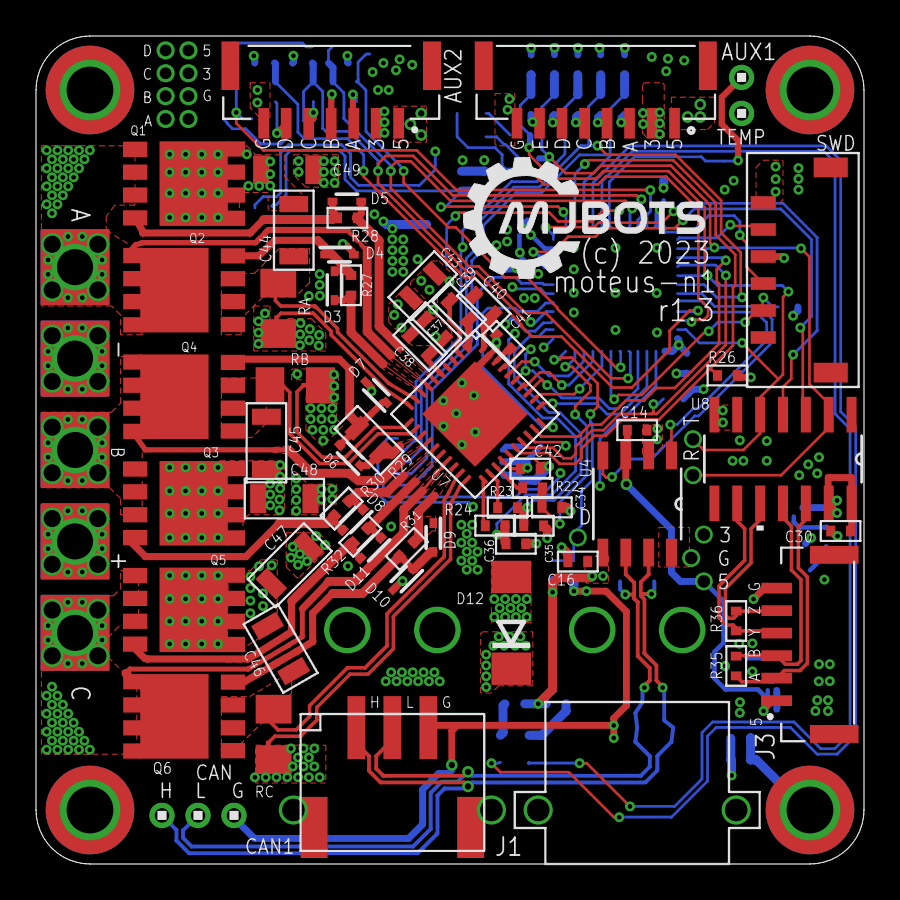
[picture p51: board hw/n1/moteus_n1.brd from above]

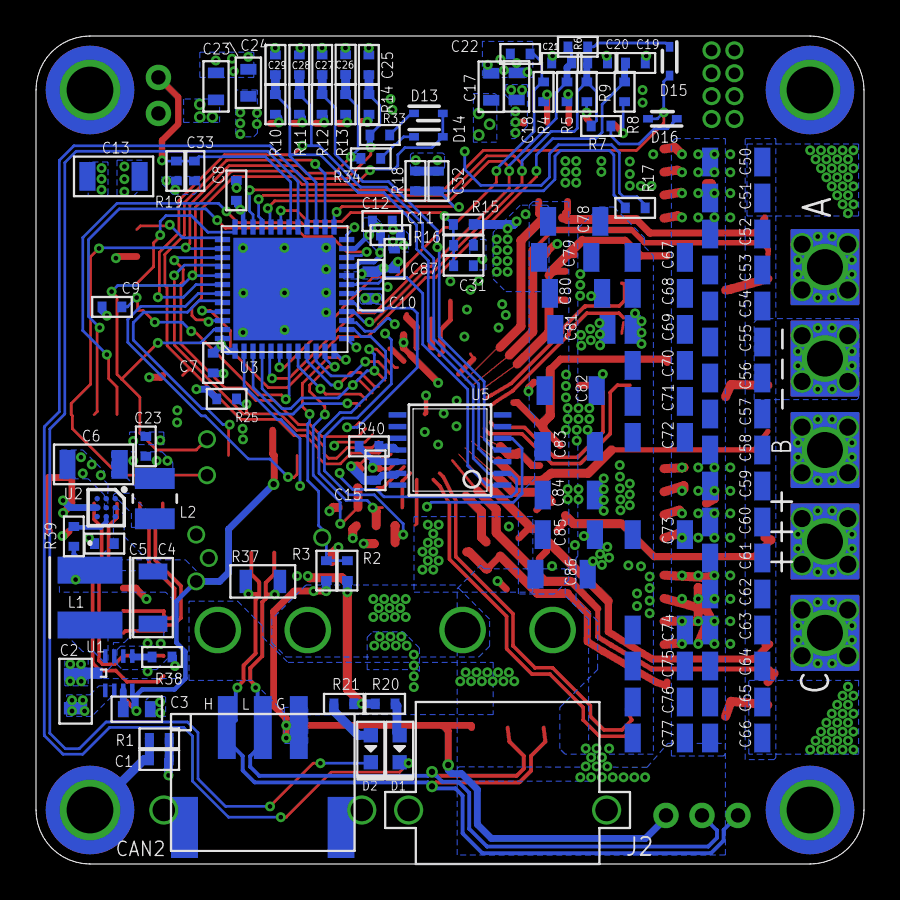
[picture p52: board hw/n1/moteus_n1.brd from below]

Board: 4 copper layers, 46.0 x 46.0 mm, 192 parts (117 on the bottom side), 100 nets.
