lingluo831/mymoteus/hw/ma732_adapter/ma732_adapter.brd

## EAGLE design hw/ma732_adapter/ma732_adapter.brd (2025-04-23)

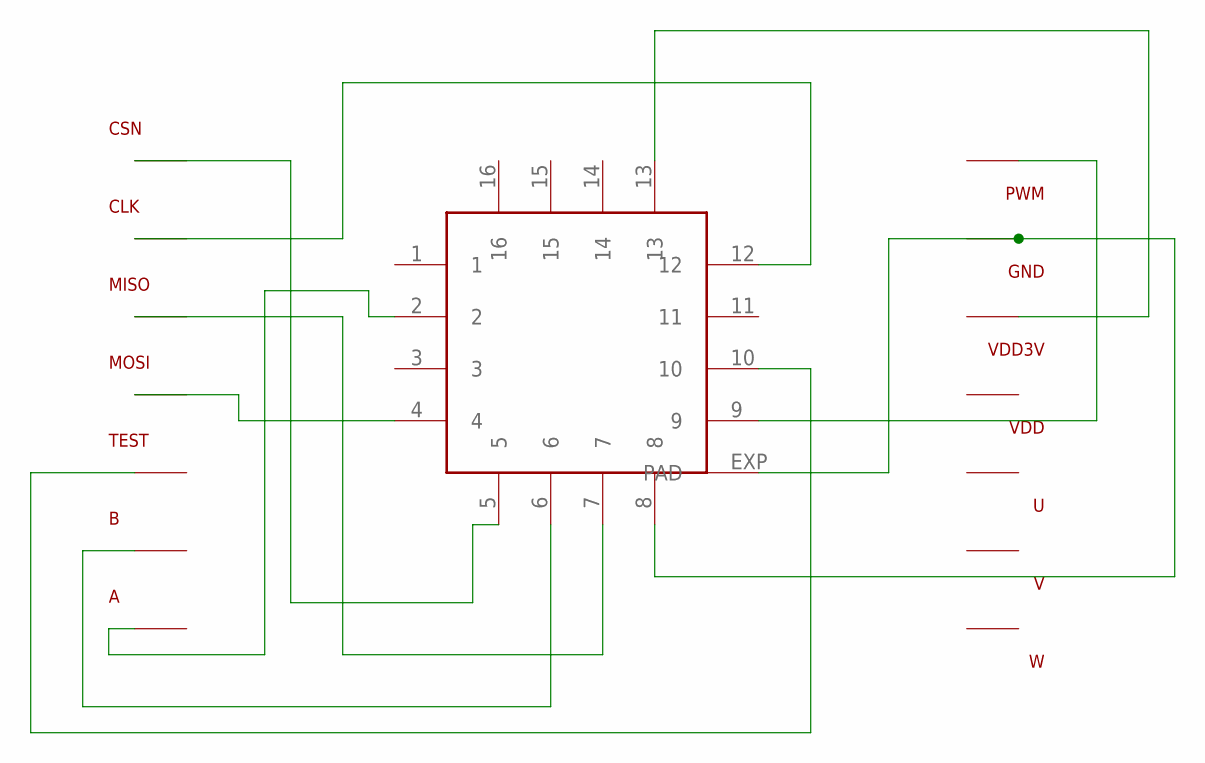
[picture p53: schematic ma732_adapter.sch]

Parts:
A: TSSOP_PAD
B: TSSOP_PAD
CLK: TSSOP_PAD
CSN: TSSOP_PAD
GND: TSSOP_PAD
MISO: TSSOP_PAD
MOSI: TSSOP_PAD
PWM: TSSOP_PAD
TEST: TSSOP_PAD
U: TSSOP_PAD
U$1: QFN16-BO; QFN16
V: TSSOP_PAD
VDD, VDD3V: TSSOP_PAD
W: TSSOP_PAD

Connections:
unnamed: CSN.P$1, U$1.5
unnamed: CLK.P$1, U$1.12
unnamed: MISO.P$1, U$1.7
unnamed: MOSI.P$1, U$1.4
unnamed: TEST.P$1, U$1.10
unnamed: B.P$1, U$1.6
unnamed: A.P$1, U$1.2
unnamed: PWM.P$1, U$1.9
unnamed: GND.P$1, U$1.8, U$1.EXP (PAD)
unnamed: U$1.13, VDD3V.P$1

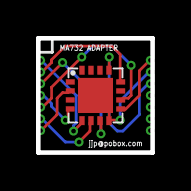
[picture p54: board ma732_adapter.brd from above]

Board: 2 copper layers, 6.3 x 6.3 mm, 15 parts (0 on the bottom side), 10 nets.
