lingluo831/mymoteus/fw/moteus_hw.cc

// Copyright 2023 mjbots Robotic Systems, LLC.  info@mjbots.com
//
// Licensed under the Apache License, Version 2.0 (the "License");
// you may not use this file except in compliance with the License.
// You may obtain a copy of the License at
//
//     http://www.apache.org/licenses/LICENSE-2.0
//
// Unless required by applicable law or agreed to in writing, software
// distributed under the License is distributed on an "AS IS" BASIS,
// WITHOUT WARRANTIES OR CONDITIONS OF ANY KIND, either express or implied.
// See the License for the specific language governing permissions and
// limitations under the License.

#include "fw/moteus_hw.h"

#include "mjlib/base/assert.h"

#include "fw/stm32_bitbang_spi.h"
#include "fw/stm32g4_adc.h"

namespace moteus {

namespace {
//////////////////////////////////////////
// moteus - family 0

// The following silks correspond with the following hardware
// revisions:
//
//  "r1"           - 0
//  "r2"           - 1
//  "r3"           - 2
//  "r4.1"         - 3
//  "r4.2", "r4.3" - 4
//  "r4.4"         - 5
//  "r4.5"         - 6
//  "r4.5b"-"r4.8" - 7
//  "r4.11"        - 8

// The mapping between  and the version pins on the
// board.
constexpr int kFamily0HardwareInterlock[] = {
  -1,  // r1 (never printed for g4)
  -1,  // r2 (never printed for g4)
  -1,  // r3 (never printed for g4)
  0,   // r4.1
  0,   // r4.2/r4.3 (unfortunately, indistinguishable from the interlock)
  1,   // r4.4
  2,   // r4.5
  3,   // r4.5b-r4.8
  4,   // r4.10
};

bool DetectGateDriver(
    MillisecondTimer* timer,
    PinName drv8353_cs,
    PinName drv8353_enable,
    PinName drv8353_mosi,
    PinName drv8353_miso,
    PinName drv8353_sck) {
  DigitalOut enable(drv8353_enable, 1);

  timer->wait_us(1000);

  Stm32BitbangSpi maybe_drv8323(
      timer,
      [&]() {
        Stm32BitbangSpi::Options out;
        out.mosi = drv8353_mosi;
        out.miso = drv8353_miso;
        out.sck = drv8353_sck;
        out.cs = drv8353_cs;

        // We can use a slow speed since this is just a one-time
        // test.
        out.frequency = 500000;
        return out;
      }());
  pin_mode(drv8353_miso, PullUp);
  auto read_reg =
      [&](int reg) {
        timer->wait_us(1);
        return maybe_drv8323.write(0x8000 | (reg << 11)) & 0x7ff;
      };
  bool found = false;
  for (int reg = 2; reg < 6; reg++) {
    const auto value = read_reg(reg);
    if (value != 0x7ff && value != 0) {
      found = true;
      break;
    }
  }


  return found;
}

}

FamilyAndVersion DetectMoteusFamily(MillisecondTimer* timer) {
  FamilyAndVersion result;
  result.family = 0;

  uint8_t family_pullup = 0;
  {
    DigitalIn family_detect_a(PB_10, PullUp);
    DigitalIn family_detect_b(PB_11, PullUp);
    timer->wait_us(10);
    family_pullup =
        (family_detect_a.read() ? 1 : 0) |
        (family_detect_b.read() ? 2 : 0);
  }
  uint8_t family_pulldown = 0;
  {
    DigitalIn family_detect_a(PB_10, PullDown);
    DigitalIn family_detect_b(PB_11, PullDown);
    timer->wait_us(10);
    family_pulldown =
        (family_detect_a.read() ? 1 : 0) |
        (family_detect_b.read() ? 2 : 0);
  }
  const uint8_t family_code = (family_pullup | family_pulldown << 2);

  {
    // Family 2 boards can be identified by the external pull down on
    // PB10 and PB11 being floating.
    if (family_code == 0x02) {
      result.family = 2;
    } else if (family_code == 0x03) {
      // If both are floating, then we are family 0 or 1.

      // We check for family 1, "moteus n1", by seeing if we can find a
      // DRV8323 on a chip select that is different from that used on all
      // family 0 boards.
      while (true) {
        timer->wait_ms(2);
        {
          // Ensure that on family 0 boards, the drv8323 will be not
          // selected.
          DigitalOut family0_drv8323_cs(PC_4, 1);

          if (DetectGateDriver(timer,
                               PB_0, // CS
                               PC_14, // enable
                               PC_13, // MOSI,
                               PC_11, // MISO,
                               PC_10) // SCK
              ) {
            result.family = 1;
            break;
          }
        }
        if (result.family == 0) {
          // Verify we are actually on a moteus-r4 by looking for its gate
          // driver.
          if (!DetectGateDriver(timer,
                                PC_4, // CS
                                PA_3, // enable
                                PA_7, // MOSI,
                                PA_6, // MISO,
                                PA_5) // SCK
              ) {
            // If we can detect a gate driver in neither place, loop back
            // and try again after a while.  Maybe the input voltage is
            // just slewing up *really* slowly and our gate driver is not
            // at a voltage level where it will work yet.
            continue;
          }
          // Yes, we are on a r4.
          break;
        }
      }
    } else {
      // Unknown family.  Just die as we don't support whatever it is.
      MJ_ASSERT(false);
    }
  }

  if (result.family == 0) {
    DigitalIn hwrev0(PC_6, PullUp);
    DigitalIn hwrev1(PA_15, PullUp);
    // Previously this was documented as PC_13, however we never
    // pulled it down, and decided to use PC_13 for something else.
    DigitalIn hwrev2(PA_10, PullUp);

    timer->wait_ms(1);

    const uint8_t this_hw_pins =
        0x07 & (~(hwrev0.read() |
                  (hwrev1.read() << 1) |
                  (hwrev2.read() << 2)));
    result.hw_pins = this_hw_pins;
    const uint8_t measured_hw_rev =
        [&]() {
          int i = 0;
          for (auto rev_pins : kFamily0HardwareInterlock) {
            if (rev_pins == this_hw_pins) { return i; }
            i++;
          }
          return -1;
        }();
    result.hw_version = measured_hw_rev;
  } else if (result.family == 1 || result.family == 2) {
    __HAL_RCC_ADC12_CLK_ENABLE();

    DisableAdc(ADC2);

    // Our board version is programmed with a high impedance voltage
    // divider, so we need to custom program the ADC to get a large
    // sample time and to ensure the prescaler is set to a usable value.

    ADC12_COMMON->CCR = (7 << ADC_CCR_PRESC_Pos);  // 16x prescaler

    ADC2->SMPR2 = (0x7 << ADC_SMPR2_SMP17_Pos);  // 640.5 ADC clock cycles
    ADC2->SQR1 =
        (17 << ADC_SQR1_SQ1_Pos) |  // IN17
        (0 << ADC_SQR1_L_Pos);  // length 1

    EnableAdc(timer, ADC2, 16, 0);

    ADC2->CR |= ADC_CR_ADSTART;
    while ((ADC2->ISR & ADC_ISR_EOC) == 0);

    const uint16_t this_reading = ADC2->DR << 4;

    if (result.family == 1) {
      if (this_reading < 0x0200) {
        // silk moteus r1.2
        result.hw_version = 0;
      } else if (this_reading > 0xfe00) {
        // silk moteus r1.3
        result.hw_version = 1;
      } else {
        // Unknown version.
        result.hw_version = -1;
      }
    } else if (result.family == 2) {
      // We don't have any uniformly specified versions yet.
      result.hw_version = 0;
    }
  } else {
    MJ_ASSERT(false);
  }

  return result;
}

namespace {
PinName unsupported() {
  mbed_die();
  return NC;
}
}

MoteusHwPins FindHardwarePins(FamilyAndVersion fv) {
  MoteusHwPins result;

  const auto hv = fv.hw_version;

  if (fv.family == 0) {
    result.vsense =
        (hv <= 4 ? PA_8 :
         hv >= 5 ? PB_12_ALT0 :
         unsupported());

    result.msense =
        // Note, the hv <=3 versions don't actually have a motor sense
        // ADC at all.  So we just pick it the same as the other
        // temperature sense so that things don't get broken.
        (hv <= 3 ? PA_9 :
         hv == 4 ? PB_12 :
         hv >= 5 ? PA_8 :
         unsupported());

    result.vsense_adc_scale =
        (hv <= 5 ? 0.00884f : 0.017947f);

    result.uart_tx = PC_10_ALT0;
    result.uart_rx = PC_11_ALT0;

    result.drv8323_enable = PA_3;
    result.drv8323_hiz = PB_7;
    result.drv8323_cs = PC_4;

    result.drv8323_mosi = PA_7;
    result.drv8323_miso = PA_6;
    result.drv8323_sck = PA_5;
    result.drv8323_fault = PB_6;

    result.debug_led1 = PF_0;
    result.power_led = PF_1;

    // We've picked these particular pins so that all 3 channels are
    // one of the "slow" channels so they will have similar analog
    // performance characteristics.
    result.current1 = PB_0_ALT0;
    result.current2 = PB_1;
    result.current3 = PB_2;

    result.as5047_cs = PB_11;

    result.can_td = PA_12;
    result.can_rd = PA_11;

    result.debug1 = PC_14;
    result.debug2 = PC_15;


    result.power_P_l_W = 900.0f;
    result.power_V_l = 30.0f;

    result.power_P_h_W = 400.0f;
    result.power_V_h = 38.0f;
  } else if (fv.family == 1 || fv.family == 2) {
    result.drv8323_enable = PC_14;
    result.drv8323_hiz = PC_15;
    result.drv8323_cs = PB_0;

    result.drv8323_mosi = PC_13;
    result.drv8323_miso = PC_11;
    result.drv8323_sck = PC_10;
    result.drv8323_fault = PB_13;

    result.debug_led1 = PB_15;
    result.power_led = PC_6;

    // Family 1 devices should have all current sense inputs on "fast"
    // channels.
    result.current1 = PA_3;       // ADC1
    result.current2 = PA_6;       // ADC2  // current 2
    result.current3 = PB_1_ALT0;  // ADC3  // current 3


    result.vsense = PA_9;         // ADC5_IN2
    result.tsense = PB_12_ALT0;   // ADC4
    result.msense = PA_8;         // ADC5_IN1

    result.vsense_adc_scale = 0.017947f;

    result.uart_tx = NC;
    result.uart_rx = NC;

    result.as5047_cs = PB_2;

    result.can_td = PB_6;
    result.can_rd = PB_5;

    result.debug1 = NC;
    result.debug2 = NC;

    if (fv.family == 1) {
      // moteus-n1

      result.power_P_l_W = 2000.0f;
      result.power_V_l = 36.0f;

      result.power_P_h_W = 1000.0f;
      result.power_V_h = 44.0f;
    } else if (fv.family == 2) {
      // moteus-c1

      result.power_P_l_W = 250.0f;
      result.power_V_l = 28.0f;

      result.power_P_h_W = 150.0f;
      result.power_V_h = 41.0f;
    } else {
      MJ_ASSERT(false);
    }
  } else {
    MJ_ASSERT(false);
  }

  return result;
}

void MoteusEnsureOff() {
  gpio_t power;
  gpio_init_out(&power, moteus::g_hw_pins.drv8323_hiz);
  gpio_write(&power, 0);

  // Also, disable the DRV8323 entirely, because, hey, why not.
  gpio_t enable;
  gpio_init_out(&enable, moteus::g_hw_pins.drv8323_enable);
  gpio_write(&enable, 0);

  // We want to ensure that our primary interrupt is not running.
  // Which one it is could vary, so just turn them all off.
  NVIC_DisableIRQ(TIM2_IRQn);
  NVIC_DisableIRQ(TIM3_IRQn);
  NVIC_DisableIRQ(TIM4_IRQn);
  NVIC_DisableIRQ(TIM5_IRQn);
}

}
