lingluo831/mymoteus/fw/stm32_i2c.h

// Copyright 2023 mjbots Robotic Systems, LLC.  info@mjbots.com
//
// Licensed under the Apache License, Version 2.0 (the "License");
// you may not use this file except in compliance with the License.
// You may obtain a copy of the License at
//
//     http://www.apache.org/licenses/LICENSE-2.0
//
// Unless required by applicable law or agreed to in writing, software
// distributed under the License is distributed on an "AS IS" BASIS,
// WITHOUT WARRANTIES OR CONDITIONS OF ANY KIND, either express or implied.
// See the License for the specific language governing permissions and
// limitations under the License.

#pragma once

#include "mbed.h"

#include "mjlib/base/string_span.h"

#include "fw/stm32_i2c_timing.h"

namespace moteus {

class Stm32I2c {
 public:
  struct Options {
    PinName sda = NC;
    PinName scl = NC;
    int frequency = 400000;
    I2cMode i2c_mode = I2cMode::kFast;
  };

  Stm32I2c(const Options& options) : options_(options) {
    Initialize();
  }

  void Initialize() {
    i2c_init(&mbed_i2c_, options_.sda, options_.scl);
    i2c_ = mbed_i2c_.i2c.handle.Instance;
    // The mbed libraries only generate timings for a small number of
    // fixed scenarios.  We aren't in those, so we'll rely on a number
    // from CubeMX.
    i2c_->CR1 &= ~(I2C_CR1_PE);

    // PE must be low for a bit, so wait.
    for (int i = 0; i < 1000; i++);

    // Now figure out the actual timing values.
    TimingInput timing_input;
    timing_input.peripheral_hz = HAL_RCC_GetSysClockFreq();
    timing_input.i2c_hz = options_.frequency;
    timing_input.i2c_mode = options_.i2c_mode;

    const auto timing = CalculateI2cTiming(timing_input);
    if (timing.error) {
      // These values weren't achievable.  Mark everything as an
      // error.
      valid_ = false;
    } else {
      valid_ = true;
      i2c_->CR1 =
          (timing.digital_noise_filter << I2C_CR1_DNF_Pos) |
          (((timing_input.analog_filter == AnalogFilter::kOff)
            ? 1 : 0) << I2C_CR1_ANFOFF_Pos) |
          0;
      i2c_->TIMINGR = timing.timingr;
    }

    // Now re-enable and wait a bit.
    i2c_->CR1 |= (I2C_CR1_PE);
    for (int i = 0; i < 1000; i++);
  }

  void StartReadMemory(uint8_t slave_address,
                       uint8_t address,
                       mjlib::base::string_span data) {
    if (!valid_) { return; }
    if (mode_ != Mode::kIdle ||
        (i2c_->CR2 & I2C_CR2_START) != 0 ||
        (i2c_->ISR & I2C_ISR_BUSY) != 0) {
      mode_ = Mode::kError;
      return;
    }

    slave_address_ = slave_address;
    rx_data_ = data;

    i2c_->ICR |= (I2C_ICR_STOPCF | I2C_ICR_NACKCF);

    i2c_->CR2 = (
        I2C_CR2_START |
        // I2C_CR2_RD_WRN | // we are writing the address to read from
        // I2C_CR2_AUTOEND | // we are going to send a repeated start
        (1 << I2C_CR2_NBYTES_Pos) |
        ((slave_address_ << 1) << I2C_CR2_SADD_Pos) |
        0);
    i2c_->TXDR = address;

    mode_ = Mode::kSentRegisterRead;
  }

  void StartWriteMemory(uint8_t slave_address,
                        uint8_t address,
                        std::string_view data) {
    if (!valid_) { return; }
    if (mode_ != Mode::kIdle ||
        (i2c_->CR2 & I2C_CR2_START) != 0 ||
        (i2c_->ISR & I2C_ISR_BUSY) != 0) {
      mode_ = Mode::kError;
      return;
    }

    tx_data_ = data;

    i2c_->CR2 = (
        I2C_CR2_START |
        I2C_CR2_AUTOEND |
        ((1 + data.size()) << I2C_CR2_NBYTES_Pos) |
        ((slave_address << 1) << I2C_CR2_SADD_Pos) |
        0);
    i2c_->TXDR = address;

    offset_ = 0;
    mode_ = Mode::kWritingData;
  }

  enum class ReadStatus {
    kNoStatus,
    kComplete,
    kError,
  };

  ReadStatus CheckRead() {
    if (!valid_) {
      return ReadStatus::kError;
    }

    if (mode_ == Mode::kComplete) {
      mode_ = Mode::kIdle;
      return ReadStatus::kComplete;
    }
    if (mode_ == Mode::kError) {
      // Re-initialize.
      i2c_->CR1 &= ~(I2C_CR1_PE);

      if ((i2c_->CR1 & I2C_CR1_PE) == 0) {
        // The peripheral is off and ready be re-enabled.
        mode_ = Mode::kIdle;
        i2c_->CR1 |= I2C_CR1_PE;
      }

      return ReadStatus::kError;
    }
    return ReadStatus::kNoStatus;
  }

  void Poll() {
    switch (mode_) {
      case Mode::kIdle:
      case Mode::kComplete:
      case Mode::kError: {
        break;
      }
      case Mode::kSentRegisterRead: {
        if ((i2c_->ISR & I2C_ISR_TC) == 0) {
          break;
        }

        // Clear any NACKs
        i2c_->ICR |= I2C_ICR_NACKCF;

        // Now we send our repeated start to retrieve the result.
        i2c_->CR2 =
            (I2C_CR2_START |
             I2C_CR2_RD_WRN |  // we need to read the data
             I2C_CR2_AUTOEND |
             ((slave_address_ << 1) << I2C_CR2_SADD_Pos) |
             (rx_data_.size() << I2C_CR2_NBYTES_Pos) |
             0);

        offset_ = 0;
        mode_ = Mode::kReadingData;

        break;
      }
      case Mode::kReadingData: {
        if ((i2c_->ISR & I2C_ISR_RXNE) == 0) {
          break;
        }

        // We have data.
        rx_data_[offset_++] = i2c_->RXDR;

        if (offset_ >= rx_data_.size()) {
          // Clear any NACKs
          i2c_->ICR |= I2C_ICR_NACKCF;

          mode_ = Mode::kComplete;
        }

        break;
      }
      case Mode::kWritingData: {
        if ((i2c_->ISR & I2C_ISR_TXE) == 0) {
          break;
        }

        // We can send the next byte.
        if (offset_ >= static_cast<int32_t>(tx_data_.size())) {
          // We are done.
          i2c_->ICR |= I2C_ICR_NACKCF;

          mode_ = Mode::kComplete;
        } else {
          i2c_->TXDR = tx_data_[offset_];
          offset_++;
        }
        break;
      }
    }

    if (i2c_->ISR & I2C_ISR_NACKF) {
      mode_ = Mode::kError;
      i2c_->ICR |= I2C_ICR_NACKCF;
      return;
    }
  }

  bool busy() const {
    switch (mode_) {
      case Mode::kIdle:
      case Mode::kComplete:
      case Mode::kError: {
        return false;
      }
      case Mode::kSentRegisterRead:
      case Mode::kReadingData:
      case Mode::kWritingData: {
        return true;
      }
    }
    MJ_ASSERT(false);
    return false;
  }

 private:
  const Options options_;
  bool valid_ = false;
  i2c_t mbed_i2c_;

  enum class Mode {
    kIdle,
    kSentRegisterRead,
    kReadingData,
    kWritingData,
    kComplete,
    kError,
  };

  Mode mode_ = Mode::kIdle;
  I2C_TypeDef* i2c_ = nullptr;
  uint8_t slave_address_ = 0;
  mjlib::base::string_span rx_data_;
  std::string_view tx_data_;
  int32_t offset_ = 0;
};

}
