lingluo831/mymoteus/fw/error.cc

// Copyright 2023 mjbots Robotic Systems, LLC.  info@mjbots.com
//
// Licensed under the Apache License, Version 2.0 (the "License");
// you may not use this file except in compliance with the License.
// You may obtain a copy of the License at
//
//     http://www.apache.org/licenses/LICENSE-2.0
//
// Unless required by applicable law or agreed to in writing, software
// distributed under the License is distributed on an "AS IS" BASIS,
// WITHOUT WARRANTIES OR CONDITIONS OF ANY KIND, either express or implied.
// See the License for the specific language governing permissions and
// limitations under the License.

#include "fw/error.h"

namespace moteus {

namespace {
struct MoteusErrorCategory : mjlib::micro::error_category {
  const char* name() const noexcept override { return "moteus"; }
  std::string_view message(int condition) const override {
    switch (static_cast<errc>(condition)) {
      case errc::kSuccess: return "success";
      case errc::kDmaStreamTransferError: return "dma stream transfer error";
      case errc::kDmaStreamFifoError: return "dma stream fifo error";
      case errc::kUartOverrunError: return "uart overrun error";
      case errc::kUartFramingError: return "uart framing error";
      case errc::kUartNoiseError: return "uart noise error";
      case errc::kUartBufferOverrunError: return "uart buffer overrun";
      case errc::kUartParityError: return "uart parity error";
      case errc::kCalibrationFault: return "calibration fault";
      case errc::kMotorDriverFault: return "motor driver fault";
      case errc::kOverVoltage: return "over voltage";
      case errc::kEncoderFault: return "encoder fault";
      case errc::kMotorNotConfigured: return "motor not configured";
      case errc::kPwmCycleOverrun: return "pwm cycle overrun";
      case errc::kOverTemperature: return "over temperature";
      case errc::kStartOutsideLimit: return "start outside limit";
      case errc::kUnderVoltage: return "under voltage";
      case errc::kConfigChanged: return "config changed";
      case errc::kThetaInvalid: return "theta invalid";
      case errc::kPositionInvalid: return "position invalid";
      case errc::kDriverEnableFault: return "driver enable";
      case errc::kStopPositionDeprecated: return "stop position deprecated";
      case errc::kTimingViolation: return "timing violation";
      case errc::kBemfFeedforwardNoAccelLimit: return "bemf no accel limit";
    }
    return "unknown";
  }
};

const mjlib::micro::error_category& moteus_error_category() {
  static MoteusErrorCategory result;
  return result;
}
}

mjlib::micro::error_code make_error_code(errc err) {
  return mjlib::micro::error_code(
      static_cast<int>(err), moteus_error_category());
}

}
