lingluo831/mymoteus/fw/torque_model.h

// Copyright 2023 mjbots Robotic Systems, LLC.  info@mjbots.com
//
// Licensed under the Apache License, Version 2.0 (the "License");
// you may not use this file except in compliance with the License.
// You may obtain a copy of the License at
//
//     http://www.apache.org/licenses/LICENSE-2.0
//
// Unless required by applicable law or agreed to in writing, software
// distributed under the License is distributed on an "AS IS" BASIS,
// WITHOUT WARRANTIES OR CONDITIONS OF ANY KIND, either express or implied.
// See the License for the specific language governing permissions and
// limitations under the License.

#pragma once

#include <algorithm>

#include "fw/math.h"

namespace moteus {

/// Provides facilities for converting to and from torque and phase
/// current for a given motor.
class TorqueModel {
 public:
  TorqueModel(float torque_constant,
              float current_cutoff_A,
              float current_scale,
              float torque_scale)
      : torque_constant_(torque_constant),
        current_cutoff_A_(current_cutoff_A),
        current_scale_(current_scale),
        torque_scale_(torque_scale) {}

  float current_to_torque(float current) const __attribute__((always_inline)) {
    // We always calculate the "rotation" region cutoff so as to have
    // a somewhat constant calculation time.
    const float rotation_extra =
        torque_scale_ *
        log2f_approx(1.0f + std::max(
                         0.0f, (std::abs(current) - current_cutoff_A_)) *
                     current_scale_);
    return ((std::abs(current) < current_cutoff_A_) ?
            // rotation_extra will always be 0 here, but we add it in
            // anyways to force the evaluation of the above code no
            // matter what.  Thus our loop timing will be relatively
            // constant even when we go into the rotation regime.
            (current * torque_constant_) :
            // In this case, rotation_extra should be non-zero.
            std::copysignf(current_cutoff_A_ * torque_constant_ +
                           rotation_extra,
                           current));
  }

  float torque_to_current(float torque) const __attribute__((always_inline)) {
    const float a = (std::abs(torque) - current_cutoff_A_ * torque_constant_) /
                    torque_scale_;
    const float rotation_extra = (pow2f_approx(a) - 1.0f) / current_scale_;
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
