lingluo831/mymoteus/(notices)

Notices in the files:
hw/controller/r4.8/controller.brd:
(c) 2021
hw/n1/r1.3/moteus_n1.brd:
(c) 2023
hw/controller/r4.11/controller.brd:
(c) 2022
hw/c1/r1.2/moteus_c1.kicad_pcb:
(c) 2024
hw/controller/r4.5/controller.brd:
(c) 2020
parts and their libraries:
power_dist: COPYRIGHT: Copyright (C) 2018 Accelerated Designs. All rights reserved
COPYRIGHT: Copyright (C) 2022 Ultra Librarian. All rights reserved.
COPYRIGHT: Copyright (C) 2023 Ultra Librarian. All rights reserved.
